cropinghigh/zynq_a9_mb/software/FPGA_VIVADO/Platform/Platform.runs/design_1_axi_vdma_0_0_synth_1/.vivado.begin.rst

<?xml version="1.0"?>
<ProcessHandle Version="1" Minor="0">
    <Process Command="vivado" Owner="indir" Host="indir-homePc" Pid="3502113" HostCore="4" HostMemory="26538112">
    </Process>
</ProcessHandle>
