cropinghigh/zynq_a9_mb/software/FPGA_VIVADO/Platform/Platform.runs/impl_1/.init_design.begin.rst

<?xml version="1.0"?>
<ProcessHandle Version="1" Minor="0">
    <Process Command=".planAhead." Owner="indir" Host="" Pid="3506964">
    </Process>
</ProcessHandle>
