cropinghigh/zynq_a9_mb/hardware/zynq_test_components_1.2.ods

Reference | Qty | Value | Footprint | Antminer S9 board reference | Red means that additional components of that value needed
BT1 | 1 | 3V | Connector_PinHeader_2.54mm:PinHeader_1x02_P2.54mm_Vertical |  | Yellow means value isn’t present on Antimer S9 board, or is far from required count
C1, C2, C3, C4, C5, C6, C7, C8, C9, C10, C16, C17, C51, C52, C53, C54, C59, C60, C61, C64, C65, C66, C67, C68, C69, C70, C71, C72, C73, C75, C76, C79, C80, C81, C82, C88, C94, C96, C105, C112, C114, C144, C146, C148, C149, C157, C171, C179, C182, C183, C188, C190, C191, C198, C200, C201, C210, C211, C214, C216 | 60 | 10u | Capacitor_SMD:C_0603_1608Metric
C11, C12, C13, C14, C15 | 5 | 3.3n | Capacitor_SMD:C_0402_1005Metric_Pad0.74x0.62mm_HandSolder | C207, C208, C215, C216, C224
C18, C19, C20, C21, C23, C28, C29, C30, C31, C32, C33, C34, C35, C36, C37, C38, C39, C40, C41, C42, C43, C44, C45, C46, C47, C48, C49, C50, C55, C56, C57, C58, C62, C63, C87, C89, C90, C92, C93, C95, C97, C98, C99, C100, C101, C103, C104, C106, C107, C108, C109, C110, C111, C115, C116, C117, C118, C119, C120, C121, C122, C123, C124, C125, C126, C127, C128, C129, C130, C131, C132, C133, C134, C135, C136, C137, C138, C139, C141, C143, C145, C147, C150, C151, C152, C153, C154, C156, C158, C159, C160, C163, C164, C165, C166, C167, C168, C169, C170, C172, C173, C174, C175, C176, C177, C178, C180, C181, C184, C185, C187, C189, C192, C193, C194, C195, C196, C197, C202, C203, C204, C205, C206, C207, C208, C209, C212, C213, C215, C217 | 130 | 0.47u | Capacitor_SMD:C_0603_1608Metric
C22, C24, C25, C26, C27 | 5 | 22u | Capacitor_SMD:C_0805_2012Metric_Pad1.18x1.45mm_HandSolder | C203, C206, C212, C214, C219
C74, C77, C78, C83, C84, C85, C86, C91, C102, C113, C140, C142, C155, C199 | 14 | 100u | Capacitor_SMD:C_1206_3216Metric_Pad1.33x1.80mm_HandSolder | C10,C14,C23,C24,C34,C43,C56,C57,C58,C71,C79,C88,C92,C104,C124
C161, C162 | 2 | 12p | Capacitor_SMD:C_0402_1005Metric_Pad0.74x0.62mm_HandSolder | C171, C172
C186 | 1 | 1n | Capacitor_SMD:C_1206_3216Metric_Pad1.33x1.80mm_HandSolder | C167
D1 | 1 | ZMM7V5 | Diode_SMD:D_MiniMELF_Handsoldering
D2, D17, D21 | 3 | 1N5822 | Diode_SMD:D_SMA
D3 | 1 | GREEN PWR_OK | LED_SMD:LED_0603_1608Metric_Pad1.05x0.95mm_HandSolder
D4 | 1 | GREEN 5V | LED_SMD:LED_0603_1608Metric_Pad1.05x0.95mm_HandSolder
D5 | 1 | GREEN 2V5 | LED_SMD:LED_0603_1608Metric_Pad1.05x0.95mm_HandSolder
D6 | 1 | GREEN 3V3 | LED_SMD:LED_0603_1608Metric_Pad1.05x0.95mm_HandSolder
D7 | 1 | YELLOW INIT_B | LED_SMD:LED_0603_1608Metric_Pad1.05x0.95mm_HandSolder
D8 | 1 | GREEN DONE | LED_SMD:LED_0603_1608Metric_Pad1.05x0.95mm_HandSolder
D9 | 1 | GREEN IO1 | LED_SMD:LED_0603_1608Metric_Pad1.05x0.95mm_HandSolder
D10 | 1 | RED IO2 | LED_SMD:LED_0603_1608Metric_Pad1.05x0.95mm_HandSolder
D11 | 1 | BLUE IO3 | LED_SMD:LED_0603_1608Metric_Pad1.05x0.95mm_HandSolder
D12 | 1 | YELLOW IO4 | LED_SMD:LED_0603_1608Metric_Pad1.05x0.95mm_HandSolder
D13, D14, D15, D22 | 4 | CDDFN10-0524P | Package_DFN_QFN:Diodes_UDFN-10_1.0x2.5mm_P0.5mm
D16 | 1 | BLUE ETH_LED1 | LED_SMD:LED_0603_1608Metric_Pad1.05x0.95mm_HandSolder
D18 | 1 | YELLOW MIO0 | LED_SMD:LED_0603_1608Metric_Pad1.05x0.95mm_HandSolder
D19 | 1 | GREEN MIO7 | LED_SMD:LED_0603_1608Metric_Pad1.05x0.95mm_HandSolder
D20 | 1 | RED MIO8 | LED_SMD:LED_0603_1608Metric_Pad1.05x0.95mm_HandSolder
D23 | 1 | RED USB OVERLOAD | LED_SMD:LED_0603_1608Metric_Pad1.05x0.95mm_HandSolder
F1 | 1 | PWRIN_CONN | Fuse:Fuse_1206_3216Metric
F2 | 1 | PWR_USB | Fuse:Fuse_1206_3216Metric
FB1, FB2, FB3, FB4, FB5, FB6, FB10, FB11, FB12, FB13, FB14, FB18 | 12 | 100R | Inductor_SMD:L_1206_3216Metric_Pad1.42x1.75mm_HandSolder
FB7, FB8, FB9, FB15, FB16, FB17 | 6 | 100R/3A | Inductor_SMD:L_0805_2012Metric_Pad1.15x1.40mm_HandSolder | FB1, FB2, FB3, FB4, FB5, FB6
J1 | 1 | PWRIN | Connector_BarrelJack:BarrelJack_Horizontal
J2 | 1 | JTAG_SMALL | Connector_PinHeader_2.00mm:PinHeader_2x07_P2.00mm_Vertical
J3 | 1 | PL_IO_A | Connector_PinHeader_2.00mm:PinHeader_2x14_P2.00mm_Vertical
J4 | 1 | PL_IO_B | Connector_PinHeader_2.00mm:PinHeader_2x14_P2.00mm_Vertical
J5 | 1 | PL_IO_C | Connector_PinHeader_2.00mm:PinHeader_2x14_P2.00mm_Vertical
J6 | 1 | PL_IO_D | Connector_PinHeader_2.00mm:PinHeader_2x14_P2.00mm_Vertical
J7 | 1 | RJ45 | Connector_RJ:RJ45_Amphenol_RJHSE538X | J13
J8 | 1 | DISPLAY | Connector_PinHeader_2.00mm:PinHeader_2x11_P2.00mm_Vertical
J9 | 1 | ADC | Connector_PinHeader_2.54mm:PinHeader_1x02_P2.54mm_Vertical
J10 | 1 | UART | Connector_PinHeader_2.54mm:PinHeader_1x03_P2.54mm_Vertical
J11 | 1 | I2C | Connector_PinHeader_2.54mm:PinHeader_1x03_P2.54mm_Vertical
J12, J13 | 2 | MicroSD | footprints:microSD_ali
J14 | 1 | USB_C | Connector_USB:USB_C_Receptacle_HCTL_HC-TYPE-C-16P-01A
L1, L2, L3, L4 | 4 | 1u | Inductor_SMD:L_APV_ANR3010 | L2, L3, L4, L5
L5 | 1 | 2.2u | Inductor_SMD:L_APV_ANR8040 | L1
R1, R33, R34, R37, R38, R39, R41, R42, R43, R44, R50, R93, R103, R105, R138, R143, R146, R150, R90, R147 | 20 | 4.7k | Resistor_SMD:R_0402_1005Metric_Pad0.72x0.64mm_HandSolder | R5,R6,R7,R8,R10,R11,R15,R22,R25,R36,R58,R83,R92,R107,R110,R111,R112,R113,R114,R115,R116,R117,R118,R119,R120,R121,R122,R123,R124,R125,R126,R127,R128,R129,R130,R131,R132,R133,R134,R135,R136,R139,R140,R143,R144,R147,R148,R169,R174,R176,R177,R183,R184,R185,R186
R2 | 1 | 17.4k | Resistor_SMD:R_0402_1005Metric_Pad0.72x0.64mm_HandSolder | R171
R3, R5, R7, R79, R80, R81, R82, R83, R84, R85, R86, R87, R88, R94 | 14 | 20k | Resistor_SMD:R_0402_1005Metric_Pad0.72x0.64mm_HandSolder | R1, R2, R3, R4, R28, R29, R30, R157, R165, R173, R175
R4 | 1 | 24.9k | Resistor_SMD:R_0402_1005Metric_Pad0.72x0.64mm_HandSolder | R161
R6, R46 | 2 | 42.2k | Resistor_SMD:R_0402_1005Metric_Pad0.72x0.64mm_HandSolder | R152
R8, R29 | 2 | 61.9k | Resistor_SMD:R_0402_1005Metric_Pad0.72x0.64mm_HandSolder | R159
R9, R11 | 2 | 19.6k | Resistor_SMD:R_0402_1005Metric_Pad0.72x0.64mm_HandSolder | R156, R166
R10, R17, R19, R21, R23, R25 | 6 | 4.99k | Resistor_SMD:R_0402_1005Metric_Pad0.72x0.64mm_HandSolder | R150, R154, R155, R163, R164,R172
R12, R13, R14, R15, R51, R52, R113, R124, R125, R126, R151, R155, R158, R161 | 14 | 0 | Resistor_SMD:R_0402_1005Metric_Pad0.72x0.64mm_HandSolder | R9, R12, R13, R14, R16, R23, R85, R86, R101, R103, R105, R106
R16, R18, R20, R30, R35, R40, R100, R101, R102, R140, R141, R142, R144, R145, R156, R157, R159, R160, R92 | 19 | 1k | Resistor_SMD:R_0402_1005Metric_Pad0.72x0.64mm_HandSolder | R19,R20,R32,R33,R37,R38,R39,R50,R52,R53,R54,R88,R89,R90,R91,R108,R151,R160,R170,R187,R188,R189,R190
R22 | 1 | 1.58k | Resistor_SMD:R_0402_1005Metric_Pad0.72x0.64mm_HandSolder | R162
R24, R77, R78, R104, R106, R127, R128, R129, R130, R131, R132, R133, R134, R135, R136, R149 | 16 | 240 | Resistor_SMD:R_0402_1005Metric_Pad0.72x0.64mm_HandSolder | R55, R56, R153
R26, R27, R47 | 3 | 140k | Resistor_SMD:R_0402_1005Metric_Pad0.72x0.64mm_HandSolder
R28, R107 | 2 | 15k | Resistor_SMD:R_0402_1005Metric_Pad0.72x0.64mm_HandSolder
R31, R32, R137, R154 | 4 | 8k | Resistor_SMD:R_0402_1005Metric_Pad0.72x0.64mm_HandSolder
R36, R152, R153 | 3 | 200k | Resistor_SMD:R_0402_1005Metric_Pad0.72x0.64mm_HandSolder | R21, R87
R45, R53, R54, R55, R56, R57, R59, R60, R61, R62, R63, R64, R65, R66, R67, R68, R69, R70, R71, R72, R73, R74, R75, R76, R89, R95, R96, R97, R98, R112, R114, R115, R116, R117, R118, R119, R120, R121, R122, R123, R139 | 41 | 40 | Resistor_SMD:R_0402_1005Metric_Pad0.72x0.64mm_HandSolder | R59, R60,R61, R62, R63, R64, R65, R66, R67, R68, R69, R70, R71, R72, R73, R74, R75, R76, R77, R78, R79, R80, R81, R82
R48, R49, R58, R108, R109, R110, R111 | 7 | 80 | Resistor_SMD:R_0402_1005Metric_Pad0.72x0.64mm_HandSolder | R40, R41, R42, R95, R96, R97, R98
R91, R148, R162, R163 | 4 | 820 | Resistor_SMD:R_0402_1005Metric_Pad0.72x0.64mm_HandSolder
R99 | 1 | 1.24k | Resistor_SMD:R_0402_1005Metric_Pad0.72x0.64mm_HandSolder | R109
SW1 | 1 | POR | Button_Switch_THT:SW_SPST_Omron_B3F-315x_Angled | S1
SW2 | 1 | BOOT_MODE_1 | Button_Switch_SMD:SW_SPDT_PCM12
SW3 | 1 | BOOT_MODE_2 | Button_Switch_SMD:SW_SPDT_PCM12
SW4 | 1 | SD_SEL | Button_Switch_SMD:SW_SPDT_PCM12
TR1 | 1 | G2405CG | Transformer_SMD:Transformer_Ethernet_Bourns_PT61020EL | T1
U1, U2, U3, U4, U5 | 5 | TLV62130RGTR | footprints:QFN50P300X300X100-17N | U9, U10, U11, U12, U13
U6 | 1 | TPS51200DRC | Package_SON:VSON-10-1EP_3x3mm_P0.5mm_EP1.65x2.4mm | U14
U7, U16, U17 | 3 | LSF0102DCTR | footprints:SOP65P400X130-8N | U2, U7
U8, U9 | 2 | nt5cc128m16ip-di | footprints:BGA96C80P6X16_800X1400X120 | U3, U4
U10 | 1 | XC7Z010-1CLG400C | footprints:CLG400_XIL-L | U1
U11 | 1 | SDIN7DP2-8G | footprints:MICRON_EMMC_153-12
U12 | 1 | MX25L1606E | Package_SO:SOIC-8_5.3x5.3mm_P1.27mm
U13 | 1 | B50612 | Package_DFN_QFN:Infineon_MLPQ-48-1EP_7x7mm_P0.5mm_EP5.15x5.15mm | U8
U14 | 1 | USB3315 | Package_DFN_QFN:QFN-24-1EP_4x4mm_P0.5mm_EP2.5x2.5mm
U15 | 1 | TXS02612RTW | Package_DFN_QFN:WQFN-24-1EP_4x4mm_P0.5mm_EP2.45x2.45mm_ThermalVias | U6
U18 | 1 | DS1307Z+ | Package_SO:SOIC-8_3.9x4.9mm_P1.27mm
U19 | 1 | LM3525-H | Package_SO:SOIC-8_3.9x4.9mm_P1.27mm
Y1 | 1 | 33.333M | Oscillator:Oscillator_SMD_EuroQuartz_XO32-4Pin_3.2x2.5mm | Y1
Y2 | 1 | 25M | Oscillator:Oscillator_SMD_EuroQuartz_XO32-4Pin_3.2x2.5mm | Y4
Y3 | 1 | 32.768k | Crystal:Crystal_C38-LF_D3.0mm_L8.0mm_Vertical
Y4 | 1 | 24M | Oscillator:Oscillator_SMD_EuroQuartz_XO53-4Pin_5.0x3.2mm
