cropinghigh/zynq_a9_mb/hardware/LSF0102DCTR.step

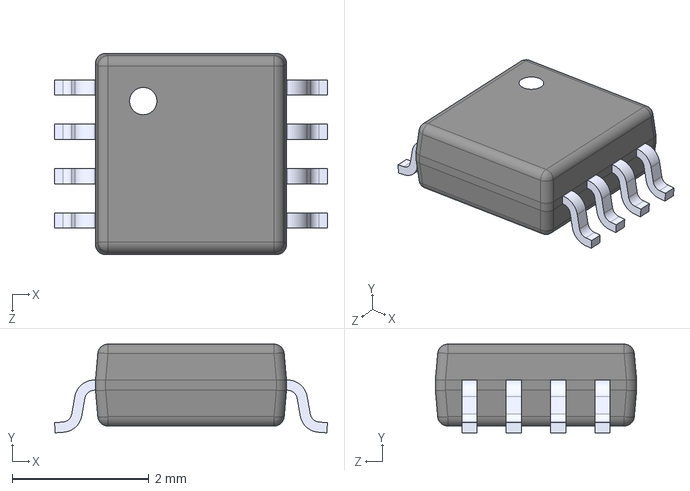
[picture p34: CAD file, 2025-09-22]
hardware/LSF0102DCTR.step
4.00 x 1.30 x 2.95 mm
