cropinghigh/zynq_a9_mb/hardware/MT41J128M16JT-125_KTR.step

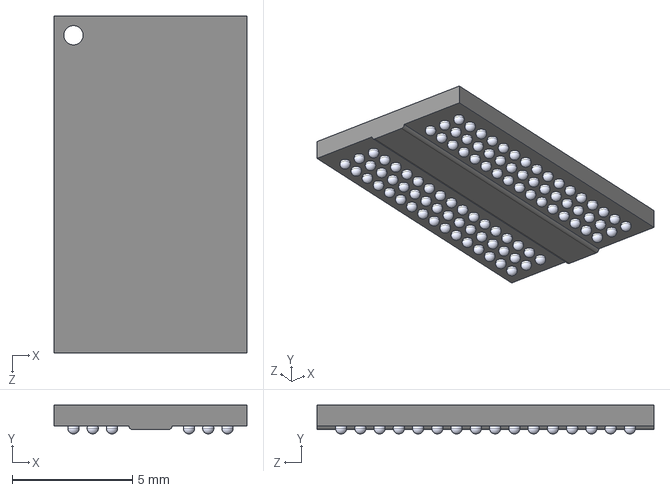
[picture p35: CAD file, 2025-09-22]
hardware/MT41J128M16JT-125_KTR.step
8.00 x 1.20 x 14.0 mm
