cropinghigh/zynq_a9_mb/hardware/EMMC04G-S100-B08U.step

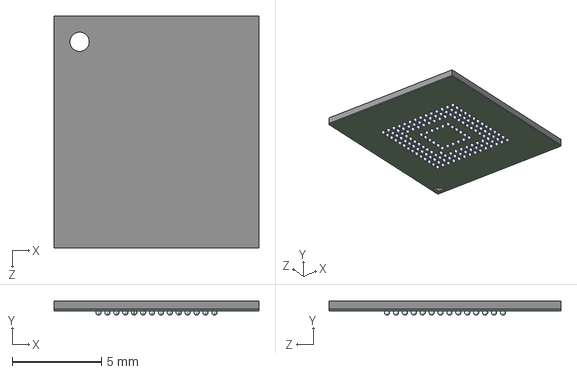
[picture p36: CAD file, 2025-09-22]
hardware/EMMC04G-S100-B08U.step
11.5 x 0.8 x 13.0 mm
