cropinghigh/zynq_a9_mb/hardware/TLV62130RGTR.step

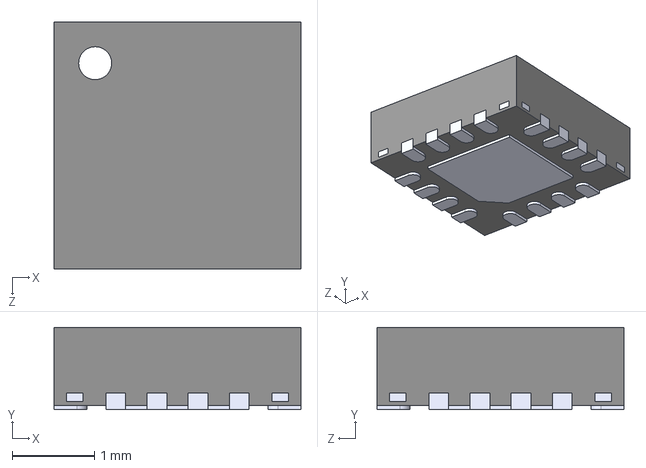
[picture p37: CAD file, 2025-09-22]
hardware/TLV62130RGTR.step
3.00 x 1.00 x 3.00 mm
