cropinghigh/zynq_a9_mb/hardware/schematic.pdf

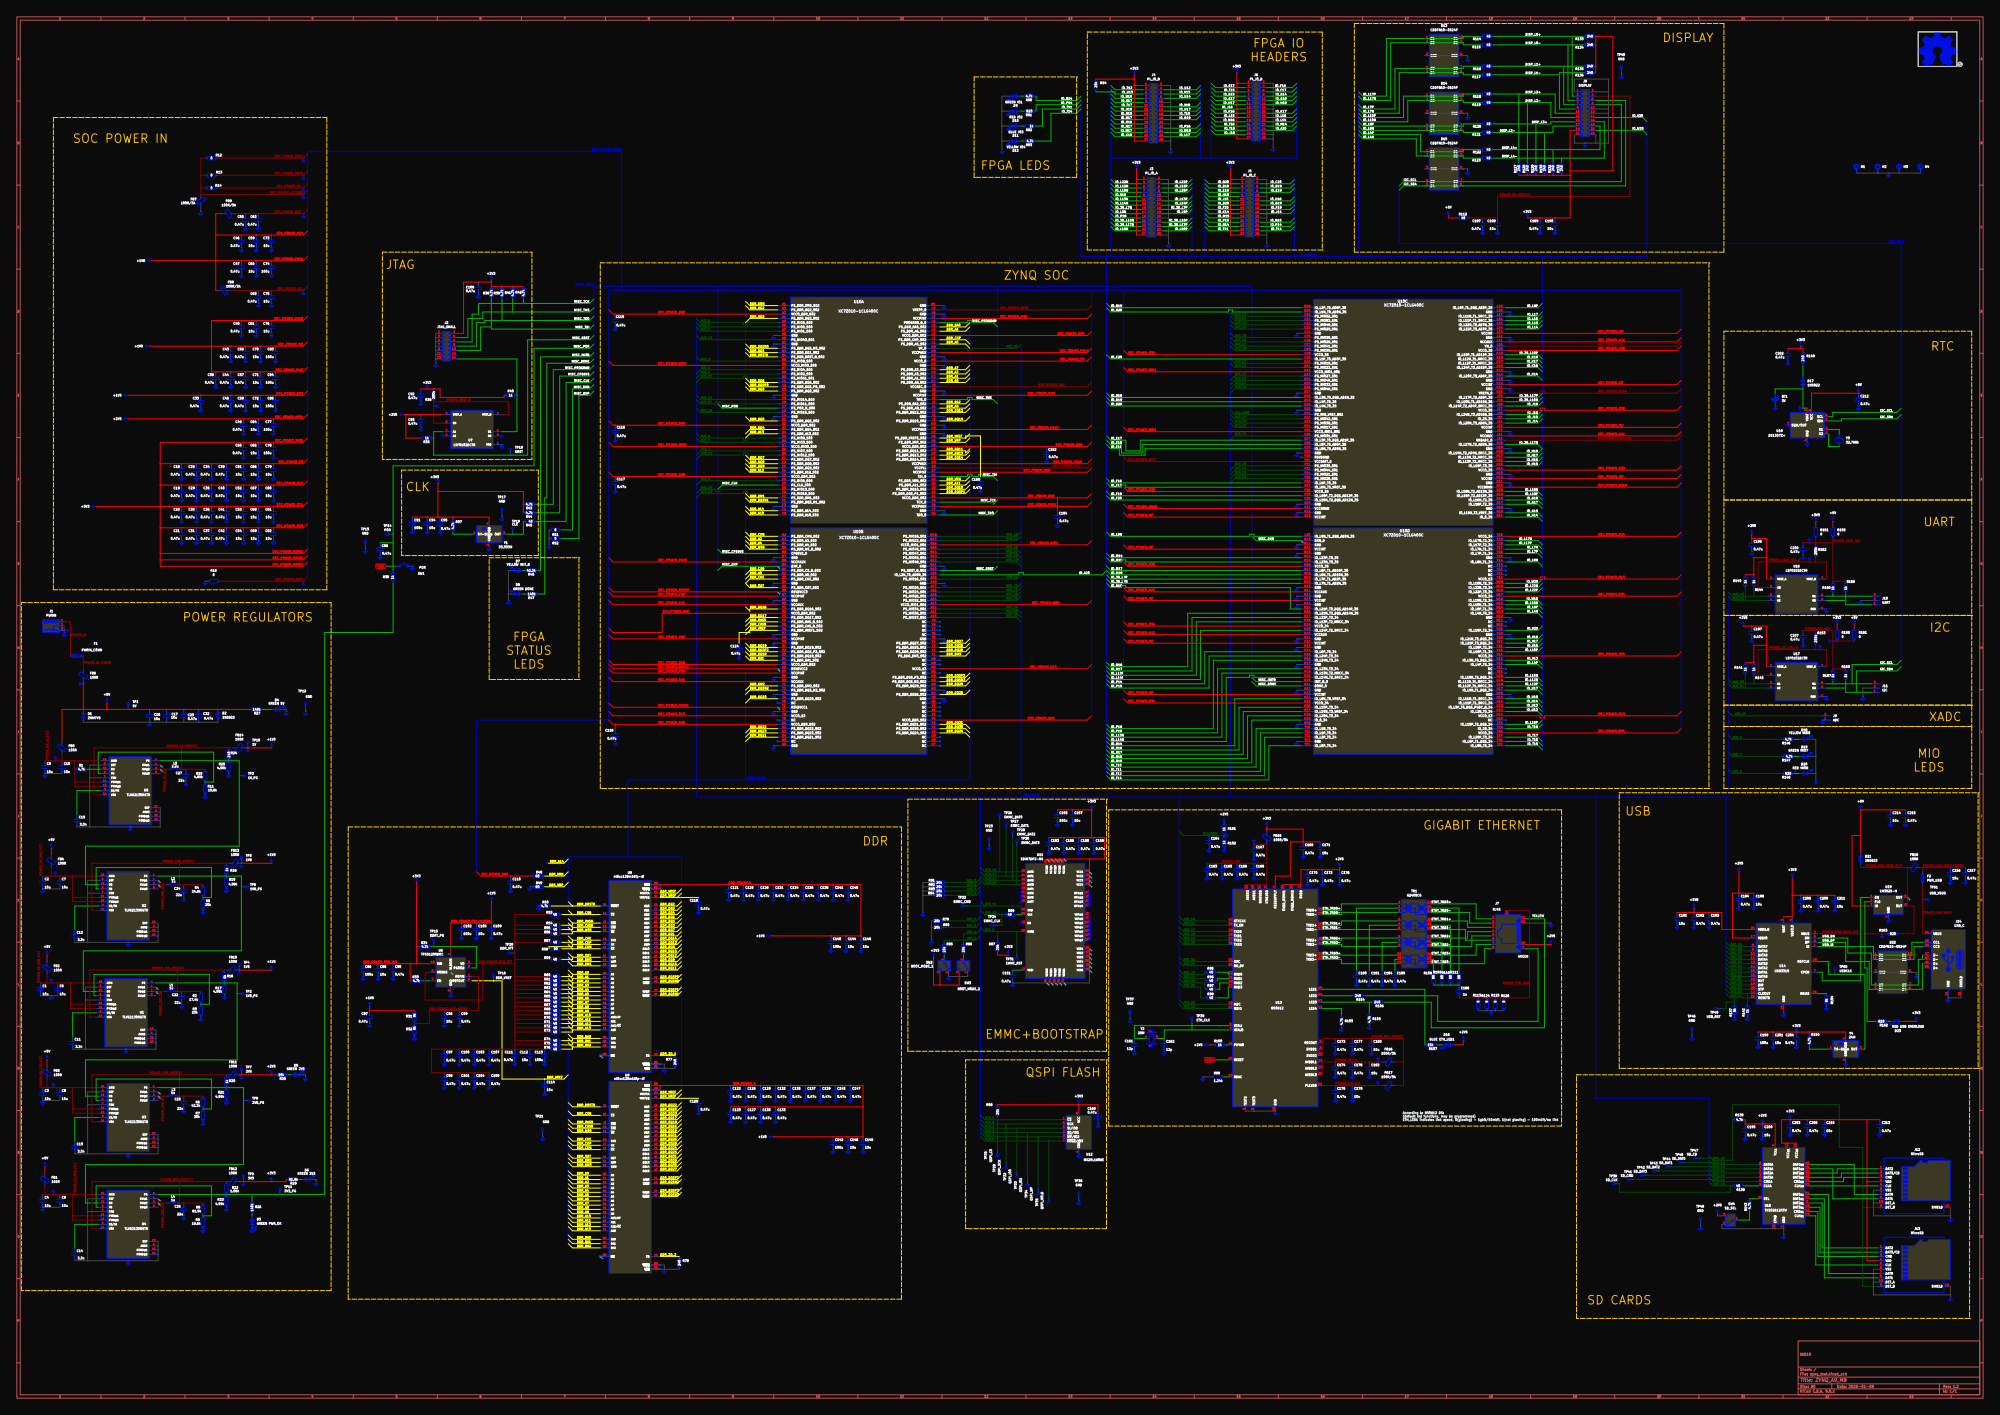
[picture p38: page 1]
