cropinghigh/zynq_a9_mb/software/FPGA_VIVADO/Platform/Platform.runs/design_1_processing_system7_0_0_synth_1/.Xil/design_1_processing_system7_0_0_propImpl.xdc

set_property SRC_FILE_INFO {cfile:/home/indir/KiCad/zynq_a9_mb/software/FPGA_VIVADO/Platform/Platform.gen/sources_1/bd/design_1/ip/design_1_processing_system7_0_0/design_1_processing_system7_0_0.xdc rfile:../../../Platform.gen/sources_1/bd/design_1/ip/design_1_processing_system7_0_0/design_1_processing_system7_0_0.xdc id:1 order:EARLY scoped_inst:inst} [current_design]
current_instance inst
set_property src_info {type:SCOPED_XDC file:1 line:20 export:INPUT save:INPUT read:READ} [current_design]
set_output_delay -clock [get_clocks PJTAG_TCK] -clock_fall -min -6.000 [get_ports PJTAG_TDO]
set_property src_info {type:SCOPED_XDC file:1 line:21 export:INPUT save:INPUT read:READ} [current_design]
set_output_delay -clock [get_clocks PJTAG_TCK] -clock_fall -max 15.000 [get_ports PJTAG_TDO]
set_property src_info {type:SCOPED_XDC file:1 line:22 export:INPUT save:INPUT read:READ} [current_design]
set_output_delay -clock [get_clocks PJTAG_TCK] -clock_fall -min 6.000 [get_ports PJTAG_TDO]
set_property src_info {type:SCOPED_XDC file:1 line:23 export:INPUT save:INPUT read:READ} [current_design]
set_output_delay -clock [get_clocks PJTAG_TCK] -clock_fall -max 15.000 [get_ports PJTAG_TDO]
set_property src_info {type:SCOPED_XDC file:1 line:28 export:INPUT save:INPUT read:READ} [current_design]
set_input_jitter clk_fpga_0 30
set_property src_info {type:SCOPED_XDC file:1 line:31 export:INPUT save:INPUT read:READ} [current_design]
set_input_jitter clk_fpga_1 0.6
set_property src_info {type:SCOPED_XDC file:1 line:34 export:INPUT save:INPUT read:READ} [current_design]
set_input_jitter clk_fpga_2 0.3
set_property src_info {type:SCOPED_XDC file:1 line:37 export:INPUT save:INPUT read:READ} [current_design]
set_input_jitter clk_fpga_3 0.19497
set_property src_info {type:SCOPED_XDC file:1 line:47 export:INPUT save:INPUT read:READ} [current_design]
set_property PACKAGE_PIN "C11" [get_ports "MIO[53]"]
set_property src_info {type:SCOPED_XDC file:1 line:54 export:INPUT save:INPUT read:READ} [current_design]
set_property PACKAGE_PIN "C10" [get_ports "MIO[52]"]
set_property src_info {type:SCOPED_XDC file:1 line:61 export:INPUT save:INPUT read:READ} [current_design]
set_property PACKAGE_PIN "B9" [get_ports "MIO[51]"]
set_property src_info {type:SCOPED_XDC file:1 line:68 export:INPUT save:INPUT read:READ} [current_design]
set_property PACKAGE_PIN "B13" [get_ports "MIO[50]"]
set_property src_info {type:SCOPED_XDC file:1 line:75 export:INPUT save:INPUT read:READ} [current_design]
set_property PACKAGE_PIN "C12" [get_ports "MIO[49]"]
set_property src_info {type:SCOPED_XDC file:1 line:82 export:INPUT save:INPUT read:READ} [current_design]
set_property PACKAGE_PIN "B12" [get_ports "MIO[48]"]
set_property src_info {type:SCOPED_XDC file:1 line:89 export:INPUT save:INPUT read:READ} [current_design]
set_property PACKAGE_PIN "B14" [get_ports "MIO[47]"]
set_property src_info {type:SCOPED_XDC file:1 line:95 export:INPUT save:INPUT read:READ} [current_design]
set_property PACKAGE_PIN "D16" [get_ports "MIO[46]"]
set_property src_info {type:SCOPED_XDC file:1 line:102 export:INPUT save:INPUT read:READ} [current_design]
set_property PACKAGE_PIN "B15" [get_ports "MIO[45]"]
set_property src_info {type:SCOPED_XDC file:1 line:109 export:INPUT save:INPUT read:READ} [current_design]
set_property PACKAGE_PIN "F13" [get_ports "MIO[44]"]
set_property src_info {type:SCOPED_XDC file:1 line:116 export:INPUT save:INPUT read:READ} [current_design]
set_property PACKAGE_PIN "A9" [get_ports "MIO[43]"]
set_property src_info {type:SCOPED_XDC file:1 line:123 export:INPUT save:INPUT read:READ} [current_design]
set_property PACKAGE_PIN "E12" [get_ports "MIO[42]"]
set_property src_info {type:SCOPED_XDC file:1 line:130 export:INPUT save:INPUT read:READ} [current_design]
set_property PACKAGE_PIN "C17" [get_ports "MIO[41]"]
set_property src_info {type:SCOPED_XDC file:1 line:137 export:INPUT save:INPUT read:READ} [current_design]
set_property PACKAGE_PIN "D14" [get_ports "MIO[40]"]
set_property src_info {type:SCOPED_XDC file:1 line:144 export:INPUT save:INPUT read:READ} [current_design]
set_property PACKAGE_PIN "C18" [get_ports "MIO[39]"]
set_property src_info {type:SCOPED_XDC file:1 line:151 export:INPUT save:INPUT read:READ} [current_design]
set_property PACKAGE_PIN "E13" [get_ports "MIO[38]"]
set_property src_info {type:SCOPED_XDC file:1 line:158 export:INPUT save:INPUT read:READ} [current_design]
set_property PACKAGE_PIN "A10" [get_ports "MIO[37]"]
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
set_property src_info {type:SCOPED_XDC file:1 line:347 export:INPUT save:INPUT read:READ} [current_design]
set_property PACKAGE_PIN "E9" [get_ports "MIO[10]"]
set_property src_info {type:SCOPED_XDC file:1 line:354 export:INPUT save:INPUT read:READ} [current_design]
set_property PACKAGE_PIN "B5" [get_ports "MIO[9]"]
set_property src_info {type:SCOPED_XDC file:1 line:361 export:INPUT save:INPUT read:READ} [current_design]
set_property PACKAGE_PIN "D5" [get_ports "MIO[8]"]
set_property src_info {type:SCOPED_XDC file:1 line:367 export:INPUT save:INPUT read:READ} [current_design]
set_property PACKAGE_PIN "D8" [get_ports "MIO[7]"]
set_property src_info {type:SCOPED_XDC file:1 line:373 export:INPUT save:INPUT read:READ} [current_design]
set_property PACKAGE_PIN "A5" [get_ports "MIO[6]"]
set_property src_info {type:SCOPED_XDC file:1 line:379 export:INPUT save:INPUT read:READ} [current_design]
set_property PACKAGE_PIN "A6" [get_ports "MIO[5]"]
set_property src_info {type:SCOPED_XDC file:1 line:385 export:INPUT save:INPUT read:READ} [current_design]
set_property PACKAGE_PIN "B7" [get_ports "MIO[4]"]
set_property src_info {type:SCOPED_XDC file:1 line:391 export:INPUT save:INPUT read:READ} [current_design]
set_property PACKAGE_PIN "D6" [get_ports "MIO[3]"]
set_property src_info {type:SCOPED_XDC file:1 line:397 export:INPUT save:INPUT read:READ} [current_design]
set_property PACKAGE_PIN "B8" [get_ports "MIO[2]"]
set_property src_info {type:SCOPED_XDC file:1 line:403 export:INPUT save:INPUT read:READ} [current_design]
set_property PACKAGE_PIN "A7" [get_ports "MIO[1]"]
set_property src_info {type:SCOPED_XDC file:1 line:410 export:INPUT save:INPUT read:READ} [current_design]
set_property PACKAGE_PIN "E6" [get_ports "MIO[0]"]
set_property src_info {type:SCOPED_XDC file:1 line:415 export:INPUT save:INPUT read:READ} [current_design]
set_property PACKAGE_PIN "H5" [get_ports "DDR_VRP"]
set_property src_info {type:SCOPED_XDC file:1 line:419 export:INPUT save:INPUT read:READ} [current_design]
set_property PACKAGE_PIN "G5" [get_ports "DDR_VRN"]
set_property src_info {type:SCOPED_XDC file:1 line:423 export:INPUT save:INPUT read:READ} [current_design]
set_property PACKAGE_PIN "M5" [get_ports "DDR_WEB"]
set_property src_info {type:SCOPED_XDC file:1 line:427 export:INPUT save:INPUT read:READ} [current_design]
set_property PACKAGE_PIN "P4" [get_ports "DDR_RAS_n"]
set_property src_info {type:SCOPED_XDC file:1 line:431 export:INPUT save:INPUT read:READ} [current_design]
set_property PACKAGE_PIN "N5" [get_ports "DDR_ODT"]
set_property src_info {type:SCOPED_XDC file:1 line:435 export:INPUT save:INPUT read:READ} [current_design]
set_property PACKAGE_PIN "B4" [get_ports "DDR_DRSTB"]
set_property src_info {type:SCOPED_XDC file:1 line:439 export:INPUT save:INPUT read:READ} [current_design]
set_property PACKAGE_PIN "W5" [get_ports "DDR_DQS[3]"]
set_property src_info {type:SCOPED_XDC file:1 line:443 export:INPUT save:INPUT read:READ} [current_design]
set_property PACKAGE_PIN "R2" [get_ports "DDR_DQS[2]"]
set_property src_info {type:SCOPED_XDC file:1 line:447 export:INPUT save:INPUT read:READ} [current_design]
set_property PACKAGE_PIN "G2" [get_ports "DDR_DQS[1]"]
set_property src_info {type:SCOPED_XDC file:1 line:451 export:INPUT save:INPUT read:READ} [current_design]
set_property PACKAGE_PIN "C2" [get_ports "DDR_DQS[0]"]
set_property src_info {type:SCOPED_XDC file:1 line:455 export:INPUT save:INPUT read:READ} [current_design]
set_property PACKAGE_PIN "W4" [get_ports "DDR_DQS_n[3]"]
set_property src_info {type:SCOPED_XDC file:1 line:459 export:INPUT save:INPUT read:READ} [current_design]
set_property PACKAGE_PIN "T2" [get_ports "DDR_DQS_n[2]"]
set_property src_info {type:SCOPED_XDC file:1 line:463 export:INPUT save:INPUT read:READ} [current_design]
set_property PACKAGE_PIN "F2" [get_ports "DDR_DQS_n[1]"]
set_property src_info {type:SCOPED_XDC file:1 line:467 export:INPUT save:INPUT read:READ} [current_design]
set_property PACKAGE_PIN "B2" [get_ports "DDR_DQS_n[0]"]
set_property src_info {type:SCOPED_XDC file:1 line:471 export:INPUT save:INPUT read:READ} [current_design]
set_property PACKAGE_PIN "E3" [get_ports "DDR_DQ[9]"]
set_property src_info {type:SCOPED_XDC file:1 line:475 export:INPUT save:INPUT read:READ} [current_design]
set_property PACKAGE_PIN "E2" [get_ports "DDR_DQ[8]"]
set_property src_info {type:SCOPED_XDC file:1 line:479 export:INPUT save:INPUT read:READ} [current_design]
set_property PACKAGE_PIN "E1" [get_ports "DDR_DQ[7]"]
set_property src_info {type:SCOPED_XDC file:1 line:483 export:INPUT save:INPUT read:READ} [current_design]
set_property PACKAGE_PIN "C1" [get_ports "DDR_DQ[6]"]
set_property src_info {type:SCOPED_XDC file:1 line:487 export:INPUT save:INPUT read:READ} [current_design]
set_property PACKAGE_PIN "D1" [get_ports "DDR_DQ[5]"]
set_property src_info {type:SCOPED_XDC file:1 line:491 export:INPUT save:INPUT read:READ} [current_design]
set_property PACKAGE_PIN "D3" [get_ports "DDR_DQ[4]"]
set_property src_info {type:SCOPED_XDC file:1 line:495 export:INPUT save:INPUT read:READ} [current_design]
set_property PACKAGE_PIN "A4" [get_ports "DDR_DQ[3]"]
set_property src_info {type:SCOPED_XDC file:1 line:499 export:INPUT save:INPUT read:READ} [current_design]
set_property PACKAGE_PIN "V3" [get_ports "DDR_DQ[31]"]
set_property src_info {type:SCOPED_XDC file:1 line:503 export:INPUT save:INPUT read:READ} [current_design]
set_property PACKAGE_PIN "V2" [get_ports "DDR_DQ[30]"]
set_property src_info {type:SCOPED_XDC file:1 line:507 export:INPUT save:INPUT read:READ} [current_design]
set_property PACKAGE_PIN "A2" [get_ports "DDR_DQ[2]"]
set_property src_info {type:SCOPED_XDC file:1 line:511 export:INPUT save:INPUT read:READ} [current_design]
set_property PACKAGE_PIN "W3" [get_ports "DDR_DQ[29]"]
set_property src_info {type:SCOPED_XDC file:1 line:515 export:INPUT save:INPUT read:READ} [current_design]
set_property PACKAGE_PIN "Y2" [get_ports "DDR_DQ[28]"]
set_property src_info {type:SCOPED_XDC file:1 line:519 export:INPUT save:INPUT read:READ} [current_design]
set_property PACKAGE_PIN "Y4" [get_ports "DDR_DQ[27]"]
set_property src_info {type:SCOPED_XDC file:1 line:523 export:INPUT save:INPUT read:READ} [current_design]
set_property PACKAGE_PIN "W1" [get_ports "DDR_DQ[26]"]
set_property src_info {type:SCOPED_XDC file:1 line:527 export:INPUT save:INPUT read:READ} [current_design]
set_property PACKAGE_PIN "Y3" [get_ports "DDR_DQ[25]"]
set_property src_info {type:SCOPED_XDC file:1 line:531 export:INPUT save:INPUT read:READ} [current_design]
set_property PACKAGE_PIN "V1" [get_ports "DDR_DQ[24]"]
set_property src_info {type:SCOPED_XDC file:1 line:535 export:INPUT save:INPUT read:READ} [current_design]
set_property PACKAGE_PIN "U3" [get_ports "DDR_DQ[23]"]
set_property src_info {type:SCOPED_XDC file:1 line:539 export:INPUT save:INPUT read:READ} [current_design]
set_property PACKAGE_PIN "U2" [get_ports "DDR_DQ[22]"]
set_property src_info {type:SCOPED_XDC file:1 line:543 export:INPUT save:INPUT read:READ} [current_design]
set_property PACKAGE_PIN "U4" [get_ports "DDR_DQ[21]"]
set_property src_info {type:SCOPED_XDC file:1 line:547 export:INPUT save:INPUT read:READ} [current_design]
set_property PACKAGE_PIN "T4" [get_ports "DDR_DQ[20]"]
set_property src_info {type:SCOPED_XDC file:1 line:551 export:INPUT save:INPUT read:READ} [current_design]
set_property PACKAGE_PIN "B3" [get_ports "DDR_DQ[1]"]
set_property src_info {type:SCOPED_XDC file:1 line:555 export:INPUT save:INPUT read:READ} [current_design]
set_property PACKAGE_PIN "R1" [get_ports "DDR_DQ[19]"]
set_property src_info {type:SCOPED_XDC file:1 line:559 export:INPUT save:INPUT read:READ} [current_design]
set_property PACKAGE_PIN "R3" [get_ports "DDR_DQ[18]"]
set_property src_info {type:SCOPED_XDC file:1 line:563 export:INPUT save:INPUT read:READ} [current_design]
set_property PACKAGE_PIN "P3" [get_ports "DDR_DQ[17]"]
set_property src_info {type:SCOPED_XDC file:1 line:567 export:INPUT save:INPUT read:READ} [current_design]
set_property PACKAGE_PIN "P1" [get_ports "DDR_DQ[16]"]
set_property src_info {type:SCOPED_XDC file:1 line:571 export:INPUT save:INPUT read:READ} [current_design]
set_property PACKAGE_PIN "J1" [get_ports "DDR_DQ[15]"]
set_property src_info {type:SCOPED_XDC file:1 line:575 export:INPUT save:INPUT read:READ} [current_design]
set_property PACKAGE_PIN "H1" [get_ports "DDR_DQ[14]"]
set_property src_info {type:SCOPED_XDC file:1 line:579 export:INPUT save:INPUT read:READ} [current_design]
set_property PACKAGE_PIN "H2" [get_ports "DDR_DQ[13]"]
set_property src_info {type:SCOPED_XDC file:1 line:583 export:INPUT save:INPUT read:READ} [current_design]
set_property PACKAGE_PIN "J3" [get_ports "DDR_DQ[12]"]
set_property src_info {type:SCOPED_XDC file:1 line:587 export:INPUT save:INPUT read:READ} [current_design]
set_property PACKAGE_PIN "H3" [get_ports "DDR_DQ[11]"]
set_property src_info {type:SCOPED_XDC file:1 line:591 export:INPUT save:INPUT read:READ} [current_design]
set_property PACKAGE_PIN "G3" [get_ports "DDR_DQ[10]"]
set_property src_info {type:SCOPED_XDC file:1 line:595 export:INPUT save:INPUT read:READ} [current_design]
set_property PACKAGE_PIN "C3" [get_ports "DDR_DQ[0]"]
set_property src_info {type:SCOPED_XDC file:1 line:599 export:INPUT save:INPUT read:READ} [current_design]
set_property PACKAGE_PIN "Y1" [get_ports "DDR_DM[3]"]
set_property src_info {type:SCOPED_XDC file:1 line:603 export:INPUT save:INPUT read:READ} [current_design]
set_property PACKAGE_PIN "T1" [get_ports "DDR_DM[2]"]
set_property src_info {type:SCOPED_XDC file:1 line:607 export:INPUT save:INPUT read:READ} [current_design]
set_property PACKAGE_PIN "F1" [get_ports "DDR_DM[1]"]
set_property src_info {type:SCOPED_XDC file:1 line:611 export:INPUT save:INPUT read:READ} [current_design]
set_property PACKAGE_PIN "A1" [get_ports "DDR_DM[0]"]
set_property src_info {type:SCOPED_XDC file:1 line:615 export:INPUT save:INPUT read:READ} [current_design]
set_property PACKAGE_PIN "N1" [get_ports "DDR_CS_n"]
set_property src_info {type:SCOPED_XDC file:1 line:619 export:INPUT save:INPUT read:READ} [current_design]
set_property PACKAGE_PIN "N3" [get_ports "DDR_CKE"]
set_property src_info {type:SCOPED_XDC file:1 line:623 export:INPUT save:INPUT read:READ} [current_design]
set_property PACKAGE_PIN "L2" [get_ports "DDR_Clk"]
set_property src_info {type:SCOPED_XDC file:1 line:627 export:INPUT save:INPUT read:READ} [current_design]
set_property PACKAGE_PIN "M2" [get_ports "DDR_Clk_n"]
set_property src_info {type:SCOPED_XDC file:1 line:631 export:INPUT save:INPUT read:READ} [current_design]
set_property PACKAGE_PIN "P5" [get_ports "DDR_CAS_n"]
set_property src_info {type:SCOPED_XDC file:1 line:635 export:INPUT save:INPUT read:READ} [current_design]
set_property PACKAGE_PIN "J5" [get_ports "DDR_BankAddr[2]"]
set_property src_info {type:SCOPED_XDC file:1 line:639 export:INPUT save:INPUT read:READ} [current_design]
set_property PACKAGE_PIN "R4" [get_ports "DDR_BankAddr[1]"]
set_property src_info {type:SCOPED_XDC file:1 line:643 export:INPUT save:INPUT read:READ} [current_design]
set_property PACKAGE_PIN "L5" [get_ports "DDR_BankAddr[0]"]
set_property src_info {type:SCOPED_XDC file:1 line:647 export:INPUT save:INPUT read:READ} [current_design]
set_property PACKAGE_PIN "J4" [get_ports "DDR_Addr[9]"]
set_property src_info {type:SCOPED_XDC file:1 line:651 export:INPUT save:INPUT read:READ} [current_design]
set_property PACKAGE_PIN "K1" [get_ports "DDR_Addr[8]"]
set_property src_info {type:SCOPED_XDC file:1 line:655 export:INPUT save:INPUT read:READ} [current_design]
set_property PACKAGE_PIN "K4" [get_ports "DDR_Addr[7]"]
set_property src_info {type:SCOPED_XDC file:1 line:659 export:INPUT save:INPUT read:READ} [current_design]
set_property PACKAGE_PIN "L4" [get_ports "DDR_Addr[6]"]
set_property src_info {type:SCOPED_XDC file:1 line:663 export:INPUT save:INPUT read:READ} [current_design]
set_property PACKAGE_PIN "L1" [get_ports "DDR_Addr[5]"]
set_property src_info {type:SCOPED_XDC file:1 line:667 export:INPUT save:INPUT read:READ} [current_design]
set_property PACKAGE_PIN "M4" [get_ports "DDR_Addr[4]"]
set_property src_info {type:SCOPED_XDC file:1 line:671 export:INPUT save:INPUT read:READ} [current_design]
set_property PACKAGE_PIN "K3" [get_ports "DDR_Addr[3]"]
set_property src_info {type:SCOPED_XDC file:1 line:675 export:INPUT save:INPUT read:READ} [current_design]
set_property PACKAGE_PIN "M3" [get_ports "DDR_Addr[2]"]
set_property src_info {type:SCOPED_XDC file:1 line:679 export:INPUT save:INPUT read:READ} [current_design]
set_property PACKAGE_PIN "K2" [get_ports "DDR_Addr[1]"]
set_property src_info {type:SCOPED_XDC file:1 line:683 export:INPUT save:INPUT read:READ} [current_design]
set_property PACKAGE_PIN "F4" [get_ports "DDR_Addr[14]"]
set_property src_info {type:SCOPED_XDC file:1 line:687 export:INPUT save:INPUT read:READ} [current_design]
set_property PACKAGE_PIN "D4" [get_ports "DDR_Addr[13]"]
set_property src_info {type:SCOPED_XDC file:1 line:691 export:INPUT save:INPUT read:READ} [current_design]
set_property PACKAGE_PIN "E4" [get_ports "DDR_Addr[12]"]
set_property src_info {type:SCOPED_XDC file:1 line:695 export:INPUT save:INPUT read:READ} [current_design]
set_property PACKAGE_PIN "G4" [get_ports "DDR_Addr[11]"]
set_property src_info {type:SCOPED_XDC file:1 line:699 export:INPUT save:INPUT read:READ} [current_design]
set_property PACKAGE_PIN "F5" [get_ports "DDR_Addr[10]"]
set_property src_info {type:SCOPED_XDC file:1 line:703 export:INPUT save:INPUT read:READ} [current_design]
set_property PACKAGE_PIN "N2" [get_ports "DDR_Addr[0]"]
set_property src_info {type:SCOPED_XDC file:1 line:707 export:INPUT save:INPUT read:READ} [current_design]
set_property PACKAGE_PIN "C7" [get_ports "PS_PORB"]
set_property src_info {type:SCOPED_XDC file:1 line:710 export:INPUT save:INPUT read:READ} [current_design]
set_property PACKAGE_PIN "B10" [get_ports "PS_SRSTB"]
set_property src_info {type:SCOPED_XDC file:1 line:713 export:INPUT save:INPUT read:READ} [current_design]
set_property PACKAGE_PIN "E7" [get_ports "PS_CLK"]
