cropinghigh/zynq_a9_mb/software/FPGA_VIVADO/Platform/Platform.runs/synth_1/.Xil/design_1_wrapper_propImpl.xdc

set_property SRC_FILE_INFO {cfile:/home/indir/KiCad/zynq_a9_mb/software/FPGA_VIVADO/Platform/Platform.srcs/constrs_1/new/constrs.xdc rfile:../../../Platform.srcs/constrs_1/new/constrs.xdc id:1} [current_design]
set_property src_info {type:XDC file:1 line:3 export:INPUT save:INPUT read:READ} [current_design]
set_property PACKAGE_PIN U15 [get_ports clkin]
set_property src_info {type:XDC file:1 line:5 export:INPUT save:INPUT read:READ} [current_design]
set_property PACKAGE_PIN V18 [get_ports {ckout[0]}]
set_property src_info {type:XDC file:1 line:7 export:INPUT save:INPUT read:READ} [current_design]
set_property CLOCK_DEDICATED_ROUTE FALSE [get_nets clkin_IBUF]
set_property src_info {type:XDC file:1 line:9 export:INPUT save:INPUT read:READ} [current_design]
set_property PACKAGE_PIN Y18 [get_ports {TMDS_data_p[2]}]
set_property src_info {type:XDC file:1 line:11 export:INPUT save:INPUT read:READ} [current_design]
set_property PACKAGE_PIN Y16 [get_ports {TMDS_data_p[1]}]
set_property src_info {type:XDC file:1 line:12 export:INPUT save:INPUT read:READ} [current_design]
set_property PACKAGE_PIN V15 [get_ports {TMDS_data_p[0]}]
set_property src_info {type:XDC file:1 line:13 export:INPUT save:INPUT read:READ} [current_design]
set_property PACKAGE_PIN W14 [get_ports TMDS_clk_p]
set_property src_info {type:XDC file:1 line:16 export:INPUT save:INPUT read:READ} [current_design]
set_property PACKAGE_PIN T11 [get_ports {LED_D11[0]}]
set_property src_info {type:XDC file:1 line:18 export:INPUT save:INPUT read:READ} [current_design]
set_property PACKAGE_PIN R14 [get_ports {LED_D9[0]}]
set_property src_info {type:XDC file:1 line:20 export:INPUT save:INPUT read:READ} [current_design]
set_property PACKAGE_PIN P14 [get_ports {LED_D10[0]}]
set_property src_info {type:XDC file:1 line:22 export:INPUT save:INPUT read:READ} [current_design]
set_property PACKAGE_PIN T14 [get_ports {LED_D12[0]}]
