cropinghigh/zynq_a9_mb/software/FPGA_VIVADO/Platform/Platform.runs/design_1_v_axi4s_vid_out_0_0_synth_1/.Xil/design_1_v_axi4s_vid_out_0_0_propImpl.xdc

set_property SRC_FILE_INFO {cfile:/drive/data/WinCommon/Common/Programs/Vivado/Vivado/2021.1/data/ip/xpm/xpm_cdc/tcl/xpm_cdc_gray.tcl rfile:../../../../../../../../../../drive/data/WinCommon/Common/Programs/Vivado/Vivado/2021.1/data/ip/xpm/xpm_cdc/tcl/xpm_cdc_gray.tcl id:1 order:LATE scoped_inst:inst/COUPLER_INST/generate_async_fifo.FIFO_INST/XPM_FIFO_ASYNC_INST/gnuram_async_fifo.xpm_fifo_base_inst/gen_cdc_pntr.rd_pntr_cdc_inst unmanaged:yes} [current_design]
set_property SRC_FILE_INFO {cfile:/drive/data/WinCommon/Common/Programs/Vivado/Vivado/2021.1/data/ip/xpm/xpm_cdc/tcl/xpm_cdc_gray.tcl rfile:../../../../../../../../../../drive/data/WinCommon/Common/Programs/Vivado/Vivado/2021.1/data/ip/xpm/xpm_cdc/tcl/xpm_cdc_gray.tcl id:2 order:LATE scoped_inst:inst/COUPLER_INST/generate_async_fifo.FIFO_INST/XPM_FIFO_ASYNC_INST/gnuram_async_fifo.xpm_fifo_base_inst/gen_cdc_pntr.wr_pntr_cdc_inst unmanaged:yes} [current_design]
set_property SRC_FILE_INFO {cfile:/drive/data/WinCommon/Common/Programs/Vivado/Vivado/2021.1/data/ip/xpm/xpm_cdc/tcl/xpm_cdc_gray.tcl rfile:../../../../../../../../../../drive/data/WinCommon/Common/Programs/Vivado/Vivado/2021.1/data/ip/xpm/xpm_cdc/tcl/xpm_cdc_gray.tcl id:3 order:LATE scoped_inst:inst/COUPLER_INST/generate_async_fifo.FIFO_INST/XPM_FIFO_ASYNC_INST/gnuram_async_fifo.xpm_fifo_base_inst/gen_cdc_pntr.wr_pntr_cdc_dc_inst unmanaged:yes} [current_design]
set_property SRC_FILE_INFO {cfile:/drive/data/WinCommon/Common/Programs/Vivado/Vivado/2021.1/data/ip/xpm/xpm_cdc/tcl/xpm_cdc_gray.tcl rfile:../../../../../../../../../../drive/data/WinCommon/Common/Programs/Vivado/Vivado/2021.1/data/ip/xpm/xpm_cdc/tcl/xpm_cdc_gray.tcl id:4 order:LATE scoped_inst:inst/COUPLER_INST/generate_async_fifo.FIFO_INST/XPM_FIFO_ASYNC_INST/gnuram_async_fifo.xpm_fifo_base_inst/gen_cdc_pntr.rd_pntr_cdc_dc_inst unmanaged:yes} [current_design]
current_instance inst/COUPLER_INST/generate_async_fifo.FIFO_INST/XPM_FIFO_ASYNC_INST/gnuram_async_fifo.xpm_fifo_base_inst/gen_cdc_pntr.rd_pntr_cdc_inst
set_property src_info {type:SCOPED_XDC file:1 line:23 export:INPUT save:NONE read:READ} [current_design]
create_waiver -internal -scoped -type CDC -id {CDC-6} -user "xpm_cdc" -tags "1009444" -desc "The CDC-6 warning is waived as it is safe in the context of XPM_CDC_GRAY." -from [get_pins -quiet {src_gray_ff_reg*/C}] -to [get_pins -quiet {dest_graysync_ff_reg*/D}]
current_instance
current_instance inst/COUPLER_INST/generate_async_fifo.FIFO_INST/XPM_FIFO_ASYNC_INST/gnuram_async_fifo.xpm_fifo_base_inst/gen_cdc_pntr.wr_pntr_cdc_inst
set_property src_info {type:SCOPED_XDC file:2 line:23 export:INPUT save:NONE read:READ} [current_design]
create_waiver -internal -scoped -type CDC -id {CDC-6} -user "xpm_cdc" -tags "1009444" -desc "The CDC-6 warning is waived as it is safe in the context of XPM_CDC_GRAY." -from [get_pins -quiet {src_gray_ff_reg*/C}] -to [get_pins -quiet {dest_graysync_ff_reg*/D}]
current_instance
current_instance inst/COUPLER_INST/generate_async_fifo.FIFO_INST/XPM_FIFO_ASYNC_INST/gnuram_async_fifo.xpm_fifo_base_inst/gen_cdc_pntr.wr_pntr_cdc_dc_inst
set_property src_info {type:SCOPED_XDC file:3 line:23 export:INPUT save:NONE read:READ} [current_design]
create_waiver -internal -scoped -type CDC -id {CDC-6} -user "xpm_cdc" -tags "1009444" -desc "The CDC-6 warning is waived as it is safe in the context of XPM_CDC_GRAY." -from [get_pins -quiet {src_gray_ff_reg*/C}] -to [get_pins -quiet {dest_graysync_ff_reg*/D}]
current_instance
current_instance inst/COUPLER_INST/generate_async_fifo.FIFO_INST/XPM_FIFO_ASYNC_INST/gnuram_async_fifo.xpm_fifo_base_inst/gen_cdc_pntr.rd_pntr_cdc_dc_inst
set_property src_info {type:SCOPED_XDC file:4 line:23 export:INPUT save:NONE read:READ} [current_design]
create_waiver -internal -scoped -type CDC -id {CDC-6} -user "xpm_cdc" -tags "1009444" -desc "The CDC-6 warning is waived as it is safe in the context of XPM_CDC_GRAY." -from [get_pins -quiet {src_gray_ff_reg*/C}] -to [get_pins -quiet {dest_graysync_ff_reg*/D}]
