cropinghigh/zynq_a9_mb/software/FPGA_VIVADO/Platform/Platform.cache/ip/2021.1/0c5aad50aefdcf00/design_1_smartconnect_1_0_stub.vhdl

-- Copyright 1986-2021 Xilinx, Inc. All Rights Reserved.
-- --------------------------------------------------------------------------------
-- Tool Version: Vivado v.2021.1 (lin64) Build 3247384 Thu Jun 10 19:36:07 MDT 2021
-- Date        : Mon Dec 29 19:17:53 2025
-- Host        : indir-homePc running 64-bit Manjaro Linux
-- Command     : write_vhdl -force -mode synth_stub -rename_top decalper_eb_ot_sdeen_pot_pi_dehcac_xnilix -prefix
--               decalper_eb_ot_sdeen_pot_pi_dehcac_xnilix_ design_1_smartconnect_1_0_stub.vhdl
-- Design      : design_1_smartconnect_1_0
-- Purpose     : Stub declaration of top-level module interface
-- Device      : xc7z010clg400-3
-- --------------------------------------------------------------------------------
library IEEE;
use IEEE.STD_LOGIC_1164.ALL;

entity decalper_eb_ot_sdeen_pot_pi_dehcac_xnilix is
  Port ( 
    aclk : in STD_LOGIC;
    aresetn : in STD_LOGIC;
    S00_AXI_awid : in STD_LOGIC_VECTOR ( 11 downto 0 );
    S00_AXI_awaddr : in STD_LOGIC_VECTOR ( 31 downto 0 );
    S00_AXI_awlen : in STD_LOGIC_VECTOR ( 3 downto 0 );
    S00_AXI_awsize : in STD_LOGIC_VECTOR ( 2 downto 0 );
    S00_AXI_awburst : in STD_LOGIC_VECTOR ( 1 downto 0 );
    S00_AXI_awlock : in STD_LOGIC_VECTOR ( 1 downto 0 );
    S00_AXI_awcache : in STD_LOGIC_VECTOR ( 3 downto 0 );
    S00_AXI_awprot : in STD_LOGIC_VECTOR ( 2 downto 0 );
    S00_AXI_awqos : in STD_LOGIC_VECTOR ( 3 downto 0 );
    S00_AXI_awvalid : in STD_LOGIC;
    S00_AXI_awready : out STD_LOGIC;
    S00_AXI_wid : in STD_LOGIC_VECTOR ( 11 downto 0 );
    S00_AXI_wdata : in STD_LOGIC_VECTOR ( 31 downto 0 );
    S00_AXI_wstrb : in STD_LOGIC_VECTOR ( 3 downto 0 );
    S00_AXI_wlast : in STD_LOGIC;
    S00_AXI_wvalid : in STD_LOGIC;
    S00_AXI_wready : out STD_LOGIC;
    S00_AXI_bid : out STD_LOGIC_VECTOR ( 11 downto 0 );
    S00_AXI_bresp : out STD_LOGIC_VECTOR ( 1 downto 0 );
    S00_AXI_bvalid : out STD_LOGIC;
    S00_AXI_bready : in STD_LOGIC;
    S00_AXI_arid : in STD_LOGIC_VECTOR ( 11 downto 0 );
    S00_AXI_araddr : in STD_LOGIC_VECTOR ( 31 downto 0 );
    S00_AXI_arlen : in STD_LOGIC_VECTOR ( 3 downto 0 );
    S00_AXI_arsize : in STD_LOGIC_VECTOR ( 2 downto 0 );
    S00_AXI_arburst : in STD_LOGIC_VECTOR ( 1 downto 0 );
    S00_AXI_arlock : in STD_LOGIC_VECTOR ( 1 downto 0 );
    S00_AXI_arcache : in STD_LOGIC_VECTOR ( 3 downto 0 );
    S00_AXI_arprot : in STD_LOGIC_VECTOR ( 2 downto 0 );
    S00_AXI_arqos : in STD_LOGIC_VECTOR ( 3 downto 0 );
    S00_AXI_arvalid : in STD_LOGIC;
    S00_AXI_arready : out STD_LOGIC;
    S00_AXI_rid : out STD_LOGIC_VECTOR ( 11 downto 0 );
    S00_AXI_rdata : out STD_LOGIC_VECTOR ( 31 downto 0 );
    S00_AXI_rresp : out STD_LOGIC_VECTOR ( 1 downto 0 );
    S00_AXI_rlast : out STD_LOGIC;
    S00_AXI_rvalid : out STD_LOGIC;
    S00_AXI_rready : in STD_LOGIC;
    M00_AXI_awaddr : out STD_LOGIC_VECTOR ( 8 downto 0 );
    M00_AXI_awprot : out STD_LOGIC_VECTOR ( 2 downto 0 );
    M00_AXI_awvalid : out STD_LOGIC;
    M00_AXI_awready : in STD_LOGIC;
    M00_AXI_wdata : out STD_LOGIC_VECTOR ( 31 downto 0 );
    M00_AXI_wstrb : out STD_LOGIC_VECTOR ( 3 downto 0 );
    M00_AXI_wvalid : out STD_LOGIC;
    M00_AXI_wready : in STD_LOGIC;
    M00_AXI_bresp : in STD_LOGIC_VECTOR ( 1 downto 0 );
    M00_AXI_bvalid : in STD_LOGIC;
    M00_AXI_bready : out STD_LOGIC;
    M00_AXI_araddr : out STD_LOGIC_VECTOR ( 8 downto 0 );
    M00_AXI_arprot : out STD_LOGIC_VECTOR ( 2 downto 0 );
    M00_AXI_arvalid : out STD_LOGIC;
    M00_AXI_arready : in STD_LOGIC;
    M00_AXI_rdata : in STD_LOGIC_VECTOR ( 31 downto 0 );
    M00_AXI_rresp : in STD_LOGIC_VECTOR ( 1 downto 0 );
    M00_AXI_rvalid : in STD_LOGIC;
    M00_AXI_rready : out STD_LOGIC;
    M01_AXI_awaddr : out STD_LOGIC_VECTOR ( 5 downto 0 );
    M01_AXI_awprot : out STD_LOGIC_VECTOR ( 2 downto 0 );
    M01_AXI_awvalid : out STD_LOGIC;
    M01_AXI_awready : in STD_LOGIC;
    M01_AXI_wdata : out STD_LOGIC_VECTOR ( 31 downto 0 );
    M01_AXI_wstrb : out STD_LOGIC_VECTOR ( 3 downto 0 );
    M01_AXI_wvalid : out STD_LOGIC;
    M01_AXI_wready : in STD_LOGIC;
    M01_AXI_bresp : in STD_LOGIC_VECTOR ( 1 downto 0 );
    M01_AXI_bvalid : in STD_LOGIC;
    M01_AXI_bready : out STD_LOGIC;
    M01_AXI_araddr : out STD_LOGIC_VECTOR ( 5 downto 0 );
    M01_AXI_arprot : out STD_LOGIC_VECTOR ( 2 downto 0 );
    M01_AXI_arvalid : out STD_LOGIC;
    M01_AXI_arready : in STD_LOGIC;
    M01_AXI_rdata : in STD_LOGIC_VECTOR ( 31 downto 0 );
    M01_AXI_rresp : in STD_LOGIC_VECTOR ( 1 downto 0 );
    M01_AXI_rvalid : in STD_LOGIC;
    M01_AXI_rready : out STD_LOGIC;
    M02_AXI_awaddr : out STD_LOGIC_VECTOR ( 8 downto 0 );
    M02_AXI_awprot : out STD_LOGIC_VECTOR ( 2 downto 0 );
    M02_AXI_awvalid : out STD_LOGIC;
    M02_AXI_awready : in STD_LOGIC;
    M02_AXI_wdata : out STD_LOGIC_VECTOR ( 31 downto 0 );
    M02_AXI_wstrb : out STD_LOGIC_VECTOR ( 3 downto 0 );
    M02_AXI_wvalid : out STD_LOGIC;
    M02_AXI_wready : in STD_LOGIC;
    M02_AXI_bresp : in STD_LOGIC_VECTOR ( 1 downto 0 );
    M02_AXI_bvalid : in STD_LOGIC;
    M02_AXI_bready : out STD_LOGIC;
    M02_AXI_araddr : out STD_LOGIC_VECTOR ( 8 downto 0 );
    M02_AXI_arprot : out STD_LOGIC_VECTOR ( 2 downto 0 );
    M02_AXI_arvalid : out STD_LOGIC;
    M02_AXI_arready : in STD_LOGIC;
    M02_AXI_rdata : in STD_LOGIC_VECTOR ( 31 downto 0 );
    M02_AXI_rresp : in STD_LOGIC_VECTOR ( 1 downto 0 );
    M02_AXI_rvalid : in STD_LOGIC;
    M02_AXI_rready : out STD_LOGIC;
    M03_AXI_awaddr : out STD_LOGIC_VECTOR ( 7 downto 0 );
    M03_AXI_awprot : out STD_LOGIC_VECTOR ( 2 downto 0 );
    M03_AXI_awvalid : out STD_LOGIC;
    M03_AXI_awready : in STD_LOGIC;
    M03_AXI_wdata : out STD_LOGIC_VECTOR ( 31 downto 0 );
    M03_AXI_wstrb : out STD_LOGIC_VECTOR ( 3 downto 0 );
    M03_AXI_wvalid : out STD_LOGIC;
    M03_AXI_wready : in STD_LOGIC;
    M03_AXI_bresp : in STD_LOGIC_VECTOR ( 1 downto 0 );
    M03_AXI_bvalid : in STD_LOGIC;
    M03_AXI_bready : out STD_LOGIC;
    M03_AXI_araddr : out STD_LOGIC_VECTOR ( 7 downto 0 );
    M03_AXI_arprot : out STD_LOGIC_VECTOR ( 2 downto 0 );
    M03_AXI_arvalid : out STD_LOGIC;
    M03_AXI_arready : in STD_LOGIC;
    M03_AXI_rdata : in STD_LOGIC_VECTOR ( 31 downto 0 );
    M03_AXI_rresp : in STD_LOGIC_VECTOR ( 1 downto 0 );
    M03_AXI_rvalid : in STD_LOGIC;
    M03_AXI_rready : out STD_LOGIC;
    M04_AXI_awaddr : out STD_LOGIC_VECTOR ( 6 downto 0 );
    M04_AXI_awprot : out STD_LOGIC_VECTOR ( 2 downto 0 );
    M04_AXI_awvalid : out STD_LOGIC;
    M04_AXI_awready : in STD_LOGIC;
    M04_AXI_wdata : out STD_LOGIC_VECTOR ( 31 downto 0 );
    M04_AXI_wstrb : out STD_LOGIC_VECTOR ( 3 downto 0 );
    M04_AXI_wvalid : out STD_LOGIC;
    M04_AXI_wready : in STD_LOGIC;
    M04_AXI_bresp : in STD_LOGIC_VECTOR ( 1 downto 0 );
    M04_AXI_bvalid : in STD_LOGIC;
    M04_AXI_bready : out STD_LOGIC;
    M04_AXI_araddr : out STD_LOGIC_VECTOR ( 6 downto 0 );
    M04_AXI_arprot : out STD_LOGIC_VECTOR ( 2 downto 0 );
    M04_AXI_arvalid : out STD_LOGIC;
    M04_AXI_arready : in STD_LOGIC;
    M04_AXI_rdata : in STD_LOGIC_VECTOR ( 31 downto 0 );
    M04_AXI_rresp : in STD_LOGIC_VECTOR ( 1 downto 0 );
    M04_AXI_rvalid : in STD_LOGIC;
    M04_AXI_rready : out STD_LOGIC;
    M05_AXI_awid : out STD_LOGIC;
    M05_AXI_awaddr : out STD_LOGIC;
    M05_AXI_awlen : out STD_LOGIC;
    M05_AXI_awsize : out STD_LOGIC_VECTOR ( 2 downto 0 );
    M05_AXI_awburst : out STD_LOGIC_VECTOR ( 1 downto 0 );
    M05_AXI_awlock : out STD_LOGIC;
    M05_AXI_awcache : out STD_LOGIC_VECTOR ( 3 downto 0 );
    M05_AXI_awprot : out STD_LOGIC_VECTOR ( 2 downto 0 );
    M05_AXI_awregion : out STD_LOGIC_VECTOR ( 3 downto 0 );
    M05_AXI_awqos : out STD_LOGIC_VECTOR ( 3 downto 0 );
    M05_AXI_awuser : out STD_LOGIC;
    M05_AXI_awvalid : out STD_LOGIC_VECTOR ( 0 to 0 );
    M05_AXI_awready : in STD_LOGIC_VECTOR ( 0 to 0 );
    M05_AXI_wid : out STD_LOGIC;
    M05_AXI_wdata : out STD_LOGIC;
    M05_AXI_wstrb : out STD_LOGIC;
    M05_AXI_wlast : out STD_LOGIC_VECTOR ( 0 to 0 );
    M05_AXI_wuser : out STD_LOGIC;
    M05_AXI_wvalid : out STD_LOGIC_VECTOR ( 0 to 0 );
    M05_AXI_wready : in STD_LOGIC_VECTOR ( 0 to 0 );
    M05_AXI_bid : in STD_LOGIC;
    M05_AXI_bresp : in STD_LOGIC_VECTOR ( 1 downto 0 );
    M05_AXI_buser : in STD_LOGIC;
    M05_AXI_bvalid : in STD_LOGIC_VECTOR ( 0 to 0 );
    M05_AXI_bready : out STD_LOGIC_VECTOR ( 0 to 0 );
    M05_AXI_arid : out STD_LOGIC;
    M05_AXI_araddr : out STD_LOGIC;
    M05_AXI_arlen : out STD_LOGIC;
    M05_AXI_arsize : out STD_LOGIC_VECTOR ( 2 downto 0 );
    M05_AXI_arburst : out STD_LOGIC_VECTOR ( 1 downto 0 );
    M05_AXI_arlock : out STD_LOGIC;
    M05_AXI_arcache : out STD_LOGIC_VECTOR ( 3 downto 0 );
    M05_AXI_arprot : out STD_LOGIC_VECTOR ( 2 downto 0 );
    M05_AXI_arregion : out STD_LOGIC_VECTOR ( 3 downto 0 );
    M05_AXI_arqos : out STD_LOGIC_VECTOR ( 3 downto 0 );
    M05_AXI_aruser : out STD_LOGIC;
    M05_AXI_arvalid : out STD_LOGIC_VECTOR ( 0 to 0 );
    M05_AXI_arready : in STD_LOGIC_VECTOR ( 0 to 0 );
    M05_AXI_rid : in STD_LOGIC;
    M05_AXI_rdata : in STD_LOGIC;
    M05_AXI_rresp : in STD_LOGIC_VECTOR ( 1 downto 0 );
    M05_AXI_rlast : in STD_LOGIC_VECTOR ( 0 to 0 );
    M05_AXI_ruser : in STD_LOGIC;
    M05_AXI_rvalid : in STD_LOGIC_VECTOR ( 0 to 0 );
    M05_AXI_rready : out STD_LOGIC_VECTOR ( 0 to 0 );
    M06_AXI_awid : out STD_LOGIC;
    M06_AXI_awaddr : out STD_LOGIC;
    M06_AXI_awlen : out STD_LOGIC;
    M06_AXI_awsize : out STD_LOGIC_VECTOR ( 2 downto 0 );
    M06_AXI_awburst : out STD_LOGIC_VECTOR ( 1 downto 0 );
    M06_AXI_awlock : out STD_LOGIC;
    M06_AXI_awcache : out STD_LOGIC_VECTOR ( 3 downto 0 );
    M06_AXI_awprot : out STD_LOGIC_VECTOR ( 2 downto 0 );
    M06_AXI_awregion : out STD_LOGIC_VECTOR ( 3 downto 0 );
    M06_AXI_awqos : out STD_LOGIC_VECTOR ( 3 downto 0 );
    M06_AXI_awuser : out STD_LOGIC;
    M06_AXI_awvalid : out STD_LOGIC_VECTOR ( 0 to 0 );
    M06_AXI_awready : in STD_LOGIC_VECTOR ( 0 to 0 );
    M06_AXI_wid : out STD_LOGIC;
    M06_AXI_wdata : out STD_LOGIC;
    M06_AXI_wstrb : out STD_LOGIC;
    M06_AXI_wlast : out STD_LOGIC_VECTOR ( 0 to 0 );
    M06_AXI_wuser : out STD_LOGIC;
    M06_AXI_wvalid : out STD_LOGIC_VECTOR ( 0 to 0 );
    M06_AXI_wready : in STD_LOGIC_VECTOR ( 0 to 0 );
    M06_AXI_bid : in STD_LOGIC;
    M06_AXI_bresp : in STD_LOGIC_VECTOR ( 1 downto 0 );
    M06_AXI_buser : in STD_LOGIC;
    M06_AXI_bvalid : in STD_LOGIC_VECTOR ( 0 to 0 );
    M06_AXI_bready : out STD_LOGIC_VECTOR ( 0 to 0 );
    M06_AXI_arid : out STD_LOGIC;
    M06_AXI_araddr : out STD_LOGIC;
    M06_AXI_arlen : out STD_LOGIC;
    M06_AXI_arsize : out STD_LOGIC_VECTOR ( 2 downto 0 );
    M06_AXI_arburst : out STD_LOGIC_VECTOR ( 1 downto 0 );
    M06_AXI_arlock : out STD_LOGIC;
    M06_AXI_arcache : out STD_LOGIC_VECTOR ( 3 downto 0 );
    M06_AXI_arprot : out STD_LOGIC_VECTOR ( 2 downto 0 );
    M06_AXI_arregion : out STD_LOGIC_VECTOR ( 3 downto 0 );
    M06_AXI_arqos : out STD_LOGIC_VECTOR ( 3 downto 0 );
    M06_AXI_aruser : out STD_LOGIC;
    M06_AXI_arvalid : out STD_LOGIC_VECTOR ( 0 to 0 );
    M06_AXI_arready : in STD_LOGIC_VECTOR ( 0 to 0 );
    M06_AXI_rid : in STD_LOGIC;
    M06_AXI_rdata : in STD_LOGIC;
    M06_AXI_rresp : in STD_LOGIC_VECTOR ( 1 downto 0 );
    M06_AXI_rlast : in STD_LOGIC_VECTOR ( 0 to 0 );
    M06_AXI_ruser : in STD_LOGIC;
    M06_AXI_rvalid : in STD_LOGIC_VECTOR ( 0 to 0 );
    M06_AXI_rready : out STD_LOGIC_VECTOR ( 0 to 0 );
    M07_AXI_awid : out STD_LOGIC;
    M07_AXI_awaddr : out STD_LOGIC;
    M07_AXI_awlen : out STD_LOGIC;
    M07_AXI_awsize : out STD_LOGIC_VECTOR ( 2 downto 0 );
    M07_AXI_awburst : out STD_LOGIC_VECTOR ( 1 downto 0 );
    M07_AXI_awlock : out STD_LOGIC;
    M07_AXI_awcache : out STD_LOGIC_VECTOR ( 3 downto 0 );
    M07_AXI_awprot : out STD_LOGIC_VECTOR ( 2 downto 0 );
    M07_AXI_awregion : out STD_LOGIC_VECTOR ( 3 downto 0 );
    M07_AXI_awqos : out STD_LOGIC_VECTOR ( 3 downto 0 );
    M07_AXI_awuser : out STD_LOGIC;
    M07_AXI_awvalid : out STD_LOGIC_VECTOR ( 0 to 0 );
    M07_AXI_awready : in STD_LOGIC_VECTOR ( 0 to 0 );
    M07_AXI_wid : out STD_LOGIC;
    M07_AXI_wdata : out STD_LOGIC;
    M07_AXI_wstrb : out STD_LOGIC;
    M07_AXI_wlast : out STD_LOGIC_VECTOR ( 0 to 0 );
    M07_AXI_wuser : out STD_LOGIC;
    M07_AXI_wvalid : out STD_LOGIC_VECTOR ( 0 to 0 );
    M07_AXI_wready : in STD_LOGIC_VECTOR ( 0 to 0 );
    M07_AXI_bid : in STD_LOGIC;
    M07_AXI_bresp : in STD_LOGIC_VECTOR ( 1 downto 0 );
    M07_AXI_buser : in STD_LOGIC;
    M07_AXI_bvalid : in STD_LOGIC_VECTOR ( 0 to 0 );
    M07_AXI_bready : out STD_LOGIC_VECTOR ( 0 to 0 );
    M07_AXI_arid : out STD_LOGIC;
    M07_AXI_araddr : out STD_LOGIC;
    M07_AXI_arlen : out STD_LOGIC;
    M07_AXI_arsize : out STD_LOGIC_VECTOR ( 2 downto 0 );
    M07_AXI_arburst : out STD_LOGIC_VECTOR ( 1 downto 0 );
    M07_AXI_arlock : out STD_LOGIC;
    M07_AXI_arcache : out STD_LOGIC_VECTOR ( 3 downto 0 );
    M07_AXI_arprot : out STD_LOGIC_VECTOR ( 2 downto 0 );
    M07_AXI_arregion : out STD_LOGIC_VECTOR ( 3 downto 0 );
    M07_AXI_arqos : out STD_LOGIC_VECTOR ( 3 downto 0 );
    M07_AXI_aruser : out STD_LOGIC;
    M07_AXI_arvalid : out STD_LOGIC_VECTOR ( 0 to 0 );
    M07_AXI_arready : in STD_LOGIC_VECTOR ( 0 to 0 );
    M07_AXI_rid : in STD_LOGIC;
    M07_AXI_rdata : in STD_LOGIC;
    M07_AXI_rresp : in STD_LOGIC_VECTOR ( 1 downto 0 );
    M07_AXI_rlast : in STD_LOGIC_VECTOR ( 0 to 0 );
    M07_AXI_ruser : in STD_LOGIC;
    M07_AXI_rvalid : in STD_LOGIC_VECTOR ( 0 to 0 );
    M07_AXI_rready : out STD_LOGIC_VECTOR ( 0 to 0 );
    M08_AXI_awid : out STD_LOGIC;
    M08_AXI_awaddr : out STD_LOGIC;
    M08_AXI_awlen : out STD_LOGIC;
    M08_AXI_awsize : out STD_LOGIC_VECTOR ( 2 downto 0 );
    M08_AXI_awburst : out STD_LOGIC_VECTOR ( 1 downto 0 );
    M08_AXI_awlock : out STD_LOGIC;
    M08_AXI_awcache : out STD_LOGIC_VECTOR ( 3 downto 0 );
    M08_AXI_awprot : out STD_LOGIC_VECTOR ( 2 downto 0 );
    M08_AXI_awregion : out STD_LOGIC_VECTOR ( 3 downto 0 );
    M08_AXI_awqos : out STD_LOGIC_VECTOR ( 3 downto 0 );
    M08_AXI_awuser : out STD_LOGIC;
    M08_AXI_awvalid : out STD_LOGIC_VECTOR ( 0 to 0 );
    M08_AXI_awready : in STD_LOGIC_VECTOR ( 0 to 0 );
    M08_AXI_wid : out STD_LOGIC;
    M08_AXI_wdata : out STD_LOGIC;
    M08_AXI_wstrb : out STD_LOGIC;
    M08_AXI_wlast : out STD_LOGIC_VECTOR ( 0 to 0 );
    M08_AXI_wuser : out STD_LOGIC;
    M08_AXI_wvalid : out STD_LOGIC_VECTOR ( 0 to 0 );
    M08_AXI_wready : in STD_LOGIC_VECTOR ( 0 to 0 );
    M08_AXI_bid : in STD_LOGIC;
    M08_AXI_bresp : in STD_LOGIC_VECTOR ( 1 downto 0 );
    M08_AXI_buser : in STD_LOGIC;
    M08_AXI_bvalid : in STD_LOGIC_VECTOR ( 0 to 0 );
    M08_AXI_bready : out STD_LOGIC_VECTOR ( 0 to 0 );
    M08_AXI_arid : out STD_LOGIC;
    M08_AXI_araddr : out STD_LOGIC;
    M08_AXI_arlen : out STD_LOGIC;
    M08_AXI_arsize : out STD_LOGIC_VECTOR ( 2 downto 0 );
    M08_AXI_arburst : out STD_LOGIC_VECTOR ( 1 downto 0 );
    M08_AXI_arlock : out STD_LOGIC;
    M08_AXI_arcache : out STD_LOGIC_VECTOR ( 3 downto 0 );
    M08_AXI_arprot : out STD_LOGIC_VECTOR ( 2 downto 0 );
    M08_AXI_arregion : out STD_LOGIC_VECTOR ( 3 downto 0 );
    M08_AXI_arqos : out STD_LOGIC_VECTOR ( 3 downto 0 );
    M08_AXI_aruser : out STD_LOGIC;
    M08_AXI_arvalid : out STD_LOGIC_VECTOR ( 0 to 0 );
    M08_AXI_arready : in STD_LOGIC_VECTOR ( 0 to 0 );
    M08_AXI_rid : in STD_LOGIC;
    M08_AXI_rdata : in STD_LOGIC;
    M08_AXI_rresp : in STD_LOGIC_VECTOR ( 1 downto 0 );
    M08_AXI_rlast : in STD_LOGIC_VECTOR ( 0 to 0 );
    M08_AXI_ruser : in STD_LOGIC;
    M08_AXI_rvalid : in STD_LOGIC_VECTOR ( 0 to 0 );
    M08_AXI_rready : out STD_LOGIC_VECTOR ( 0 to 0 )
  );

end decalper_eb_ot_sdeen_pot_pi_dehcac_xnilix;

architecture stub of decalper_eb_ot_sdeen_pot_pi_dehcac_xnilix is
attribute syn_black_box : boolean;
attribute black_box_pad_pin : string;
attribute syn_black_box of stub : architecture is true;
attribute black_box_pad_pin of stub : architecture is "aclk,aresetn,S00_AXI_awid[11:0],S00_AXI_awaddr[31:0],S00_AXI_awlen[3:0],S00_AXI_awsize[2:0],S00_AXI_awburst[1:0],S00_AXI_awlock[1:0],S00_AXI_awcache[3:0],S00_AXI_awprot[2:0],S00_AXI_awqos[3:0],S00_AXI_awvalid,S00_AXI_awready,S00_AXI_wid[11:0],S00_AXI_wdata[31:0],S00_AXI_wstrb[3:0],S00_AXI_wlast,S00_AXI_wvalid,S00_AXI_wready,S00_AXI_bid[11:0],S00_AXI_bresp[1:0],S00_AXI_bvalid,S00_AXI_bready,S00_AXI_arid[11:0],S00_AXI_araddr[31:0],S00_AXI_arlen[3:0],S00_AXI_arsize[2:0],S00_AXI_arburst[1:0],S00_AXI_arlock[1:0],S00_AXI_arcache[3:0],S00_AXI_arprot[2:0],S00_AXI_arqos[3:0],S00_AXI_arvalid,S00_AXI_arready,S00_AXI_rid[11:0],S00_AXI_rdata[31:0],S00_AXI_rresp[1:0],S00_AXI_rlast,S00_AXI_rvalid,S00_AXI_rready,M00_AXI_awaddr[8:0],M00_AXI_awprot[2:0],M00_AXI_awvalid,M00_AXI_awready,M00_AXI_wdata[31:0],M00_AXI_wstrb[3:0],M00_AXI_wvalid,M00_AXI_wready,M00_AXI_bresp[1:0],M00_AXI_bvalid,M00_AXI_bready,M00_AXI_araddr[8:0],M00_AXI_arprot[2:0],M00_AXI_arvalid,M00_AXI_arready,M00_AXI_rdata[31:0],M00_AXI_rresp[1:0],M00_AXI_rvalid,M00_AXI_rready,M01_AXI_awaddr[5:0],M01_AXI_awprot[2:0],M01_AXI_awvalid,M01_AXI_awready,M01_AXI_wdata[31:0],M01_AXI_wstrb[3:0],M01_AXI_wvalid,M01_AXI_wready,M01_AXI_bresp[1:0],M01_AXI_bvalid,M01_AXI_bready,M01_AXI_araddr[5:0],M01_AXI_arprot[2:0],M01_AXI_arvalid,M01_AXI_arready,M01_AXI_rdata[31:0],M01_AXI_rresp[1:0],M01_AXI_rvalid,M01_AXI_rready,M02_AXI_awaddr[8:0],M02_AXI_awprot[2:0],M02_AXI_awvalid,M02_AXI_awready,M02_AXI_wdata[31:0],M02_AXI_wstrb[3:0],M02_AXI_wvalid,M02_AXI_wready,M02_AXI_bresp[1:0],M02_AXI_bvalid,M02_AXI_bready,M02_AXI_araddr[8:0],M02_AXI_arprot[2:0],M02_AXI_arvalid,M02_AXI_arready,M02_AXI_rdata[31:0],M02_AXI_rresp[1:0],M02_AXI_rvalid,M02_AXI_rready,M03_AXI_awaddr[7:0],M03_AXI_awprot[2:0],M03_AXI_awvalid,M03_AXI_awready,M03_AXI_wdata[31:0],M03_AXI_wstrb[3:0],M03_AXI_wvalid,M03_AXI_wready,M03_AXI_bresp[1:0],M03_AXI_bvalid,M03_AXI_bready,M03_AXI_araddr[7:0],M03_AXI_arprot[2:0],M03_AXI_arvalid,M03_AXI_arready,M03_AXI_rdata[31:0],M03_AXI_rresp[1:0],M03_AXI_rvalid,M03_AXI_rready,M04_AXI_awaddr[6:0],M04_AXI_awprot[2:0],M04_AXI_awvalid,M04_AXI_awready,M04_AXI_wdata[31:0],M04_AXI_wstrb[3:0],M04_AXI_wvalid,M04_AXI_wready,M04_AXI_bresp[1:0],M04_AXI_bvalid,M04_AXI_bready,M04_AXI_araddr[6:0],M04_AXI_arprot[2:0],M04_AXI_arvalid,M04_AXI_arready,M04_AXI_rdata[31:0],M04_AXI_rresp[1:0],M04_AXI_rvalid,M04_AXI_rready,M05_AXI_awid,M05_AXI_awaddr,M05_AXI_awlen,M05_AXI_awsize[2:0],M05_AXI_awburst[1:0],M05_AXI_awlock,M05_AXI_awcache[3:0],M05_AXI_awprot[2:0],M05_AXI_awregion[3:0],M05_AXI_awqos[3:0],M05_AXI_awuser,M05_AXI_awvalid[0:0],M05_AXI_awready[0:0],M05_AXI_wid,M05_AXI_wdata,M05_AXI_wstrb,M05_AXI_wlast[0:0],M05_AXI_wuser,M05_AXI_wvalid[0:0],M05_AXI_wready[0:0],M05_AXI_bid,M05_AXI_bresp[1:0],M05_AXI_buser,M05_AXI_bvalid[0:0],M05_AXI_bready[0:0],M05_AXI_arid,M05_AXI_araddr,M05_AXI_arlen,M05_AXI_arsize[2:0],M05_AXI_arburst[1:0],M05_AXI_arlock,M05_AXI_arcache[3:0],M05_AXI_arprot[2:0],M05_AXI_arregion[3:0],M05_AXI_arqos[3:0],M05_AXI_aruser,M05_AXI_arvalid[0:0],M05_AXI_arready[0:0],M05_AXI_rid,M05_AXI_rdata,M05_AXI_rresp[1:0],M05_AXI_rlast[0:0],M05_AXI_ruser,M05_AXI_rvalid[0:0],M05_AXI_rready[0:0],M06_AXI_awid,M06_AXI_awaddr,M06_AXI_awlen,M06_AXI_awsize[2:0],M06_AXI_awburst[1:0],M06_AXI_awlock,M06_AXI_awcache[3:0],M06_AXI_awprot[2:0],M06_AXI_awregion[3:0],M06_AXI_awqos[3:0],M06_AXI_awuser,M06_AXI_awvalid[0:0],M06_AXI_awready[0:0],M06_AXI_wid,M06_AXI_wdata,M06_AXI_wstrb,M06_AXI_wlast[0:0],M06_AXI_wuser,M06_AXI_wvalid[0:0],M06_AXI_wready[0:0],M06_AXI_bid,M06_AXI_bresp[1:0],M06_AXI_buser,M06_AXI_bvalid[0:0],M06_AXI_bready[0:0],M06_AXI_arid,M06_AXI_araddr,M06_AXI_arlen,M06_AXI_arsize[2:0],M06_AXI_arburst[1:0],M06_AXI_arlock,M06_AXI_arcache[3:0],M06_AXI_arprot[2:0],M06_AXI_arregion[3:0],M06_AXI_arqos[3:0],M06_AXI_aruser,M06_AXI_arvalid[0:0],M06_AXI_arready[0:0],M06_AXI_rid,M06_AXI_rdata,M06_AXI_rresp[1:0],M06_AXI_rlast[0:0],M06_AXI_ruser,M06_AXI_rvalid[0:0],M06_AXI_rready[0:0],M07_AXI_awid,M07_AXI_awaddr,M07_AXI_awlen,M07_AXI_awsize[2:0],M07_AXI_awburst[1:0],M07_AXI_awlock,M07_AXI_awcache[3:0],M07_AXI_awprot[2:0],M07_AXI_awregion[3:0],M07_AXI_awqos[3:0],M07_AXI_awuser,M07_AXI_awvalid[0:0],M07_AXI_awready[0:0],M07_AXI_wid,M07_AXI_wdata,M07_AXI_wstrb,M07_AXI_wlast[0:0],M07_AXI_wuser,M07_AXI_wvalid[0:0],M07_AXI_wready[0:0],M07_AXI_bid,M07_AXI_bresp[1:0],M07_AXI_buser,M07_AXI_bvalid[0:0],M07_AXI_bready[0:0],M07_AXI_arid,M07_AXI_araddr,M07_AXI_arlen,M07_AXI_arsize[2:0],M07_AXI_arburst[1:0],M07_AXI_arlock,M07_AXI_arcache[3:0],M07_AXI_arprot[2:0],M07_AXI_arregion[3:0],M07_AXI_arqos[3:0],M07_AXI_aruser,M07_AXI_arvalid[0:0],M07_AXI_arready[0:0],M07_AXI_rid,M07_AXI_rdata,M07_AXI_rresp[1:0],M07_AXI_rlast[0:0],M07_AXI_ruser,M07_AXI_rvalid[0:0],M07_AXI_rready[0:0],M08_AXI_awid,M08_AXI_awaddr,M08_AXI_awlen,M08_AXI_awsize[2:0],M08_AXI_awburst[1:0],M08_AXI_awlock,M08_AXI_awcache[3:0],M08_AXI_awprot[2:0],M08_AXI_awregion[3:0],M08_AXI_awqos[3:0],M08_AXI_awuser,M08_AXI_awvalid[0:0],M08_AXI_awready[0:0],M08_AXI_wid,M08_AXI_wdata,M08_AXI_wstrb,M08_AXI_wlast[0:0],M08_AXI_wuser,M08_AXI_wvalid[0:0],M08_AXI_wready[0:0],M08_AXI_bid,M08_AXI_bresp[1:0],M08_AXI_buser,M08_AXI_bvalid[0:0],M08_AXI_bready[0:0],M08_AXI_arid,M08_AXI_araddr,M08_AXI_arlen,M08_AXI_arsize[2:0],M08_AXI_arburst[1:0],M08_AXI_arlock,M08_AXI_arcache[3:0],M08_AXI_arprot[2:0],M08_AXI_arregion[3:0],M08_AXI_arqos[3:0],M08_AXI_aruser,M08_AXI_arvalid[0:0],M08_AXI_arready[0:0],M08_AXI_rid,M08_AXI_rdata,M08_AXI_rresp[1:0],M08_AXI_rlast[0:0],M08_AXI_ruser,M08_AXI_rvalid[0:0],M08_AXI_rready[0:0]";
attribute X_CORE_INFO : string;
attribute X_CORE_INFO of stub : architecture is "bd_88fd,Vivado 2021.1";
begin
end;
