cropinghigh/zynq_a9_mb/software/FPGA_VIVADO/Platform/Platform.ip_user_files/mem_init_files/design_1_processing_system7_0_0.h

#ifndef IP_DESIGN_1_PROCESSING_SYSTEM7_0_0_H_
#define IP_DESIGN_1_PROCESSING_SYSTEM7_0_0_H_

// (c) Copyright 1995-2025 Xilinx, Inc. All rights reserved.
// 
// This file contains confidential and proprietary information
// of Xilinx, Inc. and is protected under U.S. and
// international copyright and other intellectual property
// laws.
// 
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
// CRITICAL APPLICATIONS
// Xilinx products are not designed or intended to be fail-
// safe, or for use in any application requiring fail-safe
// performance, such as life-support or safety devices or
// systems, Class III medical devices, nuclear facilities,
// applications related to the deployment of airbags, or any
// other applications that could lead to death, personal
// injury, or severe property or environmental damage
// (individually and collectively, "Critical
// Applications"). Customer assumes the sole risk and
// liability of any use of Xilinx products in Critical
// Applications, subject only to applicable laws and
// regulations governing limitations on product liability.
// 
// THIS COPYRIGHT NOTICE AND DISCLAIMER MUST BE RETAINED AS
// PART OF THIS FILE AT ALL TIMES.
// 
// DO NOT MODIFY THIS FILE.


#ifndef XTLM
#include "xtlm.h"
#endif
#ifndef SYSTEMC_INCLUDED
#include <systemc>
#endif

#if defined(_MSC_VER)
#define DllExport __declspec(dllexport)
#elif defined(__GNUC__)
#define DllExport __attribute__ ((visibility("default")))
#else
#define DllExport
#endif

#include "design_1_processing_system7_0_0_sc.h"




#ifdef XILINX_SIMULATOR
class DllExport design_1_processing_system7_0_0 : public design_1_processing_system7_0_0_sc
{
public:

  design_1_processing_system7_0_0(const sc_core::sc_module_name& nm);
  virtual ~design_1_processing_system7_0_0();

  // module pin-to-pin RTL interface

  sc_core::sc_out< bool > CAN0_PHY_TX;
  sc_core::sc_in< bool > CAN0_PHY_RX;
  sc_core::sc_in< bool > PJTAG_TCK;
  sc_core::sc_in< bool > PJTAG_TMS;
  sc_core::sc_in< bool > PJTAG_TDI;
  sc_core::sc_out< bool > PJTAG_TDO;
  sc_core::sc_in< bool > SPI0_SCLK_I;
  sc_core::sc_out< bool > SPI0_SCLK_O;
  sc_core::sc_out< bool > SPI0_SCLK_T;
  sc_core::sc_in< bool > SPI0_MOSI_I;
  sc_core::sc_out< bool > SPI0_MOSI_O;
  sc_core::sc_out< bool > SPI0_MOSI_T;
  sc_core::sc_in< bool > SPI0_MISO_I;
  sc_core::sc_out< bool > SPI0_MISO_O;
  sc_core::sc_out< bool > SPI0_MISO_T;
  sc_core::sc_in< bool > SPI0_SS_I;
  sc_core::sc_out< bool > SPI0_SS_O;
  sc_core::sc_out< bool > SPI0_SS1_O;
  sc_core::sc_out< bool > SPI0_SS2_O;
  sc_core::sc_out< bool > SPI0_SS_T;
  sc_core::sc_out< bool > TTC0_WAVE0_OUT;
  sc_core::sc_out< bool > TTC0_WAVE1_OUT;
  sc_core::sc_out< bool > TTC0_WAVE2_OUT;
  sc_core::sc_out< sc_dt::sc_bv<2> > USB0_PORT_INDCTL;
  sc_core::sc_out< bool > USB0_VBUS_PWRSELECT;
  sc_core::sc_in< bool > USB0_VBUS_PWRFAULT;
  sc_core::sc_out< bool > M_AXI_GP0_ARVALID;
  sc_core::sc_out< bool > M_AXI_GP0_AWVALID;
  sc_core::sc_out< bool > M_AXI_GP0_BREADY;
  sc_core::sc_out< bool > M_AXI_GP0_RREADY;
  sc_core::sc_out< bool > M_AXI_GP0_WLAST;
  sc_core::sc_out< bool > M_AXI_GP0_WVALID;
  sc_core::sc_out< sc_dt::sc_bv<12> > M_AXI_GP0_ARID;
  sc_core::sc_out< sc_dt::sc_bv<12> > M_AXI_GP0_AWID;
  sc_core::sc_out< sc_dt::sc_bv<12> > M_AXI_GP0_WID;
  sc_core::sc_out< sc_dt::sc_bv<2> > M_AXI_GP0_ARBURST;
  sc_core::sc_out< sc_dt::sc_bv<2> > M_AXI_GP0_ARLOCK;
  sc_core::sc_out< sc_dt::sc_bv<3> > M_AXI_GP0_ARSIZE;
  sc_core::sc_out< sc_dt::sc_bv<2> > M_AXI_GP0_AWBURST;
  sc_core::sc_out< sc_dt::sc_bv<2> > M_AXI_GP0_AWLOCK;
  sc_core::sc_out< sc_dt::sc_bv<3> > M_AXI_GP0_AWSIZE;
  sc_core::sc_out< sc_dt::sc_bv<3> > M_AXI_GP0_ARPROT;
  sc_core::sc_out< sc_dt::sc_bv<3> > M_AXI_GP0_AWPROT;
  sc_core::sc_out< sc_dt::sc_bv<32> > M_AXI_GP0_ARADDR;
  sc_core::sc_out< sc_dt::sc_bv<32> > M_AXI_GP0_AWADDR;
  sc_core::sc_out< sc_dt::sc_bv<32> > M_AXI_GP0_WDATA;
  sc_core::sc_out< sc_dt::sc_bv<4> > M_AXI_GP0_ARCACHE;
  sc_core::sc_out< sc_dt::sc_bv<4> > M_AXI_GP0_ARLEN;
  sc_core::sc_out< sc_dt::sc_bv<4> > M_AXI_GP0_ARQOS;
  sc_core::sc_out< sc_dt::sc_bv<4> > M_AXI_GP0_AWCACHE;
  sc_core::sc_out< sc_dt::sc_bv<4> > M_AXI_GP0_AWLEN;
  sc_core::sc_out< sc_dt::sc_bv<4> > M_AXI_GP0_AWQOS;
  sc_core::sc_out< sc_dt::sc_bv<4> > M_AXI_GP0_WSTRB;
  sc_core::sc_in< bool > M_AXI_GP0_ACLK;
  sc_core::sc_in< bool > M_AXI_GP0_ARREADY;
  sc_core::sc_in< bool > M_AXI_GP0_AWREADY;
  sc_core::sc_in< bool > M_AXI_GP0_BVALID;
  sc_core::sc_in< bool > M_AXI_GP0_RLAST;
  sc_core::sc_in< bool > M_AXI_GP0_RVALID;
  sc_core::sc_in< bool > M_AXI_GP0_WREADY;
  sc_core::sc_in< sc_dt::sc_bv<12> > M_AXI_GP0_BID;
  sc_core::sc_in< sc_dt::sc_bv<12> > M_AXI_GP0_RID;
  sc_core::sc_in< sc_dt::sc_bv<2> > M_AXI_GP0_BRESP;
  sc_core::sc_in< sc_dt::sc_bv<2> > M_AXI_GP0_RRESP;
  sc_core::sc_in< sc_dt::sc_bv<32> > M_AXI_GP0_RDATA;
  sc_core::sc_out< bool > M_AXI_GP1_ARVALID;
  sc_core::sc_out< bool > M_AXI_GP1_AWVALID;
  sc_core::sc_out< bool > M_AXI_GP1_BREADY;
  sc_core::sc_out< bool > M_AXI_GP1_RREADY;
  sc_core::sc_out< bool > M_AXI_GP1_WLAST;
  sc_core::sc_out< bool > M_AXI_GP1_WVALID;
  sc_core::sc_out< sc_dt::sc_bv<12> > M_AXI_GP1_ARID;
  sc_core::sc_out< sc_dt::sc_bv<12> > M_AXI_GP1_AWID;
  sc_core::sc_out< sc_dt::sc_bv<12> > M_AXI_GP1_WID;
  sc_core::sc_out< sc_dt::sc_bv<2> > M_AXI_GP1_ARBURST;
  sc_core::sc_out< sc_dt::sc_bv<2> > M_AXI_GP1_ARLOCK;
  sc_core::sc_out< sc_dt::sc_bv<3> > M_AXI_GP1_ARSIZE;
  sc_core::sc_out< sc_dt::sc_bv<2> > M_AXI_GP1_AWBURST;
  sc_core::sc_out< sc_dt::sc_bv<2> > M_AXI_GP1_AWLOCK;
  sc_core::sc_out< sc_dt::sc_bv<3> > M_AXI_GP1_AWSIZE;
  sc_core::sc_out< sc_dt::sc_bv<3> > M_AXI_GP1_ARPROT;
  sc_core::sc_out< sc_dt::sc_bv<3> > M_AXI_GP1_AWPROT;
  sc_core::sc_out< sc_dt::sc_bv<32> > M_AXI_GP1_ARADDR;
  sc_core::sc_out< sc_dt::sc_bv<32> > M_AXI_GP1_AWADDR;
  sc_core::sc_out< sc_dt::sc_bv<32> > M_AXI_GP1_WDATA;
  sc_core::sc_out< sc_dt::sc_bv<4> > M_AXI_GP1_ARCACHE;
  sc_core::sc_out< sc_dt::sc_bv<4> > M_AXI_GP1_ARLEN;
  sc_core::sc_out< sc_dt::sc_bv<4> > M_AXI_GP1_ARQOS;
  sc_core::sc_out< sc_dt::sc_bv<4> > M_AXI_GP1_AWCACHE;
  sc_core::sc_out< sc_dt::sc_bv<4> > M_AXI_GP1_AWLEN;
  sc_core::sc_out< sc_dt::sc_bv<4> > M_AXI_GP1_AWQOS;
  sc_core::sc_out< sc_dt::sc_bv<4> > M_AXI_GP1_WSTRB;
  sc_core::sc_in< bool > M_AXI_GP1_ACLK;
  sc_core::sc_in< bool > M_AXI_GP1_ARREADY;
  sc_core::sc_in< bool > M_AXI_GP1_AWREADY;
  sc_core::sc_in< bool > M_AXI_GP1_BVALID;
  sc_core::sc_in< bool > M_AXI_GP1_RLAST;
  sc_core::sc_in< bool > M_AXI_GP1_RVALID;
  sc_core::sc_in< bool > M_AXI_GP1_WREADY;
  sc_core::sc_in< sc_dt::sc_bv<12> > M_AXI_GP1_BID;
  sc_core::sc_in< sc_dt::sc_bv<12> > M_AXI_GP1_RID;
  sc_core::sc_in< sc_dt::sc_bv<2> > M_AXI_GP1_BRESP;
  sc_core::sc_in< sc_dt::sc_bv<2> > M_AXI_GP1_RRESP;
  sc_core::sc_in< sc_dt::sc_bv<32> > M_AXI_GP1_RDATA;
  sc_core::sc_out< bool > S_AXI_GP0_ARREADY;
  sc_core::sc_out< bool > S_AXI_GP0_AWREADY;
  sc_core::sc_out< bool > S_AXI_GP0_BVALID;
  sc_core::sc_out< bool > S_AXI_GP0_RLAST;
  sc_core::sc_out< bool > S_AXI_GP0_RVALID;
  sc_core::sc_out< bool > S_AXI_GP0_WREADY;
  sc_core::sc_out< sc_dt::sc_bv<2> > S_AXI_GP0_BRESP;
  sc_core::sc_out< sc_dt::sc_bv<2> > S_AXI_GP0_RRESP;
  sc_core::sc_out< sc_dt::sc_bv<32> > S_AXI_GP0_RDATA;
  sc_core::sc_out< sc_dt::sc_bv<6> > S_AXI_GP0_BID;
  sc_core::sc_out< sc_dt::sc_bv<6> > S_AXI_GP0_RID;
  sc_core::sc_in< bool > S_AXI_GP0_ACLK;
  sc_core::sc_in< bool > S_AXI_GP0_ARVALID;
  sc_core::sc_in< bool > S_AXI_GP0_AWVALID;
  sc_core::sc_in< bool > S_AXI_GP0_BREADY;
  sc_core::sc_in< bool > S_AXI_GP0_RREADY;
  sc_core::sc_in< bool > S_AXI_GP0_WLAST;
  sc_core::sc_in< bool > S_AXI_GP0_WVALID;
  sc_core::sc_in< sc_dt::sc_bv<2> > S_AXI_GP0_ARBURST;
  sc_core::sc_in< sc_dt::sc_bv<2> > S_AXI_GP0_ARLOCK;
  sc_core::sc_in< sc_dt::sc_bv<3> > S_AXI_GP0_ARSIZE;
  sc_core::sc_in< sc_dt::sc_bv<2> > S_AXI_GP0_AWBURST;
  sc_core::sc_in< sc_dt::sc_bv<2> > S_AXI_GP0_AWLOCK;
  sc_core::sc_in< sc_dt::sc_bv<3> > S_AXI_GP0_AWSIZE;
  sc_core::sc_in< sc_dt::sc_bv<3> > S_AXI_GP0_ARPROT;
  sc_core::sc_in< sc_dt::sc_bv<3> > S_AXI_GP0_AWPROT;
  sc_core::sc_in< sc_dt::sc_bv<32> > S_AXI_GP0_ARADDR;
  sc_core::sc_in< sc_dt::sc_bv<32> > S_AXI_GP0_AWADDR;
  sc_core::sc_in< sc_dt::sc_bv<32> > S_AXI_GP0_WDATA;
  sc_core::sc_in< sc_dt::sc_bv<4> > S_AXI_GP0_ARCACHE;
  sc_core::sc_in< sc_dt::sc_bv<4> > S_AXI_GP0_ARLEN;
  sc_core::sc_in< sc_dt::sc_bv<4> > S_AXI_GP0_ARQOS;
  sc_core::sc_in< sc_dt::sc_bv<4> > S_AXI_GP0_AWCACHE;
  sc_core::sc_in< sc_dt::sc_bv<4> > S_AXI_GP0_AWLEN;
  sc_core::sc_in< sc_dt::sc_bv<4> > S_AXI_GP0_AWQOS;
  sc_core::sc_in< sc_dt::sc_bv<4> > S_AXI_GP0_WSTRB;
  sc_core::sc_in< sc_dt::sc_bv<6> > S_AXI_GP0_ARID;
  sc_core::sc_in< sc_dt::sc_bv<6> > S_AXI_GP0_AWID;
  sc_core::sc_in< sc_dt::sc_bv<6> > S_AXI_GP0_WID;
  sc_core::sc_out< bool > S_AXI_GP1_ARREADY;
  sc_core::sc_out< bool > S_AXI_GP1_AWREADY;
  sc_core::sc_out< bool > S_AXI_GP1_BVALID;
  sc_core::sc_out< bool > S_AXI_GP1_RLAST;
  sc_core::sc_out< bool > S_AXI_GP1_RVALID;
  sc_core::sc_out< bool > S_AXI_GP1_WREADY;
  sc_core::sc_out< sc_dt::sc_bv<2> > S_AXI_GP1_BRESP;
  sc_core::sc_out< sc_dt::sc_bv<2> > S_AXI_GP1_RRESP;
  sc_core::sc_out< sc_dt::sc_bv<32> > S_AXI_GP1_RDATA;
  sc_core::sc_out< sc_dt::sc_bv<6> > S_AXI_GP1_BID;
  sc_core::sc_out< sc_dt::sc_bv<6> > S_AXI_GP1_RID;
  sc_core::sc_in< bool > S_AXI_GP1_ACLK;
  sc_core::sc_in< bool > S_AXI_GP1_ARVALID;
  sc_core::sc_in< bool > S_AXI_GP1_AWVALID;
  sc_core::sc_in< bool > S_AXI_GP1_BREADY;
  sc_core::sc_in< bool > S_AXI_GP1_RREADY;
  sc_core::sc_in< bool > S_AXI_GP1_WLAST;
  sc_core::sc_in< bool > S_AXI_GP1_WVALID;
  sc_core::sc_in< sc_dt::sc_bv<2> > S_AXI_GP1_ARBURST;
  sc_core::sc_in< sc_dt::sc_bv<2> > S_AXI_GP1_ARLOCK;
  sc_core::sc_in< sc_dt::sc_bv<3> > S_AXI_GP1_ARSIZE;
  sc_core::sc_in< sc_dt::sc_bv<2> > S_AXI_GP1_AWBURST;
  sc_core::sc_in< sc_dt::sc_bv<2> > S_AXI_GP1_AWLOCK;
  sc_core::sc_in< sc_dt::sc_bv<3> > S_AXI_GP1_AWSIZE;
  sc_core::sc_in< sc_dt::sc_bv<3> > S_AXI_GP1_ARPROT;
  sc_core::sc_in< sc_dt::sc_bv<3> > S_AXI_GP1_AWPROT;
  sc_core::sc_in< sc_dt::sc_bv<32> > S_AXI_GP1_ARADDR;
  sc_core::sc_in< sc_dt::sc_bv<32> > S_AXI_GP1_AWADDR;
  sc_core::sc_in< sc_dt::sc_bv<32> > S_AXI_GP1_WDATA;
  sc_core::sc_in< sc_dt::sc_bv<4> > S_AXI_GP1_ARCACHE;
  sc_core::sc_in< sc_dt::sc_bv<4> > S_AXI_GP1_ARLEN;
  sc_core::sc_in< sc_dt::sc_bv<4> > S_AXI_GP1_ARQOS;
  sc_core::sc_in< sc_dt::sc_bv<4> > S_AXI_GP1_AWCACHE;
  sc_core::sc_in< sc_dt::sc_bv<4> > S_AXI_GP1_AWLEN;
  sc_core::sc_in< sc_dt::sc_bv<4> > S_AXI_GP1_AWQOS;
  sc_core::sc_in< sc_dt::sc_bv<4> > S_AXI_GP1_WSTRB;
  sc_core::sc_in< sc_dt::sc_bv<6> > S_AXI_GP1_ARID;
  sc_core::sc_in< sc_dt::sc_bv<6> > S_AXI_GP1_AWID;
  sc_core::sc_in< sc_dt::sc_bv<6> > S_AXI_GP1_WID;
  sc_core::sc_out< bool > S_AXI_ACP_ARREADY;
  sc_core::sc_out< bool > S_AXI_ACP_AWREADY;
  sc_core::sc_out< bool > S_AXI_ACP_BVALID;
  sc_core::sc_out< bool > S_AXI_ACP_RLAST;
  sc_core::sc_out< bool > S_AXI_ACP_RVALID;
  sc_core::sc_out< bool > S_AXI_ACP_WREADY;
  sc_core::sc_out< sc_dt::sc_bv<2> > S_AXI_ACP_BRESP;
  sc_core::sc_out< sc_dt::sc_bv<2> > S_AXI_ACP_RRESP;
  sc_core::sc_out< sc_dt::sc_bv<3> > S_AXI_ACP_BID;
  sc_core::sc_out< sc_dt::sc_bv<3> > S_AXI_ACP_RID;
  sc_core::sc_out< sc_dt::sc_bv<64> > S_AXI_ACP_RDATA;
  sc_core::sc_in< bool > S_AXI_ACP_ACLK;
  sc_core::sc_in< bool > S_AXI_ACP_ARVALID;
  sc_core::sc_in< bool > S_AXI_ACP_AWVALID;
  sc_core::sc_in< bool > S_AXI_ACP_BREADY;
  sc_core::sc_in< bool > S_AXI_ACP_RREADY;
  sc_core::sc_in< bool > S_AXI_ACP_WLAST;
  sc_core::sc_in< bool > S_AXI_ACP_WVALID;
  sc_core::sc_in< sc_dt::sc_bv<3> > S_AXI_ACP_ARID;
  sc_core::sc_in< sc_dt::sc_bv<3> > S_AXI_ACP_ARPROT;
  sc_core::sc_in< sc_dt::sc_bv<3> > S_AXI_ACP_AWID;
  sc_core::sc_in< sc_dt::sc_bv<3> > S_AXI_ACP_AWPROT;
  sc_core::sc_in< sc_dt::sc_bv<3> > S_AXI_ACP_WID;
  sc_core::sc_in< sc_dt::sc_bv<32> > S_AXI_ACP_ARADDR;
  sc_core::sc_in< sc_dt::sc_bv<32> > S_AXI_ACP_AWADDR;
  sc_core::sc_in< sc_dt::sc_bv<4> > S_AXI_ACP_ARCACHE;
  sc_core::sc_in< sc_dt::sc_bv<4> > S_AXI_ACP_ARLEN;
  sc_core::sc_in< sc_dt::sc_bv<4> > S_AXI_ACP_ARQOS;
  sc_core::sc_in< sc_dt::sc_bv<4> > S_AXI_ACP_AWCACHE;
  sc_core::sc_in< sc_dt::sc_bv<4> > S_AXI_ACP_AWLEN;
  sc_core::sc_in< sc_dt::sc_bv<4> > S_AXI_ACP_AWQOS;
  sc_core::sc_in< sc_dt::sc_bv<2> > S_AXI_ACP_ARBURST;
  sc_core::sc_in< sc_dt::sc_bv<2> > S_AXI_ACP_ARLOCK;
  sc_core::sc_in< sc_dt::sc_bv<3> > S_AXI_ACP_ARSIZE;
  sc_core::sc_in< sc_dt::sc_bv<2> > S_AXI_ACP_AWBURST;
  sc_core::sc_in< sc_dt::sc_bv<2> > S_AXI_ACP_AWLOCK;
  sc_core::sc_in< sc_dt::sc_bv<3> > S_AXI_ACP_AWSIZE;
  sc_core::sc_in< sc_dt::sc_bv<5> > S_AXI_ACP_ARUSER;
  sc_core::sc_in< sc_dt::sc_bv<5> > S_AXI_ACP_AWUSER;
  sc_core::sc_in< sc_dt::sc_bv<64> > S_AXI_ACP_WDATA;
  sc_core::sc_in< sc_dt::sc_bv<8> > S_AXI_ACP_WSTRB;
  sc_core::sc_out< bool > S_AXI_HP0_ARREADY;
  sc_core::sc_out< bool > S_AXI_HP0_AWREADY;
  sc_core::sc_out< bool > S_AXI_HP0_BVALID;
  sc_core::sc_out< bool > S_AXI_HP0_RLAST;
  sc_core::sc_out< bool > S_AXI_HP0_RVALID;
  sc_core::sc_out< bool > S_AXI_HP0_WREADY;
  sc_core::sc_out< sc_dt::sc_bv<2> > S_AXI_HP0_BRESP;
  sc_core::sc_out< sc_dt::sc_bv<2> > S_AXI_HP0_RRESP;
  sc_core::sc_out< sc_dt::sc_bv<6> > S_AXI_HP0_BID;
  sc_core::sc_out< sc_dt::sc_bv<6> > S_AXI_HP0_RID;
  sc_core::sc_out< sc_dt::sc_bv<64> > S_AXI_HP0_RDATA;
  sc_core::sc_out< sc_dt::sc_bv<8> > S_AXI_HP0_RCOUNT;
  sc_core::sc_out< sc_dt::sc_bv<8> > S_AXI_HP0_WCOUNT;
  sc_core::sc_out< sc_dt::sc_bv<3> > S_AXI_HP0_RACOUNT;
  sc_core::sc_out< sc_dt::sc_bv<6> > S_AXI_HP0_WACOUNT;
  sc_core::sc_in< bool > S_AXI_HP0_ACLK;
  sc_core::sc_in< bool > S_AXI_HP0_ARVALID;
  sc_core::sc_in< bool > S_AXI_HP0_AWVALID;
  sc_core::sc_in< bool > S_AXI_HP0_BREADY;
  sc_core::sc_in< bool > S_AXI_HP0_RDISSUECAP1_EN;
  sc_core::sc_in< bool > S_AXI_HP0_RREADY;
  sc_core::sc_in< bool > S_AXI_HP0_WLAST;
  sc_core::sc_in< bool > S_AXI_HP0_WRISSUECAP1_EN;
  sc_core::sc_in< bool > S_AXI_HP0_WVALID;
  sc_core::sc_in< sc_dt::sc_bv<2> > S_AXI_HP0_ARBURST;
  sc_core::sc_in< sc_dt::sc_bv<2> > S_AXI_HP0_ARLOCK;
  sc_core::sc_in< sc_dt::sc_bv<3> > S_AXI_HP0_ARSIZE;
  sc_core::sc_in< sc_dt::sc_bv<2> > S_AXI_HP0_AWBURST;
  sc_core::sc_in< sc_dt::sc_bv<2> > S_AXI_HP0_AWLOCK;
  sc_core::sc_in< sc_dt::sc_bv<3> > S_AXI_HP0_AWSIZE;
  sc_core::sc_in< sc_dt::sc_bv<3> > S_AXI_HP0_ARPROT;
  sc_core::sc_in< sc_dt::sc_bv<3> > S_AXI_HP0_AWPROT;
  sc_core::sc_in< sc_dt::sc_bv<32> > S_AXI_HP0_ARADDR;
  sc_core::sc_in< sc_dt::sc_bv<32> > S_AXI_HP0_AWADDR;
  sc_core::sc_in< sc_dt::sc_bv<4> > S_AXI_HP0_ARCACHE;
  sc_core::sc_in< sc_dt::sc_bv<4> > S_AXI_HP0_ARLEN;
  sc_core::sc_in< sc_dt::sc_bv<4> > S_AXI_HP0_ARQOS;
  sc_core::sc_in< sc_dt::sc_bv<4> > S_AXI_HP0_AWCACHE;
  sc_core::sc_in< sc_dt::sc_bv<4> > S_AXI_HP0_AWLEN;
  sc_core::sc_in< sc_dt::sc_bv<4> > S_AXI_HP0_AWQOS;
  sc_core::sc_in< sc_dt::sc_bv<6> > S_AXI_HP0_ARID;
  sc_core::sc_in< sc_dt::sc_bv<6> > S_AXI_HP0_AWID;
  sc_core::sc_in< sc_dt::sc_bv<6> > S_AXI_HP0_WID;
  sc_core::sc_in< sc_dt::sc_bv<64> > S_AXI_HP0_WDATA;
  sc_core::sc_in< sc_dt::sc_bv<8> > S_AXI_HP0_WSTRB;
  sc_core::sc_out< bool > S_AXI_HP1_ARREADY;
  sc_core::sc_out< bool > S_AXI_HP1_AWREADY;
  sc_core::sc_out< bool > S_AXI_HP1_BVALID;
  sc_core::sc_out< bool > S_AXI_HP1_RLAST;
  sc_core::sc_out< bool > S_AXI_HP1_RVALID;
  sc_core::sc_out< bool > S_AXI_HP1_WREADY;
  sc_core::sc_out< sc_dt::sc_bv<2> > S_AXI_HP1_BRESP;
  sc_core::sc_out< sc_dt::sc_bv<2> > S_AXI_HP1_RRESP;
  sc_core::sc_out< sc_dt::sc_bv<6> > S_AXI_HP1_BID;
  sc_core::sc_out< sc_dt::sc_bv<6> > S_AXI_HP1_RID;
  sc_core::sc_out< sc_dt::sc_bv<64> > S_AXI_HP1_RDATA;
  sc_core::sc_out< sc_dt::sc_bv<8> > S_AXI_HP1_RCOUNT;
  sc_core::sc_out< sc_dt::sc_bv<8> > S_AXI_HP1_WCOUNT;
  sc_core::sc_out< sc_dt::sc_bv<3> > S_AXI_HP1_RACOUNT;
  sc_core::sc_out< sc_dt::sc_bv<6> > S_AXI_HP1_WACOUNT;
  sc_core::sc_in< bool > S_AXI_HP1_ACLK;
  sc_core::sc_in< bool > S_AXI_HP1_ARVALID;
  sc_core::sc_in< bool > S_AXI_HP1_AWVALID;
  sc_core::sc_in< bool > S_AXI_HP1_BREADY;
  sc_core::sc_in< bool > S_AXI_HP1_RDISSUECAP1_EN;
  sc_core::sc_in< bool > S_AXI_HP1_RREADY;
  sc_core::sc_in< bool > S_AXI_HP1_WLAST;
  sc_core::sc_in< bool > S_AXI_HP1_WRISSUECAP1_EN;
  sc_core::sc_in< bool > S_AXI_HP1_WVALID;
  sc_core::sc_in< sc_dt::sc_bv<2> > S_AXI_HP1_ARBURST;
  sc_core::sc_in< sc_dt::sc_bv<2> > S_AXI_HP1_ARLOCK;
  sc_core::sc_in< sc_dt::sc_bv<3> > S_AXI_HP1_ARSIZE;
  sc_core::sc_in< sc_dt::sc_bv<2> > S_AXI_HP1_AWBURST;
  sc_core::sc_in< sc_dt::sc_bv<2> > S_AXI_HP1_AWLOCK;
  sc_core::sc_in< sc_dt::sc_bv<3> > S_AXI_HP1_AWSIZE;
  sc_core::sc_in< sc_dt::sc_bv<3> > S_AXI_HP1_ARPROT;
  sc_core::sc_in< sc_dt::sc_bv<3> > S_AXI_HP1_AWPROT;
  sc_core::sc_in< sc_dt::sc_bv<32> > S_AXI_HP1_ARADDR;
  sc_core::sc_in< sc_dt::sc_bv<32> > S_AXI_HP1_AWADDR;
  sc_core::sc_in< sc_dt::sc_bv<4> > S_AXI_HP1_ARCACHE;
  sc_core::sc_in< sc_dt::sc_bv<4> > S_AXI_HP1_ARLEN;
  sc_core::sc_in< sc_dt::sc_bv<4> > S_AXI_HP1_ARQOS;
  sc_core::sc_in< sc_dt::sc_bv<4> > S_AXI_HP1_AWCACHE;
  sc_core::sc_in< sc_dt::sc_bv<4> > S_AXI_HP1_AWLEN;
  sc_core::sc_in< sc_dt::sc_bv<4> > S_AXI_HP1_AWQOS;
  sc_core::sc_in< sc_dt::sc_bv<6> > S_AXI_HP1_ARID;
  sc_core::sc_in< sc_dt::sc_bv<6> > S_AXI_HP1_AWID;
  sc_core::sc_in< sc_dt::sc_bv<6> > S_AXI_HP1_WID;
  sc_core::sc_in< sc_dt::sc_bv<64> > S_AXI_HP1_WDATA;
  sc_core::sc_in< sc_dt::sc_bv<8> > S_AXI_HP1_WSTRB;
  sc_core::sc_in< sc_dt::sc_bv<2> > IRQ_F2P;
  sc_core::sc_out< sc_dt::sc_bv<2> > DMA0_DATYPE;
  sc_core::sc_out< bool > DMA0_DAVALID;
  sc_core::sc_out< bool > DMA0_DRREADY;
  sc_core::sc_in< bool > DMA0_ACLK;
  sc_core::sc_in< bool > DMA0_DAREADY;
  sc_core::sc_in< bool > DMA0_DRLAST;
  sc_core::sc_in< bool > DMA0_DRVALID;
  sc_core::sc_in< sc_dt::sc_bv<2> > DMA0_DRTYPE;
  sc_core::sc_out< bool > FCLK_CLK0;
  sc_core::sc_out< bool > FCLK_CLK1;
  sc_core::sc_out< bool > FCLK_CLK2;
  sc_core::sc_out< bool > FCLK_CLK3;
  sc_core::sc_out< bool > FCLK_RESET0_N;
  sc_core::sc_out< bool > FCLK_RESET1_N;
  sc_core::sc_out< bool > FCLK_RESET2_N;
  sc_core::sc_out< bool > FCLK_RESET3_N;
  sc_core::sc_in< sc_dt::sc_bv<32> > FTMT_F2P_DEBUG;
  sc_core::sc_out< sc_dt::sc_bv<32> > FTMT_P2F_DEBUG;
  sc_core::sc_out< sc_dt::sc_bv<54> > MIO;
  sc_core::sc_out< bool > DDR_CAS_n;
  sc_core::sc_out< bool > DDR_CKE;
  sc_core::sc_out< bool > DDR_Clk_n;
  sc_core::sc_out< bool > DDR_Clk;
  sc_core::sc_out< bool > DDR_CS_n;
  sc_core::sc_out< bool > DDR_DRSTB;
  sc_core::sc_out< bool > DDR_ODT;
  sc_core::sc_out< bool > DDR_RAS_n;
  sc_core::sc_out< bool > DDR_WEB;
  sc_core::sc_out< sc_dt::sc_bv<3> > DDR_BankAddr;
  sc_core::sc_out< sc_dt::sc_bv<15> > DDR_Addr;
  sc_core::sc_out< bool > DDR_VRN;
  sc_core::sc_out< bool > DDR_VRP;
  sc_core::sc_out< sc_dt::sc_bv<4> > DDR_DM;
  sc_core::sc_out< sc_dt::sc_bv<32> > DDR_DQ;
  sc_core::sc_out< sc_dt::sc_bv<4> > DDR_DQS_n;
  sc_core::sc_out< sc_dt::sc_bv<4> > DDR_DQS;
  sc_core::sc_out< bool > PS_SRSTB;
  sc_core::sc_out< bool > PS_CLK;
  sc_core::sc_out< bool > PS_PORB;

  // Dummy Signals for IP Ports


protected:

  virtual void before_end_of_elaboration();

private:

  xtlm::xaxis_pin2xtlm_t<1,2,1,1,1,1>* mp_DMA0_REQ_transactor;
  sc_signal< bool > m_DMA0_REQ_transactor_rst_signal;
  xtlm::xaxis_xtlm2pin_t<1,2,1,1,1,1>* mp_DMA0_ACK_transactor;
  sc_signal< bool > m_DMA0_ACK_transactor_rst_signal;
  xtlm::xaximm_xtlm2pin_t<32,32,12,1,1,1,1,1>* mp_M_AXI_GP0_transactor;
  xsc::common::scalar2vectorN_converter<2>* mp_M_AXI_GP0_ARLOCK_converter;
  sc_signal< bool > m_M_AXI_GP0_ARLOCK_converter_signal;
  xsc::common::scalar2vectorN_converter<2>* mp_M_AXI_GP0_AWLOCK_converter;
  sc_signal< bool > m_M_AXI_GP0_AWLOCK_converter_signal;
  xsc::common::vector2vector_converter<8,4>* mp_M_AXI_GP0_ARLEN_converter;
  sc_signal< sc_bv<8> > m_M_AXI_GP0_ARLEN_converter_signal;
  xsc::common::vector2vector_converter<8,4>* mp_M_AXI_GP0_AWLEN_converter;
  sc_signal< sc_bv<8> > m_M_AXI_GP0_AWLEN_converter_signal;
  sc_signal< bool > m_M_AXI_GP0_transactor_rst_signal;
  xtlm::xaximm_xtlm2pin_t<32,32,12,1,1,1,1,1>* mp_M_AXI_GP1_transactor;
  xsc::common::scalar2vectorN_converter<2>* mp_M_AXI_GP1_ARLOCK_converter;
  sc_signal< bool > m_M_AXI_GP1_ARLOCK_converter_signal;
  xsc::common::scalar2vectorN_converter<2>* mp_M_AXI_GP1_AWLOCK_converter;
  sc_signal< bool > m_M_AXI_GP1_AWLOCK_converter_signal;
  xsc::common::vector2vector_converter<8,4>* mp_M_AXI_GP1_ARLEN_converter;
  sc_signal< sc_bv<8> > m_M_AXI_GP1_ARLEN_converter_signal;
  xsc::common::vector2vector_converter<8,4>* mp_M_AXI_GP1_AWLEN_converter;
  sc_signal< sc_bv<8> > m_M_AXI_GP1_AWLEN_converter_signal;
  sc_signal< bool > m_M_AXI_GP1_transactor_rst_signal;
  xtlm::xaximm_pin2xtlm_t<64,32,3,5,1,1,5,1>* mp_S_AXI_ACP_transactor;
  xsc::common::vector2vector_converter<4,8>* mp_S_AXI_ACP_ARLEN_converter;
  sc_signal< sc_bv<8> > m_S_AXI_ACP_ARLEN_converter_signal;
  xsc::common::vector2vector_converter<4,8>* mp_S_AXI_ACP_AWLEN_converter;
  sc_signal< sc_bv<8> > m_S_AXI_ACP_AWLEN_converter_signal;
  xsc::common::vectorN2scalar_converter<2>* mp_S_AXI_ACP_ARLOCK_converter;
  sc_signal< bool > m_S_AXI_ACP_ARLOCK_converter_signal;
  xsc::common::vectorN2scalar_converter<2>* mp_S_AXI_ACP_AWLOCK_converter;
  sc_signal< bool > m_S_AXI_ACP_AWLOCK_converter_signal;
  sc_signal< bool > m_S_AXI_ACP_transactor_rst_signal;
  xtlm::xaximm_pin2xtlm_t<32,32,6,1,1,1,1,1>* mp_S_AXI_GP0_transactor;
  xsc::common::vectorN2scalar_converter<2>* mp_S_AXI_GP0_ARLOCK_converter;
  sc_signal< bool > m_S_AXI_GP0_ARLOCK_converter_signal;
  xsc::common::vectorN2scalar_converter<2>* mp_S_AXI_GP0_AWLOCK_converter;
  sc_signal< bool > m_S_AXI_GP0_AWLOCK_converter_signal;
  xsc::common::vector2vector_converter<4,8>* mp_S_AXI_GP0_ARLEN_converter;
  sc_signal< sc_bv<8> > m_S_AXI_GP0_ARLEN_converter_signal;
  xsc::common::vector2vector_converter<4,8>* mp_S_AXI_GP0_AWLEN_converter;
  sc_signal< sc_bv<8> > m_S_AXI_GP0_AWLEN_converter_signal;
  sc_signal< bool > m_S_AXI_GP0_transactor_rst_signal;
  xtlm::xaximm_pin2xtlm_t<32,32,6,1,1,1,1,1>* mp_S_AXI_GP1_transactor;
  xsc::common::vectorN2scalar_converter<2>* mp_S_AXI_GP1_ARLOCK_converter;
  sc_signal< bool > m_S_AXI_GP1_ARLOCK_converter_signal;
  xsc::common::vectorN2scalar_converter<2>* mp_S_AXI_GP1_AWLOCK_converter;
  sc_signal< bool > m_S_AXI_GP1_AWLOCK_converter_signal;
  xsc::common::vector2vector_converter<4,8>* mp_S_AXI_GP1_ARLEN_converter;
  sc_signal< sc_bv<8> > m_S_AXI_GP1_ARLEN_converter_signal;
  xsc::common::vector2vector_converter<4,8>* mp_S_AXI_GP1_AWLEN_converter;
  sc_signal< sc_bv<8> > m_S_AXI_GP1_AWLEN_converter_signal;
  sc_signal< bool > m_S_AXI_GP1_transactor_rst_signal;
  xtlm::xaximm_pin2xtlm_t<64,32,6,1,1,1,1,1>* mp_S_AXI_HP0_transactor;
  xsc::common::vectorN2scalar_converter<2>* mp_S_AXI_HP0_ARLOCK_converter;
  sc_signal< bool > m_S_AXI_HP0_ARLOCK_converter_signal;
  xsc::common::vectorN2scalar_converter<2>* mp_S_AXI_HP0_AWLOCK_converter;
  sc_signal< bool > m_S_AXI_HP0_AWLOCK_converter_signal;
  xsc::common::vector2vector_converter<4,8>* mp_S_AXI_HP0_ARLEN_converter;
  sc_signal< sc_bv<8> > m_S_AXI_HP0_ARLEN_converter_signal;
  xsc::common::vector2vector_converter<4,8>* mp_S_AXI_HP0_AWLEN_converter;
  sc_signal< sc_bv<8> > m_S_AXI_HP0_AWLEN_converter_signal;
  sc_signal< bool > m_S_AXI_HP0_transactor_rst_signal;
  xtlm::xaximm_pin2xtlm_t<64,32,6,1,1,1,1,1>* mp_S_AXI_HP1_transactor;
  xsc::common::vectorN2scalar_converter<2>* mp_S_AXI_HP1_ARLOCK_converter;
  sc_signal< bool > m_S_AXI_HP1_ARLOCK_converter_signal;
  xsc::common::vectorN2scalar_converter<2>* mp_S_AXI_HP1_AWLOCK_converter;
  sc_signal< bool > m_S_AXI_HP1_AWLOCK_converter_signal;
  xsc::common::vector2vector_converter<4,8>* mp_S_AXI_HP1_ARLEN_converter;
  sc_signal< sc_bv<8> > m_S_AXI_HP1_ARLEN_converter_signal;
  xsc::common::vector2vector_converter<4,8>* mp_S_AXI_HP1_AWLEN_converter;
  sc_signal< sc_bv<8> > m_S_AXI_HP1_AWLEN_converter_signal;
  sc_signal< bool > m_S_AXI_HP1_transactor_rst_signal;

};
#endif // XILINX_SIMULATOR




#ifdef XM_SYSTEMC
class DllExport design_1_processing_system7_0_0 : public design_1_processing_system7_0_0_sc
{
public:

  design_1_processing_system7_0_0(const sc_core::sc_module_name& nm);
  virtual ~design_1_processing_system7_0_0();

  // module pin-to-pin RTL interface

  sc_core::sc_out< bool > CAN0_PHY_TX;
  sc_core::sc_in< bool > CAN0_PHY_RX;
  sc_core::sc_in< bool > PJTAG_TCK;
  sc_core::sc_in< bool > PJTAG_TMS;
  sc_core::sc_in< bool > PJTAG_TDI;
  sc_core::sc_out< bool > PJTAG_TDO;
  sc_core::sc_in< bool > SPI0_SCLK_I;
  sc_core::sc_out< bool > SPI0_SCLK_O;
  sc_core::sc_out< bool > SPI0_SCLK_T;
  sc_core::sc_in< bool > SPI0_MOSI_I;
  sc_core::sc_out< bool > SPI0_MOSI_O;
  sc_core::sc_out< bool > SPI0_MOSI_T;
  sc_core::sc_in< bool > SPI0_MISO_I;
  sc_core::sc_out< bool > SPI0_MISO_O;
  sc_core::sc_out< bool > SPI0_MISO_T;
  sc_core::sc_in< bool > SPI0_SS_I;
  sc_core::sc_out< bool > SPI0_SS_O;
  sc_core::sc_out< bool > SPI0_SS1_O;
  sc_core::sc_out< bool > SPI0_SS2_O;
  sc_core::sc_out< bool > SPI0_SS_T;
  sc_core::sc_out< bool > TTC0_WAVE0_OUT;
  sc_core::sc_out< bool > TTC0_WAVE1_OUT;
  sc_core::sc_out< bool > TTC0_WAVE2_OUT;
  sc_core::sc_out< sc_dt::sc_bv<2> > USB0_PORT_INDCTL;
  sc_core::sc_out< bool > USB0_VBUS_PWRSELECT;
  sc_core::sc_in< bool > USB0_VBUS_PWRFAULT;
  sc_core::sc_out< bool > M_AXI_GP0_ARVALID;
  sc_core::sc_out< bool > M_AXI_GP0_AWVALID;
  sc_core::sc_out< bool > M_AXI_GP0_BREADY;
  sc_core::sc_out< bool > M_AXI_GP0_RREADY;
  sc_core::sc_out< bool > M_AXI_GP0_WLAST;
  sc_core::sc_out< bool > M_AXI_GP0_WVALID;
  sc_core::sc_out< sc_dt::sc_bv<12> > M_AXI_GP0_ARID;
  sc_core::sc_out< sc_dt::sc_bv<12> > M_AXI_GP0_AWID;
  sc_core::sc_out< sc_dt::sc_bv<12> > M_AXI_GP0_WID;
  sc_core::sc_out< sc_dt::sc_bv<2> > M_AXI_GP0_ARBURST;
  sc_core::sc_out< sc_dt::sc_bv<2> > M_AXI_GP0_ARLOCK;
  sc_core::sc_out< sc_dt::sc_bv<3> > M_AXI_GP0_ARSIZE;
  sc_core::sc_out< sc_dt::sc_bv<2> > M_AXI_GP0_AWBURST;
  sc_core::sc_out< sc_dt::sc_bv<2> > M_AXI_GP0_AWLOCK;
  sc_core::sc_out< sc_dt::sc_bv<3> > M_AXI_GP0_AWSIZE;
  sc_core::sc_out< sc_dt::sc_bv<3> > M_AXI_GP0_ARPROT;
  sc_core::sc_out< sc_dt::sc_bv<3> > M_AXI_GP0_AWPROT;
  sc_core::sc_out< sc_dt::sc_bv<32> > M_AXI_GP0_ARADDR;
  sc_core::sc_out< sc_dt::sc_bv<32> > M_AXI_GP0_AWADDR;
  sc_core::sc_out< sc_dt::sc_bv<32> > M_AXI_GP0_WDATA;
  sc_core::sc_out< sc_dt::sc_bv<4> > M_AXI_GP0_ARCACHE;
  sc_core::sc_out< sc_dt::sc_bv<4> > M_AXI_GP0_ARLEN;
  sc_core::sc_out< sc_dt::sc_bv<4> > M_AXI_GP0_ARQOS;
  sc_core::sc_out< sc_dt::sc_bv<4> > M_AXI_GP0_AWCACHE;
  sc_core::sc_out< sc_dt::sc_bv<4> > M_AXI_GP0_AWLEN;
  sc_core::sc_out< sc_dt::sc_bv<4> > M_AXI_GP0_AWQOS;
  sc_core::sc_out< sc_dt::sc_bv<4> > M_AXI_GP0_WSTRB;
  sc_core::sc_in< bool > M_AXI_GP0_ACLK;
  sc_core::sc_in< bool > M_AXI_GP0_ARREADY;
  sc_core::sc_in< bool > M_AXI_GP0_AWREADY;
  sc_core::sc_in< bool > M_AXI_GP0_BVALID;
  sc_core::sc_in< bool > M_AXI_GP0_RLAST;
  sc_core::sc_in< bool > M_AXI_GP0_RVALID;
  sc_core::sc_in< bool > M_AXI_GP0_WREADY;
  sc_core::sc_in< sc_dt::sc_bv<12> > M_AXI_GP0_BID;
  sc_core::sc_in< sc_dt::sc_bv<12> > M_AXI_GP0_RID;
  sc_core::sc_in< sc_dt::sc_bv<2> > M_AXI_GP0_BRESP;
  sc_core::sc_in< sc_dt::sc_bv<2> > M_AXI_GP0_RRESP;
  sc_core::sc_in< sc_dt::sc_bv<32> > M_AXI_GP0_RDATA;
  sc_core::sc_out< bool > M_AXI_GP1_ARVALID;
  sc_core::sc_out< bool > M_AXI_GP1_AWVALID;
  sc_core::sc_out< bool > M_AXI_GP1_BREADY;
  sc_core::sc_out< bool > M_AXI_GP1_RREADY;
  sc_core::sc_out< bool > M_AXI_GP1_WLAST;
  sc_core::sc_out< bool > M_AXI_GP1_WVALID;
  sc_core::sc_out< sc_dt::sc_bv<12> > M_AXI_GP1_ARID;
  sc_core::sc_out< sc_dt::sc_bv<12> > M_AXI_GP1_AWID;
  sc_core::sc_out< sc_dt::sc_bv<12> > M_AXI_GP1_WID;
  sc_core::sc_out< sc_dt::sc_bv<2> > M_AXI_GP1_ARBURST;
  sc_core::sc_out< sc_dt::sc_bv<2> > M_AXI_GP1_ARLOCK;
  sc_core::sc_out< sc_dt::sc_bv<3> > M_AXI_GP1_ARSIZE;
  sc_core::sc_out< sc_dt::sc_bv<2> > M_AXI_GP1_AWBURST;
  sc_core::sc_out< sc_dt::sc_bv<2> > M_AXI_GP1_AWLOCK;
  sc_core::sc_out< sc_dt::sc_bv<3> > M_AXI_GP1_AWSIZE;
  sc_core::sc_out< sc_dt::sc_bv<3> > M_AXI_GP1_ARPROT;
  sc_core::sc_out< sc_dt::sc_bv<3> > M_AXI_GP1_AWPROT;
  sc_core::sc_out< sc_dt::sc_bv<32> > M_AXI_GP1_ARADDR;
  sc_core::sc_out< sc_dt::sc_bv<32> > M_AXI_GP1_AWADDR;
  sc_core::sc_out< sc_dt::sc_bv<32> > M_AXI_GP1_WDATA;
  sc_core::sc_out< sc_dt::sc_bv<4> > M_AXI_GP1_ARCACHE;
  sc_core::sc_out< sc_dt::sc_bv<4> > M_AXI_GP1_ARLEN;
  sc_core::sc_out< sc_dt::sc_bv<4> > M_AXI_GP1_ARQOS;
  sc_core::sc_out< sc_dt::sc_bv<4> > M_AXI_GP1_AWCACHE;
  sc_core::sc_out< sc_dt::sc_bv<4> > M_AXI_GP1_AWLEN;
  sc_core::sc_out< sc_dt::sc_bv<4> > M_AXI_GP1_AWQOS;
  sc_core::sc_out< sc_dt::sc_bv<4> > M_AXI_GP1_WSTRB;
  sc_core::sc_in< bool > M_AXI_GP1_ACLK;
  sc_core::sc_in< bool > M_AXI_GP1_ARREADY;
  sc_core::sc_in< bool > M_AXI_GP1_AWREADY;
  sc_core::sc_in< bool > M_AXI_GP1_BVALID;
  sc_core::sc_in< bool > M_AXI_GP1_RLAST;
  sc_core::sc_in< bool > M_AXI_GP1_RVALID;
  sc_core::sc_in< bool > M_AXI_GP1_WREADY;
  sc_core::sc_in< sc_dt::sc_bv<12> > M_AXI_GP1_BID;
  sc_core::sc_in< sc_dt::sc_bv<12> > M_AXI_GP1_RID;
  sc_core::sc_in< sc_dt::sc_bv<2> > M_AXI_GP1_BRESP;
  sc_core::sc_in< sc_dt::sc_bv<2> > M_AXI_GP1_RRESP;
  sc_core::sc_in< sc_dt::sc_bv<32> > M_AXI_GP1_RDATA;
  sc_core::sc_out< bool > S_AXI_GP0_ARREADY;
  sc_core::sc_out< bool > S_AXI_GP0_AWREADY;
  sc_core::sc_out< bool > S_AXI_GP0_BVALID;
  sc_core::sc_out< bool > S_AXI_GP0_RLAST;
  sc_core::sc_out< bool > S_AXI_GP0_RVALID;
  sc_core::sc_out< bool > S_AXI_GP0_WREADY;
  sc_core::sc_out< sc_dt::sc_bv<2> > S_AXI_GP0_BRESP;
  sc_core::sc_out< sc_dt::sc_bv<2> > S_AXI_GP0_RRESP;
  sc_core::sc_out< sc_dt::sc_bv<32> > S_AXI_GP0_RDATA;
  sc_core::sc_out< sc_dt::sc_bv<6> > S_AXI_GP0_BID;
  sc_core::sc_out< sc_dt::sc_bv<6> > S_AXI_GP0_RID;
  sc_core::sc_in< bool > S_AXI_GP0_ACLK;
  sc_core::sc_in< bool > S_AXI_GP0_ARVALID;
  sc_core::sc_in< bool > S_AXI_GP0_AWVALID;
  sc_core::sc_in< bool > S_AXI_GP0_BREADY;
  sc_core::sc_in< bool > S_AXI_GP0_RREADY;
  sc_core::sc_in< bool > S_AXI_GP0_WLAST;
  sc_core::sc_in< bool > S_AXI_GP0_WVALID;
  sc_core::sc_in< sc_dt::sc_bv<2> > S_AXI_GP0_ARBURST;
  sc_core::sc_in< sc_dt::sc_bv<2> > S_AXI_GP0_ARLOCK;
  sc_core::sc_in< sc_dt::sc_bv<3> > S_AXI_GP0_ARSIZE;
  sc_core::sc_in< sc_dt::sc_bv<2> > S_AXI_GP0_AWBURST;
  sc_core::sc_in< sc_dt::sc_bv<2> > S_AXI_GP0_AWLOCK;
  sc_core::sc_in< sc_dt::sc_bv<3> > S_AXI_GP0_AWSIZE;
  sc_core::sc_in< sc_dt::sc_bv<3> > S_AXI_GP0_ARPROT;
  sc_core::sc_in< sc_dt::sc_bv<3> > S_AXI_GP0_AWPROT;
  sc_core::sc_in< sc_dt::sc_bv<32> > S_AXI_GP0_ARADDR;
  sc_core::sc_in< sc_dt::sc_bv<32> > S_AXI_GP0_AWADDR;
  sc_core::sc_in< sc_dt::sc_bv<32> > S_AXI_GP0_WDATA;
  sc_core::sc_in< sc_dt::sc_bv<4> > S_AXI_GP0_ARCACHE;
  sc_core::sc_in< sc_dt::sc_bv<4> > S_AXI_GP0_ARLEN;
  sc_core::sc_in< sc_dt::sc_bv<4> > S_AXI_GP0_ARQOS;
  sc_core::sc_in< sc_dt::sc_bv<4> > S_AXI_GP0_AWCACHE;
  sc_core::sc_in< sc_dt::sc_bv<4> > S_AXI_GP0_AWLEN;
  sc_core::sc_in< sc_dt::sc_bv<4> > S_AXI_GP0_AWQOS;
  sc_core::sc_in< sc_dt::sc_bv<4> > S_AXI_GP0_WSTRB;
  sc_core::sc_in< sc_dt::sc_bv<6> > S_AXI_GP0_ARID;
  sc_core::sc_in< sc_dt::sc_bv<6> > S_AXI_GP0_AWID;
  sc_core::sc_in< sc_dt::sc_bv<6> > S_AXI_GP0_WID;
  sc_core::sc_out< bool > S_AXI_GP1_ARREADY;
  sc_core::sc_out< bool > S_AXI_GP1_AWREADY;
  sc_core::sc_out< bool > S_AXI_GP1_BVALID;
  sc_core::sc_out< bool > S_AXI_GP1_RLAST;
  sc_core::sc_out< bool > S_AXI_GP1_RVALID;
  sc_core::sc_out< bool > S_AXI_GP1_WREADY;
  sc_core::sc_out< sc_dt::sc_bv<2> > S_AXI_GP1_BRESP;
  sc_core::sc_out< sc_dt::sc_bv<2> > S_AXI_GP1_RRESP;
  sc_core::sc_out< sc_dt::sc_bv<32> > S_AXI_GP1_RDATA;
  sc_core::sc_out< sc_dt::sc_bv<6> > S_AXI_GP1_BID;
  sc_core::sc_out< sc_dt::sc_bv<6> > S_AXI_GP1_RID;
  sc_core::sc_in< bool > S_AXI_GP1_ACLK;
  sc_core::sc_in< bool > S_AXI_GP1_ARVALID;
  sc_core::sc_in< bool > S_AXI_GP1_AWVALID;
  sc_core::sc_in< bool > S_AXI_GP1_BREADY;
  sc_core::sc_in< bool > S_AXI_GP1_RREADY;
  sc_core::sc_in< bool > S_AXI_GP1_WLAST;
  sc_core::sc_in< bool > S_AXI_GP1_WVALID;
  sc_core::sc_in< sc_dt::sc_bv<2> > S_AXI_GP1_ARBURST;
  sc_core::sc_in< sc_dt::sc_bv<2> > S_AXI_GP1_ARLOCK;
  sc_core::sc_in< sc_dt::sc_bv<3> > S_AXI_GP1_ARSIZE;
  sc_core::sc_in< sc_dt::sc_bv<2> > S_AXI_GP1_AWBURST;
  sc_core::sc_in< sc_dt::sc_bv<2> > S_AXI_GP1_AWLOCK;
  sc_core::sc_in< sc_dt::sc_bv<3> > S_AXI_GP1_AWSIZE;
  sc_core::sc_in< sc_dt::sc_bv<3> > S_AXI_GP1_ARPROT;
  sc_core::sc_in< sc_dt::sc_bv<3> > S_AXI_GP1_AWPROT;
  sc_core::sc_in< sc_dt::sc_bv<32> > S_AXI_GP1_ARADDR;
  sc_core::sc_in< sc_dt::sc_bv<32> > S_AXI_GP1_AWADDR;
  sc_core::sc_in< sc_dt::sc_bv<32> > S_AXI_GP1_WDATA;
  sc_core::sc_in< sc_dt::sc_bv<4> > S_AXI_GP1_ARCACHE;
  sc_core::sc_in< sc_dt::sc_bv<4> > S_AXI_GP1_ARLEN;
  sc_core::sc_in< sc_dt::sc_bv<4> > S_AXI_GP1_ARQOS;
  sc_core::sc_in< sc_dt::sc_bv<4> > S_AXI_GP1_AWCACHE;
  sc_core::sc_in< sc_dt::sc_bv<4> > S_AXI_GP1_AWLEN;
  sc_core::sc_in< sc_dt::sc_bv<4> > S_AXI_GP1_AWQOS;
  sc_core::sc_in< sc_dt::sc_bv<4> > S_AXI_GP1_WSTRB;
  sc_core::sc_in< sc_dt::sc_bv<6> > S_AXI_GP1_ARID;
  sc_core::sc_in< sc_dt::sc_bv<6> > S_AXI_GP1_AWID;
  sc_core::sc_in< sc_dt::sc_bv<6> > S_AXI_GP1_WID;
  sc_core::sc_out< bool > S_AXI_ACP_ARREADY;
  sc_core::sc_out< bool > S_AXI_ACP_AWREADY;
  sc_core::sc_out< bool > S_AXI_ACP_BVALID;
  sc_core::sc_out< bool > S_AXI_ACP_RLAST;
  sc_core::sc_out< bool > S_AXI_ACP_RVALID;
  sc_core::sc_out< bool > S_AXI_ACP_WREADY;
  sc_core::sc_out< sc_dt::sc_bv<2> > S_AXI_ACP_BRESP;
  sc_core::sc_out< sc_dt::sc_bv<2> > S_AXI_ACP_RRESP;
  sc_core::sc_out< sc_dt::sc_bv<3> > S_AXI_ACP_BID;
  sc_core::sc_out< sc_dt::sc_bv<3> > S_AXI_ACP_RID;
  sc_core::sc_out< sc_dt::sc_bv<64> > S_AXI_ACP_RDATA;
  sc_core::sc_in< bool > S_AXI_ACP_ACLK;
  sc_core::sc_in< bool > S_AXI_ACP_ARVALID;
  sc_core::sc_in< bool > S_AXI_ACP_AWVALID;
  sc_core::sc_in< bool > S_AXI_ACP_BREADY;
  sc_core::sc_in< bool > S_AXI_ACP_RREADY;
  sc_core::sc_in< bool > S_AXI_ACP_WLAST;
  sc_core::sc_in< bool > S_AXI_ACP_WVALID;
  sc_core::sc_in< sc_dt::sc_bv<3> > S_AXI_ACP_ARID;
  sc_core::sc_in< sc_dt::sc_bv<3> > S_AXI_ACP_ARPROT;
  sc_core::sc_in< sc_dt::sc_bv<3> > S_AXI_ACP_AWID;
  sc_core::sc_in< sc_dt::sc_bv<3> > S_AXI_ACP_AWPROT;
  sc_core::sc_in< sc_dt::sc_bv<3> > S_AXI_ACP_WID;
  sc_core::sc_in< sc_dt::sc_bv<32> > S_AXI_ACP_ARADDR;
  sc_core::sc_in< sc_dt::sc_bv<32> > S_AXI_ACP_AWADDR;
  sc_core::sc_in< sc_dt::sc_bv<4> > S_AXI_ACP_ARCACHE;
  sc_core::sc_in< sc_dt::sc_bv<4> > S_AXI_ACP_ARLEN;
  sc_core::sc_in< sc_dt::sc_bv<4> > S_AXI_ACP_ARQOS;
  sc_core::sc_in< sc_dt::sc_bv<4> > S_AXI_ACP_AWCACHE;
  sc_core::sc_in< sc_dt::sc_bv<4> > S_AXI_ACP_AWLEN;
  sc_core::sc_in< sc_dt::sc_bv<4> > S_AXI_ACP_AWQOS;
  sc_core::sc_in< sc_dt::sc_bv<2> > S_AXI_ACP_ARBURST;
  sc_core::sc_in< sc_dt::sc_bv<2> > S_AXI_ACP_ARLOCK;
  sc_core::sc_in< sc_dt::sc_bv<3> > S_AXI_ACP_ARSIZE;
  sc_core::sc_in< sc_dt::sc_bv<2> > S_AXI_ACP_AWBURST;
  sc_core::sc_in< sc_dt::sc_bv<2> > S_AXI_ACP_AWLOCK;
  sc_core::sc_in< sc_dt::sc_bv<3> > S_AXI_ACP_AWSIZE;
  sc_core::sc_in< sc_dt::sc_bv<5> > S_AXI_ACP_ARUSER;
  sc_core::sc_in< sc_dt::sc_bv<5> > S_AXI_ACP_AWUSER;
  sc_core::sc_in< sc_dt::sc_bv<64> > S_AXI_ACP_WDATA;
  sc_core::sc_in< sc_dt::sc_bv<8> > S_AXI_ACP_WSTRB;
  sc_core::sc_out< bool > S_AXI_HP0_ARREADY;
  sc_core::sc_out< bool > S_AXI_HP0_AWREADY;
  sc_core::sc_out< bool > S_AXI_HP0_BVALID;
  sc_core::sc_out< bool > S_AXI_HP0_RLAST;
  sc_core::sc_out< bool > S_AXI_HP0_RVALID;
  sc_core::sc_out< bool > S_AXI_HP0_WREADY;
  sc_core::sc_out< sc_dt::sc_bv<2> > S_AXI_HP0_BRESP;
  sc_core::sc_out< sc_dt::sc_bv<2> > S_AXI_HP0_RRESP;
  sc_core::sc_out< sc_dt::sc_bv<6> > S_AXI_HP0_BID;
  sc_core::sc_out< sc_dt::sc_bv<6> > S_AXI_HP0_RID;
  sc_core::sc_out< sc_dt::sc_bv<64> > S_AXI_HP0_RDATA;
  sc_core::sc_out< sc_dt::sc_bv<8> > S_AXI_HP0_RCOUNT;
  sc_core::sc_out< sc_dt::sc_bv<8> > S_AXI_HP0_WCOUNT;
  sc_core::sc_out< sc_dt::sc_bv<3> > S_AXI_HP0_RACOUNT;
  sc_core::sc_out< sc_dt::sc_bv<6> > S_AXI_HP0_WACOUNT;
  sc_core::sc_in< bool > S_AXI_HP0_ACLK;
  sc_core::sc_in< bool > S_AXI_HP0_ARVALID;
  sc_core::sc_in< bool > S_AXI_HP0_AWVALID;
  sc_core::sc_in< bool > S_AXI_HP0_BREADY;
  sc_core::sc_in< bool > S_AXI_HP0_RDISSUECAP1_EN;
  sc_core::sc_in< bool > S_AXI_HP0_RREADY;
  sc_core::sc_in< bool > S_AXI_HP0_WLAST;
  sc_core::sc_in< bool > S_AXI_HP0_WRISSUECAP1_EN;
  sc_core::sc_in< bool > S_AXI_HP0_WVALID;
  sc_core::sc_in< sc_dt::sc_bv<2> > S_AXI_HP0_ARBURST;
  sc_core::sc_in< sc_dt::sc_bv<2> > S_AXI_HP0_ARLOCK;
  sc_core::sc_in< sc_dt::sc_bv<3> > S_AXI_HP0_ARSIZE;
  sc_core::sc_in< sc_dt::sc_bv<2> > S_AXI_HP0_AWBURST;
  sc_core::sc_in< sc_dt::sc_bv<2> > S_AXI_HP0_AWLOCK;
  sc_core::sc_in< sc_dt::sc_bv<3> > S_AXI_HP0_AWSIZE;
  sc_core::sc_in< sc_dt::sc_bv<3> > S_AXI_HP0_ARPROT;
  sc_core::sc_in< sc_dt::sc_bv<3> > S_AXI_HP0_AWPROT;
  sc_core::sc_in< sc_dt::sc_bv<32> > S_AXI_HP0_ARADDR;
  sc_core::sc_in< sc_dt::sc_bv<32> > S_AXI_HP0_AWADDR;
  sc_core::sc_in< sc_dt::sc_bv<4> > S_AXI_HP0_ARCACHE;
  sc_core::sc_in< sc_dt::sc_bv<4> > S_AXI_HP0_ARLEN;
  sc_core::sc_in< sc_dt::sc_bv<4> > S_AXI_HP0_ARQOS;
  sc_core::sc_in< sc_dt::sc_bv<4> > S_AXI_HP0_AWCACHE;
  sc_core::sc_in< sc_dt::sc_bv<4> > S_AXI_HP0_AWLEN;
  sc_core::sc_in< sc_dt::sc_bv<4> > S_AXI_HP0_AWQOS;
  sc_core::sc_in< sc_dt::sc_bv<6> > S_AXI_HP0_ARID;
  sc_core::sc_in< sc_dt::sc_bv<6> > S_AXI_HP0_AWID;
  sc_core::sc_in< sc_dt::sc_bv<6> > S_AXI_HP0_WID;
  sc_core::sc_in< sc_dt::sc_bv<64> > S_AXI_HP0_WDATA;
  sc_core::sc_in< sc_dt::sc_bv<8> > S_AXI_HP0_WSTRB;
  sc_core::sc_out< bool > S_AXI_HP1_ARREADY;
  sc_core::sc_out< bool > S_AXI_HP1_AWREADY;
  sc_core::sc_out< bool > S_AXI_HP1_BVALID;
  sc_core::sc_out< bool > S_AXI_HP1_RLAST;
  sc_core::sc_out< bool > S_AXI_HP1_RVALID;
  sc_core::sc_out< bool > S_AXI_HP1_WREADY;
  sc_core::sc_out< sc_dt::sc_bv<2> > S_AXI_HP1_BRESP;
  sc_core::sc_out< sc_dt::sc_bv<2> > S_AXI_HP1_RRESP;
  sc_core::sc_out< sc_dt::sc_bv<6> > S_AXI_HP1_BID;
  sc_core::sc_out< sc_dt::sc_bv<6> > S_AXI_HP1_RID;
  sc_core::sc_out< sc_dt::sc_bv<64> > S_AXI_HP1_RDATA;
  sc_core::sc_out< sc_dt::sc_bv<8> > S_AXI_HP1_RCOUNT;
  sc_core::sc_out< sc_dt::sc_bv<8> > S_AXI_HP1_WCOUNT;
  sc_core::sc_out< sc_dt::sc_bv<3> > S_AXI_HP1_RACOUNT;
  sc_core::sc_out< sc_dt::sc_bv<6> > S_AXI_HP1_WACOUNT;
  sc_core::sc_in< bool > S_AXI_HP1_ACLK;
  sc_core::sc_in< bool > S_AXI_HP1_ARVALID;
  sc_core::sc_in< bool > S_AXI_HP1_AWVALID;
  sc_core::sc_in< bool > S_AXI_HP1_BREADY;
  sc_core::sc_in< bool > S_AXI_HP1_RDISSUECAP1_EN;
  sc_core::sc_in< bool > S_AXI_HP1_RREADY;
  sc_core::sc_in< bool > S_AXI_HP1_WLAST;
  sc_core::sc_in< bool > S_AXI_HP1_WRISSUECAP1_EN;
  sc_core::sc_in< bool > S_AXI_HP1_WVALID;
  sc_core::sc_in< sc_dt::sc_bv<2> > S_AXI_HP1_ARBURST;
  sc_core::sc_in< sc_dt::sc_bv<2> > S_AXI_HP1_ARLOCK;
  sc_core::sc_in< sc_dt::sc_bv<3> > S_AXI_HP1_ARSIZE;
  sc_core::sc_in< sc_dt::sc_bv<2> > S_AXI_HP1_AWBURST;
  sc_core::sc_in< sc_dt::sc_bv<2> > S_AXI_HP1_AWLOCK;
  sc_core::sc_in< sc_dt::sc_bv<3> > S_AXI_HP1_AWSIZE;
  sc_core::sc_in< sc_dt::sc_bv<3> > S_AXI_HP1_ARPROT;
  sc_core::sc_in< sc_dt::sc_bv<3> > S_AXI_HP1_AWPROT;
  sc_core::sc_in< sc_dt::sc_bv<32> > S_AXI_HP1_ARADDR;
  sc_core::sc_in< sc_dt::sc_bv<32> > S_AXI_HP1_AWADDR;
  sc_core::sc_in< sc_dt::sc_bv<4> > S_AXI_HP1_ARCACHE;
  sc_core::sc_in< sc_dt::sc_bv<4> > S_AXI_HP1_ARLEN;
  sc_core::sc_in< sc_dt::sc_bv<4> > S_AXI_HP1_ARQOS;
  sc_core::sc_in< sc_dt::sc_bv<4> > S_AXI_HP1_AWCACHE;
  sc_core::sc_in< sc_dt::sc_bv<4> > S_AXI_HP1_AWLEN;
  sc_core::sc_in< sc_dt::sc_bv<4> > S_AXI_HP1_AWQOS;
  sc_core::sc_in< sc_dt::sc_bv<6> > S_AXI_HP1_ARID;
  sc_core::sc_in< sc_dt::sc_bv<6> > S_AXI_HP1_AWID;
  sc_core::sc_in< sc_dt::sc_bv<6> > S_AXI_HP1_WID;
  sc_core::sc_in< sc_dt::sc_bv<64> > S_AXI_HP1_WDATA;
  sc_core::sc_in< sc_dt::sc_bv<8> > S_AXI_HP1_WSTRB;
  sc_core::sc_in< sc_dt::sc_bv<2> > IRQ_F2P;
  sc_core::sc_out< sc_dt::sc_bv<2> > DMA0_DATYPE;
  sc_core::sc_out< bool > DMA0_DAVALID;
  sc_core::sc_out< bool > DMA0_DRREADY;
  sc_core::sc_in< bool > DMA0_ACLK;
  sc_core::sc_in< bool > DMA0_DAREADY;
  sc_core::sc_in< bool > DMA0_DRLAST;
  sc_core::sc_in< bool > DMA0_DRVALID;
  sc_core::sc_in< sc_dt::sc_bv<2> > DMA0_DRTYPE;
  sc_core::sc_out< bool > FCLK_CLK0;
  sc_core::sc_out< bool > FCLK_CLK1;
  sc_core::sc_out< bool > FCLK_CLK2;
  sc_core::sc_out< bool > FCLK_CLK3;
  sc_core::sc_out< bool > FCLK_RESET0_N;
  sc_core::sc_out< bool > FCLK_RESET1_N;
  sc_core::sc_out< bool > FCLK_RESET2_N;
  sc_core::sc_out< bool > FCLK_RESET3_N;
  sc_core::sc_in< sc_dt::sc_bv<32> > FTMT_F2P_DEBUG;
  sc_core::sc_out< sc_dt::sc_bv<32> > FTMT_P2F_DEBUG;
  sc_core::sc_inout< sc_dt::sc_bv<54> > MIO;
  sc_core::sc_inout< bool > DDR_CAS_n;
  sc_core::sc_inout< bool > DDR_CKE;
  sc_core::sc_inout< bool > DDR_Clk_n;
  sc_core::sc_inout< bool > DDR_Clk;
  sc_core::sc_inout< bool > DDR_CS_n;
  sc_core::sc_inout< bool > DDR_DRSTB;
  sc_core::sc_inout< bool > DDR_ODT;
  sc_core::sc_inout< bool > DDR_RAS_n;
  sc_core::sc_inout< bool > DDR_WEB;
  sc_core::sc_inout< sc_dt::sc_bv<3> > DDR_BankAddr;
  sc_core::sc_inout< sc_dt::sc_bv<15> > DDR_Addr;
  sc_core::sc_inout< bool > DDR_VRN;
  sc_core::sc_inout< bool > DDR_VRP;
  sc_core::sc_inout< sc_dt::sc_bv<4> > DDR_DM;
  sc_core::sc_inout< sc_dt::sc_bv<32> > DDR_DQ;
  sc_core::sc_inout< sc_dt::sc_bv<4> > DDR_DQS_n;
  sc_core::sc_inout< sc_dt::sc_bv<4> > DDR_DQS;
  sc_core::sc_inout< bool > PS_SRSTB;
  sc_core::sc_inout< bool > PS_CLK;
  sc_core::sc_inout< bool > PS_PORB;

  // Dummy Signals for IP Ports


protected:

  virtual void before_end_of_elaboration();

private:

  xtlm::xaxis_pin2xtlm_t<1,2,1,1,1,1>* mp_DMA0_REQ_transactor;
  sc_signal< bool > m_DMA0_REQ_transactor_rst_signal;
  xtlm::xaxis_xtlm2pin_t<1,2,1,1,1,1>* mp_DMA0_ACK_transactor;
  sc_signal< bool > m_DMA0_ACK_transactor_rst_signal;
  xtlm::xaximm_xtlm2pin_t<32,32,12,1,1,1,1,1>* mp_M_AXI_GP0_transactor;
  xsc::common::scalar2vectorN_converter<2>* mp_M_AXI_GP0_ARLOCK_converter;
  sc_signal< bool > m_M_AXI_GP0_ARLOCK_converter_signal;
  xsc::common::scalar2vectorN_converter<2>* mp_M_AXI_GP0_AWLOCK_converter;
  sc_signal< bool > m_M_AXI_GP0_AWLOCK_converter_signal;
  xsc::common::vector2vector_converter<8,4>* mp_M_AXI_GP0_ARLEN_converter;
  sc_signal< sc_bv<8> > m_M_AXI_GP0_ARLEN_converter_signal;
  xsc::common::vector2vector_converter<8,4>* mp_M_AXI_GP0_AWLEN_converter;
  sc_signal< sc_bv<8> > m_M_AXI_GP0_AWLEN_converter_signal;
  sc_signal< bool > m_M_AXI_GP0_transactor_rst_signal;
  xtlm::xaximm_xtlm2pin_t<32,32,12,1,1,1,1,1>* mp_M_AXI_GP1_transactor;
  xsc::common::scalar2vectorN_converter<2>* mp_M_AXI_GP1_ARLOCK_converter;
  sc_signal< bool > m_M_AXI_GP1_ARLOCK_converter_signal;
  xsc::common::scalar2vectorN_converter<2>* mp_M_AXI_GP1_AWLOCK_converter;
  sc_signal< bool > m_M_AXI_GP1_AWLOCK_converter_signal;
  xsc::common::vector2vector_converter<8,4>* mp_M_AXI_GP1_ARLEN_converter;
  sc_signal< sc_bv<8> > m_M_AXI_GP1_ARLEN_converter_signal;
  xsc::common::vector2vector_converter<8,4>* mp_M_AXI_GP1_AWLEN_converter;
  sc_signal< sc_bv<8> > m_M_AXI_GP1_AWLEN_converter_signal;
  sc_signal< bool > m_M_AXI_GP1_transactor_rst_signal;
  xtlm::xaximm_pin2xtlm_t<64,32,3,5,1,1,5,1>* mp_S_AXI_ACP_transactor;
  xsc::common::vector2vector_converter<4,8>* mp_S_AXI_ACP_ARLEN_converter;
  sc_signal< sc_bv<8> > m_S_AXI_ACP_ARLEN_converter_signal;
  xsc::common::vector2vector_converter<4,8>* mp_S_AXI_ACP_AWLEN_converter;
  sc_signal< sc_bv<8> > m_S_AXI_ACP_AWLEN_converter_signal;
  xsc::common::vectorN2scalar_converter<2>* mp_S_AXI_ACP_ARLOCK_converter;
  sc_signal< bool > m_S_AXI_ACP_ARLOCK_converter_signal;
  xsc::common::vectorN2scalar_converter<2>* mp_S_AXI_ACP_AWLOCK_converter;
  sc_signal< bool > m_S_AXI_ACP_AWLOCK_converter_signal;
  sc_signal< bool > m_S_AXI_ACP_transactor_rst_signal;
  xtlm::xaximm_pin2xtlm_t<32,32,6,1,1,1,1,1>* mp_S_AXI_GP0_transactor;
  xsc::common::vectorN2scalar_converter<2>* mp_S_AXI_GP0_ARLOCK_converter;
  sc_signal< bool > m_S_AXI_GP0_ARLOCK_converter_signal;
  xsc::common::vectorN2scalar_converter<2>* mp_S_AXI_GP0_AWLOCK_converter;
  sc_signal< bool > m_S_AXI_GP0_AWLOCK_converter_signal;
  xsc::common::vector2vector_converter<4,8>* mp_S_AXI_GP0_ARLEN_converter;
  sc_signal< sc_bv<8> > m_S_AXI_GP0_ARLEN_converter_signal;
  xsc::common::vector2vector_converter<4,8>* mp_S_AXI_GP0_AWLEN_converter;
  sc_signal< sc_bv<8> > m_S_AXI_GP0_AWLEN_converter_signal;
  sc_signal< bool > m_S_AXI_GP0_transactor_rst_signal;
  xtlm::xaximm_pin2xtlm_t<32,32,6,1,1,1,1,1>* mp_S_AXI_GP1_transactor;
  xsc::common::vectorN2scalar_converter<2>* mp_S_AXI_GP1_ARLOCK_converter;
  sc_signal< bool > m_S_AXI_GP1_ARLOCK_converter_signal;
  xsc::common::vectorN2scalar_converter<2>* mp_S_AXI_GP1_AWLOCK_converter;
  sc_signal< bool > m_S_AXI_GP1_AWLOCK_converter_signal;
  xsc::common::vector2vector_converter<4,8>* mp_S_AXI_GP1_ARLEN_converter;
  sc_signal< sc_bv<8> > m_S_AXI_GP1_ARLEN_converter_signal;
  xsc::common::vector2vector_converter<4,8>* mp_S_AXI_GP1_AWLEN_converter;
  sc_signal< sc_bv<8> > m_S_AXI_GP1_AWLEN_converter_signal;
  sc_signal< bool > m_S_AXI_GP1_transactor_rst_signal;
  xtlm::xaximm_pin2xtlm_t<64,32,6,1,1,1,1,1>* mp_S_AXI_HP0_transactor;
  xsc::common::vectorN2scalar_converter<2>* mp_S_AXI_HP0_ARLOCK_converter;
  sc_signal< bool > m_S_AXI_HP0_ARLOCK_converter_signal;
  xsc::common::vectorN2scalar_converter<2>* mp_S_AXI_HP0_AWLOCK_converter;
  sc_signal< bool > m_S_AXI_HP0_AWLOCK_converter_signal;
  xsc::common::vector2vector_converter<4,8>* mp_S_AXI_HP0_ARLEN_converter;
  sc_signal< sc_bv<8> > m_S_AXI_HP0_ARLEN_converter_signal;
  xsc::common::vector2vector_converter<4,8>* mp_S_AXI_HP0_AWLEN_converter;
  sc_signal< sc_bv<8> > m_S_AXI_HP0_AWLEN_converter_signal;
  sc_signal< bool > m_S_AXI_HP0_transactor_rst_signal;
  xtlm::xaximm_pin2xtlm_t<64,32,6,1,1,1,1,1>* mp_S_AXI_HP1_transactor;
  xsc::common::vectorN2scalar_converter<2>* mp_S_AXI_HP1_ARLOCK_converter;
  sc_signal< bool > m_S_AXI_HP1_ARLOCK_converter_signal;
  xsc::common::vectorN2scalar_converter<2>* mp_S_AXI_HP1_AWLOCK_converter;
  sc_signal< bool > m_S_AXI_HP1_AWLOCK_converter_signal;
  xsc::common::vector2vector_converter<4,8>* mp_S_AXI_HP1_ARLEN_converter;
  sc_signal< sc_bv<8> > m_S_AXI_HP1_ARLEN_converter_signal;
  xsc::common::vector2vector_converter<4,8>* mp_S_AXI_HP1_AWLEN_converter;
  sc_signal< sc_bv<8> > m_S_AXI_HP1_AWLEN_converter_signal;
  sc_signal< bool > m_S_AXI_HP1_transactor_rst_signal;

};
#endif // XM_SYSTEMC




#ifdef RIVIERA
class DllExport design_1_processing_system7_0_0 : public design_1_processing_system7_0_0_sc
{
public:

  design_1_processing_system7_0_0(const sc_core::sc_module_name& nm);
  virtual ~design_1_processing_system7_0_0();

  // module pin-to-pin RTL interface

  sc_core::sc_out< bool > CAN0_PHY_TX;
  sc_core::sc_in< bool > CAN0_PHY_RX;
  sc_core::sc_in< bool > PJTAG_TCK;
  sc_core::sc_in< bool > PJTAG_TMS;
  sc_core::sc_in< bool > PJTAG_TDI;
  sc_core::sc_out< bool > PJTAG_TDO;
  sc_core::sc_in< bool > SPI0_SCLK_I;
  sc_core::sc_out< bool > SPI0_SCLK_O;
  sc_core::sc_out< bool > SPI0_SCLK_T;
  sc_core::sc_in< bool > SPI0_MOSI_I;
  sc_core::sc_out< bool > SPI0_MOSI_O;
  sc_core::sc_out< bool > SPI0_MOSI_T;
  sc_core::sc_in< bool > SPI0_MISO_I;
  sc_core::sc_out< bool > SPI0_MISO_O;
  sc_core::sc_out< bool > SPI0_MISO_T;
  sc_core::sc_in< bool > SPI0_SS_I;
  sc_core::sc_out< bool > SPI0_SS_O;
  sc_core::sc_out< bool > SPI0_SS1_O;
  sc_core::sc_out< bool > SPI0_SS2_O;
  sc_core::sc_out< bool > SPI0_SS_T;
  sc_core::sc_out< bool > TTC0_WAVE0_OUT;
  sc_core::sc_out< bool > TTC0_WAVE1_OUT;
  sc_core::sc_out< bool > TTC0_WAVE2_OUT;
  sc_core::sc_out< sc_dt::sc_bv<2> > USB0_PORT_INDCTL;
  sc_core::sc_out< bool > USB0_VBUS_PWRSELECT;
  sc_core::sc_in< bool > USB0_VBUS_PWRFAULT;
  sc_core::sc_out< bool > M_AXI_GP0_ARVALID;
  sc_core::sc_out< bool > M_AXI_GP0_AWVALID;
  sc_core::sc_out< bool > M_AXI_GP0_BREADY;
  sc_core::sc_out< bool > M_AXI_GP0_RREADY;
  sc_core::sc_out< bool > M_AXI_GP0_WLAST;
  sc_core::sc_out< bool > M_AXI_GP0_WVALID;
  sc_core::sc_out< sc_dt::sc_bv<12> > M_AXI_GP0_ARID;
  sc_core::sc_out< sc_dt::sc_bv<12> > M_AXI_GP0_AWID;
  sc_core::sc_out< sc_dt::sc_bv<12> > M_AXI_GP0_WID;
  sc_core::sc_out< sc_dt::sc_bv<2> > M_AXI_GP0_ARBURST;
  sc_core::sc_out< sc_dt::sc_bv<2> > M_AXI_GP0_ARLOCK;
  sc_core::sc_out< sc_dt::sc_bv<3> > M_AXI_GP0_ARSIZE;
  sc_core::sc_out< sc_dt::sc_bv<2> > M_AXI_GP0_AWBURST;
  sc_core::sc_out< sc_dt::sc_bv<2> > M_AXI_GP0_AWLOCK;
  sc_core::sc_out< sc_dt::sc_bv<3> > M_AXI_GP0_AWSIZE;
  sc_core::sc_out< sc_dt::sc_bv<3> > M_AXI_GP0_ARPROT;
  sc_core::sc_out< sc_dt::sc_bv<3> > M_AXI_GP0_AWPROT;
  sc_core::sc_out< sc_dt::sc_bv<32> > M_AXI_GP0_ARADDR;
  sc_core::sc_out< sc_dt::sc_bv<32> > M_AXI_GP0_AWADDR;
  sc_core::sc_out< sc_dt::sc_bv<32> > M_AXI_GP0_WDATA;
  sc_core::sc_out< sc_dt::sc_bv<4> > M_AXI_GP0_ARCACHE;
  sc_core::sc_out< sc_dt::sc_bv<4> > M_AXI_GP0_ARLEN;
  sc_core::sc_out< sc_dt::sc_bv<4> > M_AXI_GP0_ARQOS;
  sc_core::sc_out< sc_dt::sc_bv<4> > M_AXI_GP0_AWCACHE;
  sc_core::sc_out< sc_dt::sc_bv<4> > M_AXI_GP0_AWLEN;
  sc_core::sc_out< sc_dt::sc_bv<4> > M_AXI_GP0_AWQOS;
  sc_core::sc_out< sc_dt::sc_bv<4> > M_AXI_GP0_WSTRB;
  sc_core::sc_in< bool > M_AXI_GP0_ACLK;
  sc_core::sc_in< bool > M_AXI_GP0_ARREADY;
  sc_core::sc_in< bool > M_AXI_GP0_AWREADY;
  sc_core::sc_in< bool > M_AXI_GP0_BVALID;
  sc_core::sc_in< bool > M_AXI_GP0_RLAST;
  sc_core::sc_in< bool > M_AXI_GP0_RVALID;
  sc_core::sc_in< bool > M_AXI_GP0_WREADY;
  sc_core::sc_in< sc_dt::sc_bv<12> > M_AXI_GP0_BID;
  sc_core::sc_in< sc_dt::sc_bv<12> > M_AXI_GP0_RID;
  sc_core::sc_in< sc_dt::sc_bv<2> > M_AXI_GP0_BRESP;
  sc_core::sc_in< sc_dt::sc_bv<2> > M_AXI_GP0_RRESP;
  sc_core::sc_in< sc_dt::sc_bv<32> > M_AXI_GP0_RDATA;
  sc_core::sc_out< bool > M_AXI_GP1_ARVALID;
  sc_core::sc_out< bool > M_AXI_GP1_AWVALID;
  sc_core::sc_out< bool > M_AXI_GP1_BREADY;
  sc_core::sc_out< bool > M_AXI_GP1_RREADY;
  sc_core::sc_out< bool > M_AXI_GP1_WLAST;
  sc_core::sc_out< bool > M_AXI_GP1_WVALID;
  sc_core::sc_out< sc_dt::sc_bv<12> > M_AXI_GP1_ARID;
  sc_core::sc_out< sc_dt::sc_bv<12> > M_AXI_GP1_AWID;
  sc_core::sc_out< sc_dt::sc_bv<12> > M_AXI_GP1_WID;
  sc_core::sc_out< sc_dt::sc_bv<2> > M_AXI_GP1_ARBURST;
  sc_core::sc_out< sc_dt::sc_bv<2> > M_AXI_GP1_ARLOCK;
  sc_core::sc_out< sc_dt::sc_bv<3> > M_AXI_GP1_ARSIZE;
  sc_core::sc_out< sc_dt::sc_bv<2> > M_AXI_GP1_AWBURST;
  sc_core::sc_out< sc_dt::sc_bv<2> > M_AXI_GP1_AWLOCK;
  sc_core::sc_out< sc_dt::sc_bv<3> > M_AXI_GP1_AWSIZE;
  sc_core::sc_out< sc_dt::sc_bv<3> > M_AXI_GP1_ARPROT;
  sc_core::sc_out< sc_dt::sc_bv<3> > M_AXI_GP1_AWPROT;
  sc_core::sc_out< sc_dt::sc_bv<32> > M_AXI_GP1_ARADDR;
  sc_core::sc_out< sc_dt::sc_bv<32> > M_AXI_GP1_AWADDR;
  sc_core::sc_out< sc_dt::sc_bv<32> > M_AXI_GP1_WDATA;
  sc_core::sc_out< sc_dt::sc_bv<4> > M_AXI_GP1_ARCACHE;
  sc_core::sc_out< sc_dt::sc_bv<4> > M_AXI_GP1_ARLEN;
  sc_core::sc_out< sc_dt::sc_bv<4> > M_AXI_GP1_ARQOS;
  sc_core::sc_out< sc_dt::sc_bv<4> > M_AXI_GP1_AWCACHE;
  sc_core::sc_out< sc_dt::sc_bv<4> > M_AXI_GP1_AWLEN;
  sc_core::sc_out< sc_dt::sc_bv<4> > M_AXI_GP1_AWQOS;
  sc_core::sc_out< sc_dt::sc_bv<4> > M_AXI_GP1_WSTRB;
  sc_core::sc_in< bool > M_AXI_GP1_ACLK;
  sc_core::sc_in< bool > M_AXI_GP1_ARREADY;
  sc_core::sc_in< bool > M_AXI_GP1_AWREADY;
  sc_core::sc_in< bool > M_AXI_GP1_BVALID;
  sc_core::sc_in< bool > M_AXI_GP1_RLAST;
  sc_core::sc_in< bool > M_AXI_GP1_RVALID;
  sc_core::sc_in< bool > M_AXI_GP1_WREADY;
  sc_core::sc_in< sc_dt::sc_bv<12> > M_AXI_GP1_BID;
  sc_core::sc_in< sc_dt::sc_bv<12> > M_AXI_GP1_RID;
  sc_core::sc_in< sc_dt::sc_bv<2> > M_AXI_GP1_BRESP;
  sc_core::sc_in< sc_dt::sc_bv<2> > M_AXI_GP1_RRESP;
  sc_core::sc_in< sc_dt::sc_bv<32> > M_AXI_GP1_RDATA;
  sc_core::sc_out< bool > S_AXI_GP0_ARREADY;
  sc_core::sc_out< bool > S_AXI_GP0_AWREADY;
  sc_core::sc_out< bool > S_AXI_GP0_BVALID;
  sc_core::sc_out< bool > S_AXI_GP0_RLAST;
  sc_core::sc_out< bool > S_AXI_GP0_RVALID;
  sc_core::sc_out< bool > S_AXI_GP0_WREADY;
  sc_core::sc_out< sc_dt::sc_bv<2> > S_AXI_GP0_BRESP;
  sc_core::sc_out< sc_dt::sc_bv<2> > S_AXI_GP0_RRESP;
  sc_core::sc_out< sc_dt::sc_bv<32> > S_AXI_GP0_RDATA;
  sc_core::sc_out< sc_dt::sc_bv<6> > S_AXI_GP0_BID;
  sc_core::sc_out< sc_dt::sc_bv<6> > S_AXI_GP0_RID;
  sc_core::sc_in< bool > S_AXI_GP0_ACLK;
  sc_core::sc_in< bool > S_AXI_GP0_ARVALID;
  sc_core::sc_in< bool > S_AXI_GP0_AWVALID;
  sc_core::sc_in< bool > S_AXI_GP0_BREADY;
  sc_core::sc_in< bool > S_AXI_GP0_RREADY;
  sc_core::sc_in< bool > S_AXI_GP0_WLAST;
  sc_core::sc_in< bool > S_AXI_GP0_WVALID;
  sc_core::sc_in< sc_dt::sc_bv<2> > S_AXI_GP0_ARBURST;
  sc_core::sc_in< sc_dt::sc_bv<2> > S_AXI_GP0_ARLOCK;
  sc_core::sc_in< sc_dt::sc_bv<3> > S_AXI_GP0_ARSIZE;
  sc_core::sc_in< sc_dt::sc_bv<2> > S_AXI_GP0_AWBURST;
  sc_core::sc_in< sc_dt::sc_bv<2> > S_AXI_GP0_AWLOCK;
  sc_core::sc_in< sc_dt::sc_bv<3> > S_AXI_GP0_AWSIZE;
  sc_core::sc_in< sc_dt::sc_bv<3> > S_AXI_GP0_ARPROT;
  sc_core::sc_in< sc_dt::sc_bv<3> > S_AXI_GP0_AWPROT;
  sc_core::sc_in< sc_dt::sc_bv<32> > S_AXI_GP0_ARADDR;
  sc_core::sc_in< sc_dt::sc_bv<32> > S_AXI_GP0_AWADDR;
  sc_core::sc_in< sc_dt::sc_bv<32> > S_AXI_GP0_WDATA;
  sc_core::sc_in< sc_dt::sc_bv<4> > S_AXI_GP0_ARCACHE;
  sc_core::sc_in< sc_dt::sc_bv<4> > S_AXI_GP0_ARLEN;
  sc_core::sc_in< sc_dt::sc_bv<4> > S_AXI_GP0_ARQOS;
  sc_core::sc_in< sc_dt::sc_bv<4> > S_AXI_GP0_AWCACHE;
  sc_core::sc_in< sc_dt::sc_bv<4> > S_AXI_GP0_AWLEN;
  sc_core::sc_in< sc_dt::sc_bv<4> > S_AXI_GP0_AWQOS;
  sc_core::sc_in< sc_dt::sc_bv<4> > S_AXI_GP0_WSTRB;
  sc_core::sc_in< sc_dt::sc_bv<6> > S_AXI_GP0_ARID;
  sc_core::sc_in< sc_dt::sc_bv<6> > S_AXI_GP0_AWID;
  sc_core::sc_in< sc_dt::sc_bv<6> > S_AXI_GP0_WID;
  sc_core::sc_out< bool > S_AXI_GP1_ARREADY;
  sc_core::sc_out< bool > S_AXI_GP1_AWREADY;
  sc_core::sc_out< bool > S_AXI_GP1_BVALID;
  sc_core::sc_out< bool > S_AXI_GP1_RLAST;
  sc_core::sc_out< bool > S_AXI_GP1_RVALID;
  sc_core::sc_out< bool > S_AXI_GP1_WREADY;
  sc_core::sc_out< sc_dt::sc_bv<2> > S_AXI_GP1_BRESP;
  sc_core::sc_out< sc_dt::sc_bv<2> > S_AXI_GP1_RRESP;
  sc_core::sc_out< sc_dt::sc_bv<32> > S_AXI_GP1_RDATA;
  sc_core::sc_out< sc_dt::sc_bv<6> > S_AXI_GP1_BID;
  sc_core::sc_out< sc_dt::sc_bv<6> > S_AXI_GP1_RID;
  sc_core::sc_in< bool > S_AXI_GP1_ACLK;
  sc_core::sc_in< bool > S_AXI_GP1_ARVALID;
  sc_core::sc_in< bool > S_AXI_GP1_AWVALID;
  sc_core::sc_in< bool > S_AXI_GP1_BREADY;
  sc_core::sc_in< bool > S_AXI_GP1_RREADY;
  sc_core::sc_in< bool > S_AXI_GP1_WLAST;
  sc_core::sc_in< bool > S_AXI_GP1_WVALID;
  sc_core::sc_in< sc_dt::sc_bv<2> > S_AXI_GP1_ARBURST;
  sc_core::sc_in< sc_dt::sc_bv<2> > S_AXI_GP1_ARLOCK;
  sc_core::sc_in< sc_dt::sc_bv<3> > S_AXI_GP1_ARSIZE;
  sc_core::sc_in< sc_dt::sc_bv<2> > S_AXI_GP1_AWBURST;
  sc_core::sc_in< sc_dt::sc_bv<2> > S_AXI_GP1_AWLOCK;
  sc_core::sc_in< sc_dt::sc_bv<3> > S_AXI_GP1_AWSIZE;
  sc_core::sc_in< sc_dt::sc_bv<3> > S_AXI_GP1_ARPROT;
  sc_core::sc_in< sc_dt::sc_bv<3> > S_AXI_GP1_AWPROT;
  sc_core::sc_in< sc_dt::sc_bv<32> > S_AXI_GP1_ARADDR;
  sc_core::sc_in< sc_dt::sc_bv<32> > S_AXI_GP1_AWADDR;
  sc_core::sc_in< sc_dt::sc_bv<32> > S_AXI_GP1_WDATA;
  sc_core::sc_in< sc_dt::sc_bv<4> > S_AXI_GP1_ARCACHE;
  sc_core::sc_in< sc_dt::sc_bv<4> > S_AXI_GP1_ARLEN;
  sc_core::sc_in< sc_dt::sc_bv<4> > S_AXI_GP1_ARQOS;
  sc_core::sc_in< sc_dt::sc_bv<4> > S_AXI_GP1_AWCACHE;
  sc_core::sc_in< sc_dt::sc_bv<4> > S_AXI_GP1_AWLEN;
  sc_core::sc_in< sc_dt::sc_bv<4> > S_AXI_GP1_AWQOS;
  sc_core::sc_in< sc_dt::sc_bv<4> > S_AXI_GP1_WSTRB;
  sc_core::sc_in< sc_dt::sc_bv<6> > S_AXI_GP1_ARID;
  sc_core::sc_in< sc_dt::sc_bv<6> > S_AXI_GP1_AWID;
  sc_core::sc_in< sc_dt::sc_bv<6> > S_AXI_GP1_WID;
  sc_core::sc_out< bool > S_AXI_ACP_ARREADY;
  sc_core::sc_out< bool > S_AXI_ACP_AWREADY;
  sc_core::sc_out< bool > S_AXI_ACP_BVALID;
  sc_core::sc_out< bool > S_AXI_ACP_RLAST;
  sc_core::sc_out< bool > S_AXI_ACP_RVALID;
  sc_core::sc_out< bool > S_AXI_ACP_WREADY;
  sc_core::sc_out< sc_dt::sc_bv<2> > S_AXI_ACP_BRESP;
  sc_core::sc_out< sc_dt::sc_bv<2> > S_AXI_ACP_RRESP;
  sc_core::sc_out< sc_dt::sc_bv<3> > S_AXI_ACP_BID;
  sc_core::sc_out< sc_dt::sc_bv<3> > S_AXI_ACP_RID;
  sc_core::sc_out< sc_dt::sc_bv<64> > S_AXI_ACP_RDATA;
  sc_core::sc_in< bool > S_AXI_ACP_ACLK;
  sc_core::sc_in< bool > S_AXI_ACP_ARVALID;
  sc_core::sc_in< bool > S_AXI_ACP_AWVALID;
  sc_core::sc_in< bool > S_AXI_ACP_BREADY;
  sc_core::sc_in< bool > S_AXI_ACP_RREADY;
  sc_core::sc_in< bool > S_AXI_ACP_WLAST;
  sc_core::sc_in< bool > S_AXI_ACP_WVALID;
  sc_core::sc_in< sc_dt::sc_bv<3> > S_AXI_ACP_ARID;
  sc_core::sc_in< sc_dt::sc_bv<3> > S_AXI_ACP_ARPROT;
  sc_core::sc_in< sc_dt::sc_bv<3> > S_AXI_ACP_AWID;
  sc_core::sc_in< sc_dt::sc_bv<3> > S_AXI_ACP_AWPROT;
  sc_core::sc_in< sc_dt::sc_bv<3> > S_AXI_ACP_WID;
  sc_core::sc_in< sc_dt::sc_bv<32> > S_AXI_ACP_ARADDR;
  sc_core::sc_in< sc_dt::sc_bv<32> > S_AXI_ACP_AWADDR;
  sc_core::sc_in< sc_dt::sc_bv<4> > S_AXI_ACP_ARCACHE;
  sc_core::sc_in< sc_dt::sc_bv<4> > S_AXI_ACP_ARLEN;
  sc_core::sc_in< sc_dt::sc_bv<4> > S_AXI_ACP_ARQOS;
  sc_core::sc_in< sc_dt::sc_bv<4> > S_AXI_ACP_AWCACHE;
  sc_core::sc_in< sc_dt::sc_bv<4> > S_AXI_ACP_AWLEN;
  sc_core::sc_in< sc_dt::sc_bv<4> > S_AXI_ACP_AWQOS;
  sc_core::sc_in< sc_dt::sc_bv<2> > S_AXI_ACP_ARBURST;
  sc_core::sc_in< sc_dt::sc_bv<2> > S_AXI_ACP_ARLOCK;
  sc_core::sc_in< sc_dt::sc_bv<3> > S_AXI_ACP_ARSIZE;
  sc_core::sc_in< sc_dt::sc_bv<2> > S_AXI_ACP_AWBURST;
  sc_core::sc_in< sc_dt::sc_bv<2> > S_AXI_ACP_AWLOCK;
  sc_core::sc_in< sc_dt::sc_bv<3> > S_AXI_ACP_AWSIZE;
  sc_core::sc_in< sc_dt::sc_bv<5> > S_AXI_ACP_ARUSER;
  sc_core::sc_in< sc_dt::sc_bv<5> > S_AXI_ACP_AWUSER;
  sc_core::sc_in< sc_dt::sc_bv<64> > S_AXI_ACP_WDATA;
  sc_core::sc_in< sc_dt::sc_bv<8> > S_AXI_ACP_WSTRB;
  sc_core::sc_out< bool > S_AXI_HP0_ARREADY;
  sc_core::sc_out< bool > S_AXI_HP0_AWREADY;
  sc_core::sc_out< bool > S_AXI_HP0_BVALID;
  sc_core::sc_out< bool > S_AXI_HP0_RLAST;
  sc_core::sc_out< bool > S_AXI_HP0_RVALID;
  sc_core::sc_out< bool > S_AXI_HP0_WREADY;
  sc_core::sc_out< sc_dt::sc_bv<2> > S_AXI_HP0_BRESP;
  sc_core::sc_out< sc_dt::sc_bv<2> > S_AXI_HP0_RRESP;
  sc_core::sc_out< sc_dt::sc_bv<6> > S_AXI_HP0_BID;
  sc_core::sc_out< sc_dt::sc_bv<6> > S_AXI_HP0_RID;
  sc_core::sc_out< sc_dt::sc_bv<64> > S_AXI_HP0_RDATA;
  sc_core::sc_out< sc_dt::sc_bv<8> > S_AXI_HP0_RCOUNT;
  sc_core::sc_out< sc_dt::sc_bv<8> > S_AXI_HP0_WCOUNT;
  sc_core::sc_out< sc_dt::sc_bv<3> > S_AXI_HP0_RACOUNT;
  sc_core::sc_out< sc_dt::sc_bv<6> > S_AXI_HP0_WACOUNT;
  sc_core::sc_in< bool > S_AXI_HP0_ACLK;
  sc_core::sc_in< bool > S_AXI_HP0_ARVALID;
  sc_core::sc_in< bool > S_AXI_HP0_AWVALID;
  sc_core::sc_in< bool > S_AXI_HP0_BREADY;
  sc_core::sc_in< bool > S_AXI_HP0_RDISSUECAP1_EN;
  sc_core::sc_in< bool > S_AXI_HP0_RREADY;
  sc_core::sc_in< bool > S_AXI_HP0_WLAST;
  sc_core::sc_in< bool > S_AXI_HP0_WRISSUECAP1_EN;
  sc_core::sc_in< bool > S_AXI_HP0_WVALID;
  sc_core::sc_in< sc_dt::sc_bv<2> > S_AXI_HP0_ARBURST;
  sc_core::sc_in< sc_dt::sc_bv<2> > S_AXI_HP0_ARLOCK;
  sc_core::sc_in< sc_dt::sc_bv<3> > S_AXI_HP0_ARSIZE;
  sc_core::sc_in< sc_dt::sc_bv<2> > S_AXI_HP0_AWBURST;
  sc_core::sc_in< sc_dt::sc_bv<2> > S_AXI_HP0_AWLOCK;
  sc_core::sc_in< sc_dt::sc_bv<3> > S_AXI_HP0_AWSIZE;
  sc_core::sc_in< sc_dt::sc_bv<3> > S_AXI_HP0_ARPROT;
  sc_core::sc_in< sc_dt::sc_bv<3> > S_AXI_HP0_AWPROT;
  sc_core::sc_in< sc_dt::sc_bv<32> > S_AXI_HP0_ARADDR;
  sc_core::sc_in< sc_dt::sc_bv<32> > S_AXI_HP0_AWADDR;
  sc_core::sc_in< sc_dt::sc_bv<4> > S_AXI_HP0_ARCACHE;
  sc_core::sc_in< sc_dt::sc_bv<4> > S_AXI_HP0_ARLEN;
  sc_core::sc_in< sc_dt::sc_bv<4> > S_AXI_HP0_ARQOS;
  sc_core::sc_in< sc_dt::sc_bv<4> > S_AXI_HP0_AWCACHE;
  sc_core::sc_in< sc_dt::sc_bv<4> > S_AXI_HP0_AWLEN;
  sc_core::sc_in< sc_dt::sc_bv<4> > S_AXI_HP0_AWQOS;
  sc_core::sc_in< sc_dt::sc_bv<6> > S_AXI_HP0_ARID;
  sc_core::sc_in< sc_dt::sc_bv<6> > S_AXI_HP0_AWID;
  sc_core::sc_in< sc_dt::sc_bv<6> > S_AXI_HP0_WID;
  sc_core::sc_in< sc_dt::sc_bv<64> > S_AXI_HP0_WDATA;
  sc_core::sc_in< sc_dt::sc_bv<8> > S_AXI_HP0_WSTRB;
  sc_core::sc_out< bool > S_AXI_HP1_ARREADY;
  sc_core::sc_out< bool > S_AXI_HP1_AWREADY;
  sc_core::sc_out< bool > S_AXI_HP1_BVALID;
  sc_core::sc_out< bool > S_AXI_HP1_RLAST;
  sc_core::sc_out< bool > S_AXI_HP1_RVALID;
  sc_core::sc_out< bool > S_AXI_HP1_WREADY;
  sc_core::sc_out< sc_dt::sc_bv<2> > S_AXI_HP1_BRESP;
  sc_core::sc_out< sc_dt::sc_bv<2> > S_AXI_HP1_RRESP;
  sc_core::sc_out< sc_dt::sc_bv<6> > S_AXI_HP1_BID;
  sc_core::sc_out< sc_dt::sc_bv<6> > S_AXI_HP1_RID;
  sc_core::sc_out< sc_dt::sc_bv<64> > S_AXI_HP1_RDATA;
  sc_core::sc_out< sc_dt::sc_bv<8> > S_AXI_HP1_RCOUNT;
  sc_core::sc_out< sc_dt::sc_bv<8> > S_AXI_HP1_WCOUNT;
  sc_core::sc_out< sc_dt::sc_bv<3> > S_AXI_HP1_RACOUNT;
  sc_core::sc_out< sc_dt::sc_bv<6> > S_AXI_HP1_WACOUNT;
  sc_core::sc_in< bool > S_AXI_HP1_ACLK;
  sc_core::sc_in< bool > S_AXI_HP1_ARVALID;
  sc_core::sc_in< bool > S_AXI_HP1_AWVALID;
  sc_core::sc_in< bool > S_AXI_HP1_BREADY;
  sc_core::sc_in< bool > S_AXI_HP1_RDISSUECAP1_EN;
  sc_core::sc_in< bool > S_AXI_HP1_RREADY;
  sc_core::sc_in< bool > S_AXI_HP1_WLAST;
  sc_core::sc_in< bool > S_AXI_HP1_WRISSUECAP1_EN;
  sc_core::sc_in< bool > S_AXI_HP1_WVALID;
  sc_core::sc_in< sc_dt::sc_bv<2> > S_AXI_HP1_ARBURST;
  sc_core::sc_in< sc_dt::sc_bv<2> > S_AXI_HP1_ARLOCK;
  sc_core::sc_in< sc_dt::sc_bv<3> > S_AXI_HP1_ARSIZE;
  sc_core::sc_in< sc_dt::sc_bv<2> > S_AXI_HP1_AWBURST;
  sc_core::sc_in< sc_dt::sc_bv<2> > S_AXI_HP1_AWLOCK;
  sc_core::sc_in< sc_dt::sc_bv<3> > S_AXI_HP1_AWSIZE;
  sc_core::sc_in< sc_dt::sc_bv<3> > S_AXI_HP1_ARPROT;
  sc_core::sc_in< sc_dt::sc_bv<3> > S_AXI_HP1_AWPROT;
  sc_core::sc_in< sc_dt::sc_bv<32> > S_AXI_HP1_ARADDR;
  sc_core::sc_in< sc_dt::sc_bv<32> > S_AXI_HP1_AWADDR;
  sc_core::sc_in< sc_dt::sc_bv<4> > S_AXI_HP1_ARCACHE;
  sc_core::sc_in< sc_dt::sc_bv<4> > S_AXI_HP1_ARLEN;
  sc_core::sc_in< sc_dt::sc_bv<4> > S_AXI_HP1_ARQOS;
  sc_core::sc_in< sc_dt::sc_bv<4> > S_AXI_HP1_AWCACHE;
  sc_core::sc_in< sc_dt::sc_bv<4> > S_AXI_HP1_AWLEN;
  sc_core::sc_in< sc_dt::sc_bv<4> > S_AXI_HP1_AWQOS;
  sc_core::sc_in< sc_dt::sc_bv<6> > S_AXI_HP1_ARID;
  sc_core::sc_in< sc_dt::sc_bv<6> > S_AXI_HP1_AWID;
  sc_core::sc_in< sc_dt::sc_bv<6> > S_AXI_HP1_WID;
  sc_core::sc_in< sc_dt::sc_bv<64> > S_AXI_HP1_WDATA;
  sc_core::sc_in< sc_dt::sc_bv<8> > S_AXI_HP1_WSTRB;
  sc_core::sc_in< sc_dt::sc_bv<2> > IRQ_F2P;
  sc_core::sc_out< sc_dt::sc_bv<2> > DMA0_DATYPE;
  sc_core::sc_out< bool > DMA0_DAVALID;
  sc_core::sc_out< bool > DMA0_DRREADY;
  sc_core::sc_in< bool > DMA0_ACLK;
  sc_core::sc_in< bool > DMA0_DAREADY;
  sc_core::sc_in< bool > DMA0_DRLAST;
  sc_core::sc_in< bool > DMA0_DRVALID;
  sc_core::sc_in< sc_dt::sc_bv<2> > DMA0_DRTYPE;
  sc_core::sc_out< bool > FCLK_CLK0;
  sc_core::sc_out< bool > FCLK_CLK1;
  sc_core::sc_out< bool > FCLK_CLK2;
  sc_core::sc_out< bool > FCLK_CLK3;
  sc_core::sc_out< bool > FCLK_RESET0_N;
  sc_core::sc_out< bool > FCLK_RESET1_N;
  sc_core::sc_out< bool > FCLK_RESET2_N;
  sc_core::sc_out< bool > FCLK_RESET3_N;
  sc_core::sc_in< sc_dt::sc_bv<32> > FTMT_F2P_DEBUG;
  sc_core::sc_out< sc_dt::sc_bv<32> > FTMT_P2F_DEBUG;
  sc_core::sc_out< sc_dt::sc_bv<54> > MIO;
  sc_core::sc_out< bool > DDR_CAS_n;
  sc_core::sc_out< bool > DDR_CKE;
  sc_core::sc_out< bool > DDR_Clk_n;
  sc_core::sc_out< bool > DDR_Clk;
  sc_core::sc_out< bool > DDR_CS_n;
  sc_core::sc_out< bool > DDR_DRSTB;
  sc_core::sc_out< bool > DDR_ODT;
  sc_core::sc_out< bool > DDR_RAS_n;
  sc_core::sc_out< bool > DDR_WEB;
  sc_core::sc_out< sc_dt::sc_bv<3> > DDR_BankAddr;
  sc_core::sc_out< sc_dt::sc_bv<15> > DDR_Addr;
  sc_core::sc_out< bool > DDR_VRN;
  sc_core::sc_out< bool > DDR_VRP;
  sc_core::sc_out< sc_dt::sc_bv<4> > DDR_DM;
  sc_core::sc_out< sc_dt::sc_bv<32> > DDR_DQ;
  sc_core::sc_out< sc_dt::sc_bv<4> > DDR_DQS_n;
  sc_core::sc_out< sc_dt::sc_bv<4> > DDR_DQS;
  sc_core::sc_out< bool > PS_SRSTB;
  sc_core::sc_out< bool > PS_CLK;
  sc_core::sc_out< bool > PS_PORB;

  // Dummy Signals for IP Ports


protected:

  virtual void before_end_of_elaboration();

private:

  xtlm::xaxis_pin2xtlm_t<1,2,1,1,1,1>* mp_DMA0_REQ_transactor;
  sc_signal< bool > m_DMA0_REQ_transactor_rst_signal;
  xtlm::xaxis_xtlm2pin_t<1,2,1,1,1,1>* mp_DMA0_ACK_transactor;
  sc_signal< bool > m_DMA0_ACK_transactor_rst_signal;
  xtlm::xaximm_xtlm2pin_t<32,32,12,1,1,1,1,1>* mp_M_AXI_GP0_transactor;
  xsc::common::scalar2vectorN_converter<2>* mp_M_AXI_GP0_ARLOCK_converter;
  sc_signal< bool > m_M_AXI_GP0_ARLOCK_converter_signal;
  xsc::common::scalar2vectorN_converter<2>* mp_M_AXI_GP0_AWLOCK_converter;
  sc_signal< bool > m_M_AXI_GP0_AWLOCK_converter_signal;
  xsc::common::vector2vector_converter<8,4>* mp_M_AXI_GP0_ARLEN_converter;
  sc_signal< sc_bv<8> > m_M_AXI_GP0_ARLEN_converter_signal;
  xsc::common::vector2vector_converter<8,4>* mp_M_AXI_GP0_AWLEN_converter;
  sc_signal< sc_bv<8> > m_M_AXI_GP0_AWLEN_converter_signal;
  sc_signal< bool > m_M_AXI_GP0_transactor_rst_signal;
  xtlm::xaximm_xtlm2pin_t<32,32,12,1,1,1,1,1>* mp_M_AXI_GP1_transactor;
  xsc::common::scalar2vectorN_converter<2>* mp_M_AXI_GP1_ARLOCK_converter;
  sc_signal< bool > m_M_AXI_GP1_ARLOCK_converter_signal;
  xsc::common::scalar2vectorN_converter<2>* mp_M_AXI_GP1_AWLOCK_converter;
  sc_signal< bool > m_M_AXI_GP1_AWLOCK_converter_signal;
  xsc::common::vector2vector_converter<8,4>* mp_M_AXI_GP1_ARLEN_converter;
  sc_signal< sc_bv<8> > m_M_AXI_GP1_ARLEN_converter_signal;
  xsc::common::vector2vector_converter<8,4>* mp_M_AXI_GP1_AWLEN_converter;
  sc_signal< sc_bv<8> > m_M_AXI_GP1_AWLEN_converter_signal;
  sc_signal< bool > m_M_AXI_GP1_transactor_rst_signal;
  xtlm::xaximm_pin2xtlm_t<64,32,3,5,1,1,5,1>* mp_S_AXI_ACP_transactor;
  xsc::common::vector2vector_converter<4,8>* mp_S_AXI_ACP_ARLEN_converter;
  sc_signal< sc_bv<8> > m_S_AXI_ACP_ARLEN_converter_signal;
  xsc::common::vector2vector_converter<4,8>* mp_S_AXI_ACP_AWLEN_converter;
  sc_signal< sc_bv<8> > m_S_AXI_ACP_AWLEN_converter_signal;
  xsc::common::vectorN2scalar_converter<2>* mp_S_AXI_ACP_ARLOCK_converter;
  sc_signal< bool > m_S_AXI_ACP_ARLOCK_converter_signal;
  xsc::common::vectorN2scalar_converter<2>* mp_S_AXI_ACP_AWLOCK_converter;
  sc_signal< bool > m_S_AXI_ACP_AWLOCK_converter_signal;
  sc_signal< bool > m_S_AXI_ACP_transactor_rst_signal;
  xtlm::xaximm_pin2xtlm_t<32,32,6,1,1,1,1,1>* mp_S_AXI_GP0_transactor;
  xsc::common::vectorN2scalar_converter<2>* mp_S_AXI_GP0_ARLOCK_converter;
  sc_signal< bool > m_S_AXI_GP0_ARLOCK_converter_signal;
  xsc::common::vectorN2scalar_converter<2>* mp_S_AXI_GP0_AWLOCK_converter;
  sc_signal< bool > m_S_AXI_GP0_AWLOCK_converter_signal;
  xsc::common::vector2vector_converter<4,8>* mp_S_AXI_GP0_ARLEN_converter;
  sc_signal< sc_bv<8> > m_S_AXI_GP0_ARLEN_converter_signal;
  xsc::common::vector2vector_converter<4,8>* mp_S_AXI_GP0_AWLEN_converter;
  sc_signal< sc_bv<8> > m_S_AXI_GP0_AWLEN_converter_signal;
  sc_signal< bool > m_S_AXI_GP0_transactor_rst_signal;
  xtlm::xaximm_pin2xtlm_t<32,32,6,1,1,1,1,1>* mp_S_AXI_GP1_transactor;
  xsc::common::vectorN2scalar_converter<2>* mp_S_AXI_GP1_ARLOCK_converter;
  sc_signal< bool > m_S_AXI_GP1_ARLOCK_converter_signal;
  xsc::common::vectorN2scalar_converter<2>* mp_S_AXI_GP1_AWLOCK_converter;
  sc_signal< bool > m_S_AXI_GP1_AWLOCK_converter_signal;
  xsc::common::vector2vector_converter<4,8>* mp_S_AXI_GP1_ARLEN_converter;
  sc_signal< sc_bv<8> > m_S_AXI_GP1_ARLEN_converter_signal;
  xsc::common::vector2vector_converter<4,8>* mp_S_AXI_GP1_AWLEN_converter;
  sc_signal< sc_bv<8> > m_S_AXI_GP1_AWLEN_converter_signal;
  sc_signal< bool > m_S_AXI_GP1_transactor_rst_signal;
  xtlm::xaximm_pin2xtlm_t<64,32,6,1,1,1,1,1>* mp_S_AXI_HP0_transactor;
  xsc::common::vectorN2scalar_converter<2>* mp_S_AXI_HP0_ARLOCK_converter;
  sc_signal< bool > m_S_AXI_HP0_ARLOCK_converter_signal;
  xsc::common::vectorN2scalar_converter<2>* mp_S_AXI_HP0_AWLOCK_converter;
  sc_signal< bool > m_S_AXI_HP0_AWLOCK_converter_signal;
  xsc::common::vector2vector_converter<4,8>* mp_S_AXI_HP0_ARLEN_converter;
  sc_signal< sc_bv<8> > m_S_AXI_HP0_ARLEN_converter_signal;
  xsc::common::vector2vector_converter<4,8>* mp_S_AXI_HP0_AWLEN_converter;
  sc_signal< sc_bv<8> > m_S_AXI_HP0_AWLEN_converter_signal;
  sc_signal< bool > m_S_AXI_HP0_transactor_rst_signal;
  xtlm::xaximm_pin2xtlm_t<64,32,6,1,1,1,1,1>* mp_S_AXI_HP1_transactor;
  xsc::common::vectorN2scalar_converter<2>* mp_S_AXI_HP1_ARLOCK_converter;
  sc_signal< bool > m_S_AXI_HP1_ARLOCK_converter_signal;
  xsc::common::vectorN2scalar_converter<2>* mp_S_AXI_HP1_AWLOCK_converter;
  sc_signal< bool > m_S_AXI_HP1_AWLOCK_converter_signal;
  xsc::common::vector2vector_converter<4,8>* mp_S_AXI_HP1_ARLEN_converter;
  sc_signal< sc_bv<8> > m_S_AXI_HP1_ARLEN_converter_signal;
  xsc::common::vector2vector_converter<4,8>* mp_S_AXI_HP1_AWLEN_converter;
  sc_signal< sc_bv<8> > m_S_AXI_HP1_AWLEN_converter_signal;
  sc_signal< bool > m_S_AXI_HP1_transactor_rst_signal;

};
#endif // RIVIERA




#ifdef VCSSYSTEMC
#include "utils/xtlm_aximm_initiator_stub.h"

#include "utils/xtlm_aximm_target_stub.h"

#include "utils/xtlm_axis_initiator_stub.h"

#include "utils/xtlm_axis_target_stub.h"

class DllExport design_1_processing_system7_0_0 : public design_1_processing_system7_0_0_sc
{
public:

  design_1_processing_system7_0_0(const sc_core::sc_module_name& nm);
  virtual ~design_1_processing_system7_0_0();

  // module pin-to-pin RTL interface

  sc_core::sc_out< bool > CAN0_PHY_TX;
  sc_core::sc_in< bool > CAN0_PHY_RX;
  sc_core::sc_in< bool > PJTAG_TCK;
  sc_core::sc_in< bool > PJTAG_TMS;
  sc_core::sc_in< bool > PJTAG_TDI;
  sc_core::sc_out< bool > PJTAG_TDO;
  sc_core::sc_in< bool > SPI0_SCLK_I;
  sc_core::sc_out< bool > SPI0_SCLK_O;
  sc_core::sc_out< bool > SPI0_SCLK_T;
  sc_core::sc_in< bool > SPI0_MOSI_I;
  sc_core::sc_out< bool > SPI0_MOSI_O;
  sc_core::sc_out< bool > SPI0_MOSI_T;
  sc_core::sc_in< bool > SPI0_MISO_I;
  sc_core::sc_out< bool > SPI0_MISO_O;
  sc_core::sc_out< bool > SPI0_MISO_T;
  sc_core::sc_in< bool > SPI0_SS_I;
  sc_core::sc_out< bool > SPI0_SS_O;
  sc_core::sc_out< bool > SPI0_SS1_O;
  sc_core::sc_out< bool > SPI0_SS2_O;
  sc_core::sc_out< bool > SPI0_SS_T;
  sc_core::sc_out< bool > TTC0_WAVE0_OUT;
  sc_core::sc_out< bool > TTC0_WAVE1_OUT;
  sc_core::sc_out< bool > TTC0_WAVE2_OUT;
  sc_core::sc_out< sc_dt::sc_bv<2> > USB0_PORT_INDCTL;
  sc_core::sc_out< bool > USB0_VBUS_PWRSELECT;
  sc_core::sc_in< bool > USB0_VBUS_PWRFAULT;
  sc_core::sc_out< bool > M_AXI_GP0_ARVALID;
  sc_core::sc_out< bool > M_AXI_GP0_AWVALID;
  sc_core::sc_out< bool > M_AXI_GP0_BREADY;
  sc_core::sc_out< bool > M_AXI_GP0_RREADY;
  sc_core::sc_out< bool > M_AXI_GP0_WLAST;
  sc_core::sc_out< bool > M_AXI_GP0_WVALID;
  sc_core::sc_out< sc_dt::sc_bv<12> > M_AXI_GP0_ARID;
  sc_core::sc_out< sc_dt::sc_bv<12> > M_AXI_GP0_AWID;
  sc_core::sc_out< sc_dt::sc_bv<12> > M_AXI_GP0_WID;
  sc_core::sc_out< sc_dt::sc_bv<2> > M_AXI_GP0_ARBURST;
  sc_core::sc_out< sc_dt::sc_bv<2> > M_AXI_GP0_ARLOCK;
  sc_core::sc_out< sc_dt::sc_bv<3> > M_AXI_GP0_ARSIZE;
  sc_core::sc_out< sc_dt::sc_bv<2> > M_AXI_GP0_AWBURST;
  sc_core::sc_out< sc_dt::sc_bv<2> > M_AXI_GP0_AWLOCK;
  sc_core::sc_out< sc_dt::sc_bv<3> > M_AXI_GP0_AWSIZE;
  sc_core::sc_out< sc_dt::sc_bv<3> > M_AXI_GP0_ARPROT;
  sc_core::sc_out< sc_dt::sc_bv<3> > M_AXI_GP0_AWPROT;
  sc_core::sc_out< sc_dt::sc_bv<32> > M_AXI_GP0_ARADDR;
  sc_core::sc_out< sc_dt::sc_bv<32> > M_AXI_GP0_AWADDR;
  sc_core::sc_out< sc_dt::sc_bv<32> > M_AXI_GP0_WDATA;
  sc_core::sc_out< sc_dt::sc_bv<4> > M_AXI_GP0_ARCACHE;
  sc_core::sc_out< sc_dt::sc_bv<4> > M_AXI_GP0_ARLEN;
  sc_core::sc_out< sc_dt::sc_bv<4> > M_AXI_GP0_ARQOS;
  sc_core::sc_out< sc_dt::sc_bv<4> > M_AXI_GP0_AWCACHE;
  sc_core::sc_out< sc_dt::sc_bv<4> > M_AXI_GP0_AWLEN;
  sc_core::sc_out< sc_dt::sc_bv<4> > M_AXI_GP0_AWQOS;
  sc_core::sc_out< sc_dt::sc_bv<4> > M_AXI_GP0_WSTRB;
  sc_core::sc_in< bool > M_AXI_GP0_ACLK;
  sc_core::sc_in< bool > M_AXI_GP0_ARREADY;
  sc_core::sc_in< bool > M_AXI_GP0_AWREADY;
  sc_core::sc_in< bool > M_AXI_GP0_BVALID;
  sc_core::sc_in< bool > M_AXI_GP0_RLAST;
  sc_core::sc_in< bool > M_AXI_GP0_RVALID;
  sc_core::sc_in< bool > M_AXI_GP0_WREADY;
  sc_core::sc_in< sc_dt::sc_bv<12> > M_AXI_GP0_BID;
  sc_core::sc_in< sc_dt::sc_bv<12> > M_AXI_GP0_RID;
  sc_core::sc_in< sc_dt::sc_bv<2> > M_AXI_GP0_BRESP;
  sc_core::sc_in< sc_dt::sc_bv<2> > M_AXI_GP0_RRESP;
  sc_core::sc_in< sc_dt::sc_bv<32> > M_AXI_GP0_RDATA;
  sc_core::sc_out< bool > M_AXI_GP1_ARVALID;
  sc_core::sc_out< bool > M_AXI_GP1_AWVALID;
  sc_core::sc_out< bool > M_AXI_GP1_BREADY;
  sc_core::sc_out< bool > M_AXI_GP1_RREADY;
  sc_core::sc_out< bool > M_AXI_GP1_WLAST;
  sc_core::sc_out< bool > M_AXI_GP1_WVALID;
  sc_core::sc_out< sc_dt::sc_bv<12> > M_AXI_GP1_ARID;
  sc_core::sc_out< sc_dt::sc_bv<12> > M_AXI_GP1_AWID;
  sc_core::sc_out< sc_dt::sc_bv<12> > M_AXI_GP1_WID;
  sc_core::sc_out< sc_dt::sc_bv<2> > M_AXI_GP1_ARBURST;
  sc_core::sc_out< sc_dt::sc_bv<2> > M_AXI_GP1_ARLOCK;
  sc_core::sc_out< sc_dt::sc_bv<3> > M_AXI_GP1_ARSIZE;
  sc_core::sc_out< sc_dt::sc_bv<2> > M_AXI_GP1_AWBURST;
  sc_core::sc_out< sc_dt::sc_bv<2> > M_AXI_GP1_AWLOCK;
  sc_core::sc_out< sc_dt::sc_bv<3> > M_AXI_GP1_AWSIZE;
  sc_core::sc_out< sc_dt::sc_bv<3> > M_AXI_GP1_ARPROT;
  sc_core::sc_out< sc_dt::sc_bv<3> > M_AXI_GP1_AWPROT;
  sc_core::sc_out< sc_dt::sc_bv<32> > M_AXI_GP1_ARADDR;
  sc_core::sc_out< sc_dt::sc_bv<32> > M_AXI_GP1_AWADDR;
  sc_core::sc_out< sc_dt::sc_bv<32> > M_AXI_GP1_WDATA;
  sc_core::sc_out< sc_dt::sc_bv<4> > M_AXI_GP1_ARCACHE;
  sc_core::sc_out< sc_dt::sc_bv<4> > M_AXI_GP1_ARLEN;
  sc_core::sc_out< sc_dt::sc_bv<4> > M_AXI_GP1_ARQOS;
  sc_core::sc_out< sc_dt::sc_bv<4> > M_AXI_GP1_AWCACHE;
  sc_core::sc_out< sc_dt::sc_bv<4> > M_AXI_GP1_AWLEN;
  sc_core::sc_out< sc_dt::sc_bv<4> > M_AXI_GP1_AWQOS;
  sc_core::sc_out< sc_dt::sc_bv<4> > M_AXI_GP1_WSTRB;
  sc_core::sc_in< bool > M_AXI_GP1_ACLK;
  sc_core::sc_in< bool > M_AXI_GP1_ARREADY;
  sc_core::sc_in< bool > M_AXI_GP1_AWREADY;
  sc_core::sc_in< bool > M_AXI_GP1_BVALID;
  sc_core::sc_in< bool > M_AXI_GP1_RLAST;
  sc_core::sc_in< bool > M_AXI_GP1_RVALID;
  sc_core::sc_in< bool > M_AXI_GP1_WREADY;
  sc_core::sc_in< sc_dt::sc_bv<12> > M_AXI_GP1_BID;
  sc_core::sc_in< sc_dt::sc_bv<12> > M_AXI_GP1_RID;
  sc_core::sc_in< sc_dt::sc_bv<2> > M_AXI_GP1_BRESP;
  sc_core::sc_in< sc_dt::sc_bv<2> > M_AXI_GP1_RRESP;
  sc_core::sc_in< sc_dt::sc_bv<32> > M_AXI_GP1_RDATA;
  sc_core::sc_out< bool > S_AXI_GP0_ARREADY;
  sc_core::sc_out< bool > S_AXI_GP0_AWREADY;
  sc_core::sc_out< bool > S_AXI_GP0_BVALID;
  sc_core::sc_out< bool > S_AXI_GP0_RLAST;
  sc_core::sc_out< bool > S_AXI_GP0_RVALID;
  sc_core::sc_out< bool > S_AXI_GP0_WREADY;
  sc_core::sc_out< sc_dt::sc_bv<2> > S_AXI_GP0_BRESP;
  sc_core::sc_out< sc_dt::sc_bv<2> > S_AXI_GP0_RRESP;
  sc_core::sc_out< sc_dt::sc_bv<32> > S_AXI_GP0_RDATA;
  sc_core::sc_out< sc_dt::sc_bv<6> > S_AXI_GP0_BID;
  sc_core::sc_out< sc_dt::sc_bv<6> > S_AXI_GP0_RID;
  sc_core::sc_in< bool > S_AXI_GP0_ACLK;
  sc_core::sc_in< bool > S_AXI_GP0_ARVALID;
  sc_core::sc_in< bool > S_AXI_GP0_AWVALID;
  sc_core::sc_in< bool > S_AXI_GP0_BREADY;
  sc_core::sc_in< bool > S_AXI_GP0_RREADY;
  sc_core::sc_in< bool > S_AXI_GP0_WLAST;
  sc_core::sc_in< bool > S_AXI_GP0_WVALID;
  sc_core::sc_in< sc_dt::sc_bv<2> > S_AXI_GP0_ARBURST;
  sc_core::sc_in< sc_dt::sc_bv<2> > S_AXI_GP0_ARLOCK;
  sc_core::sc_in< sc_dt::sc_bv<3> > S_AXI_GP0_ARSIZE;
  sc_core::sc_in< sc_dt::sc_bv<2> > S_AXI_GP0_AWBURST;
  sc_core::sc_in< sc_dt::sc_bv<2> > S_AXI_GP0_AWLOCK;
  sc_core::sc_in< sc_dt::sc_bv<3> > S_AXI_GP0_AWSIZE;
  sc_core::sc_in< sc_dt::sc_bv<3> > S_AXI_GP0_ARPROT;
  sc_core::sc_in< sc_dt::sc_bv<3> > S_AXI_GP0_AWPROT;
  sc_core::sc_in< sc_dt::sc_bv<32> > S_AXI_GP0_ARADDR;
  sc_core::sc_in< sc_dt::sc_bv<32> > S_AXI_GP0_AWADDR;
  sc_core::sc_in< sc_dt::sc_bv<32> > S_AXI_GP0_WDATA;
  sc_core::sc_in< sc_dt::sc_bv<4> > S_AXI_GP0_ARCACHE;
  sc_core::sc_in< sc_dt::sc_bv<4> > S_AXI_GP0_ARLEN;
  sc_core::sc_in< sc_dt::sc_bv<4> > S_AXI_GP0_ARQOS;
  sc_core::sc_in< sc_dt::sc_bv<4> > S_AXI_GP0_AWCACHE;
  sc_core::sc_in< sc_dt::sc_bv<4> > S_AXI_GP0_AWLEN;
  sc_core::sc_in< sc_dt::sc_bv<4> > S_AXI_GP0_AWQOS;
  sc_core::sc_in< sc_dt::sc_bv<4> > S_AXI_GP0_WSTRB;
  sc_core::sc_in< sc_dt::sc_bv<6> > S_AXI_GP0_ARID;
  sc_core::sc_in< sc_dt::sc_bv<6> > S_AXI_GP0_AWID;
  sc_core::sc_in< sc_dt::sc_bv<6> > S_AXI_GP0_WID;
  sc_core::sc_out< bool > S_AXI_GP1_ARREADY;
  sc_core::sc_out< bool > S_AXI_GP1_AWREADY;
  sc_core::sc_out< bool > S_AXI_GP1_BVALID;
  sc_core::sc_out< bool > S_AXI_GP1_RLAST;
  sc_core::sc_out< bool > S_AXI_GP1_RVALID;
  sc_core::sc_out< bool > S_AXI_GP1_WREADY;
  sc_core::sc_out< sc_dt::sc_bv<2> > S_AXI_GP1_BRESP;
  sc_core::sc_out< sc_dt::sc_bv<2> > S_AXI_GP1_RRESP;
  sc_core::sc_out< sc_dt::sc_bv<32> > S_AXI_GP1_RDATA;
  sc_core::sc_out< sc_dt::sc_bv<6> > S_AXI_GP1_BID;
  sc_core::sc_out< sc_dt::sc_bv<6> > S_AXI_GP1_RID;
  sc_core::sc_in< bool > S_AXI_GP1_ACLK;
  sc_core::sc_in< bool > S_AXI_GP1_ARVALID;
  sc_core::sc_in< bool > S_AXI_GP1_AWVALID;
  sc_core::sc_in< bool > S_AXI_GP1_BREADY;
  sc_core::sc_in< bool > S_AXI_GP1_RREADY;
  sc_core::sc_in< bool > S_AXI_GP1_WLAST;
  sc_core::sc_in< bool > S_AXI_GP1_WVALID;
  sc_core::sc_in< sc_dt::sc_bv<2> > S_AXI_GP1_ARBURST;
  sc_core::sc_in< sc_dt::sc_bv<2> > S_AXI_GP1_ARLOCK;
  sc_core::sc_in< sc_dt::sc_bv<3> > S_AXI_GP1_ARSIZE;
  sc_core::sc_in< sc_dt::sc_bv<2> > S_AXI_GP1_AWBURST;
  sc_core::sc_in< sc_dt::sc_bv<2> > S_AXI_GP1_AWLOCK;
  sc_core::sc_in< sc_dt::sc_bv<3> > S_AXI_GP1_AWSIZE;
  sc_core::sc_in< sc_dt::sc_bv<3> > S_AXI_GP1_ARPROT;
  sc_core::sc_in< sc_dt::sc_bv<3> > S_AXI_GP1_AWPROT;
  sc_core::sc_in< sc_dt::sc_bv<32> > S_AXI_GP1_ARADDR;
  sc_core::sc_in< sc_dt::sc_bv<32> > S_AXI_GP1_AWADDR;
  sc_core::sc_in< sc_dt::sc_bv<32> > S_AXI_GP1_WDATA;
  sc_core::sc_in< sc_dt::sc_bv<4> > S_AXI_GP1_ARCACHE;
  sc_core::sc_in< sc_dt::sc_bv<4> > S_AXI_GP1_ARLEN;
  sc_core::sc_in< sc_dt::sc_bv<4> > S_AXI_GP1_ARQOS;
  sc_core::sc_in< sc_dt::sc_bv<4> > S_AXI_GP1_AWCACHE;
  sc_core::sc_in< sc_dt::sc_bv<4> > S_AXI_GP1_AWLEN;
  sc_core::sc_in< sc_dt::sc_bv<4> > S_AXI_GP1_AWQOS;
  sc_core::sc_in< sc_dt::sc_bv<4> > S_AXI_GP1_WSTRB;
  sc_core::sc_in< sc_dt::sc_bv<6> > S_AXI_GP1_ARID;
  sc_core::sc_in< sc_dt::sc_bv<6> > S_AXI_GP1_AWID;
  sc_core::sc_in< sc_dt::sc_bv<6> > S_AXI_GP1_WID;
  sc_core::sc_out< bool > S_AXI_ACP_ARREADY;
  sc_core::sc_out< bool > S_AXI_ACP_AWREADY;
  sc_core::sc_out< bool > S_AXI_ACP_BVALID;
  sc_core::sc_out< bool > S_AXI_ACP_RLAST;
  sc_core::sc_out< bool > S_AXI_ACP_RVALID;
  sc_core::sc_out< bool > S_AXI_ACP_WREADY;
  sc_core::sc_out< sc_dt::sc_bv<2> > S_AXI_ACP_BRESP;
  sc_core::sc_out< sc_dt::sc_bv<2> > S_AXI_ACP_RRESP;
  sc_core::sc_out< sc_dt::sc_bv<3> > S_AXI_ACP_BID;
  sc_core::sc_out< sc_dt::sc_bv<3> > S_AXI_ACP_RID;
  sc_core::sc_out< sc_dt::sc_bv<64> > S_AXI_ACP_RDATA;
  sc_core::sc_in< bool > S_AXI_ACP_ACLK;
  sc_core::sc_in< bool > S_AXI_ACP_ARVALID;
  sc_core::sc_in< bool > S_AXI_ACP_AWVALID;
  sc_core::sc_in< bool > S_AXI_ACP_BREADY;
  sc_core::sc_in< bool > S_AXI_ACP_RREADY;
  sc_core::sc_in< bool > S_AXI_ACP_WLAST;
  sc_core::sc_in< bool > S_AXI_ACP_WVALID;
  sc_core::sc_in< sc_dt::sc_bv<3> > S_AXI_ACP_ARID;
  sc_core::sc_in< sc_dt::sc_bv<3> > S_AXI_ACP_ARPROT;
  sc_core::sc_in< sc_dt::sc_bv<3> > S_AXI_ACP_AWID;
  sc_core::sc_in< sc_dt::sc_bv<3> > S_AXI_ACP_AWPROT;
  sc_core::sc_in< sc_dt::sc_bv<3> > S_AXI_ACP_WID;
  sc_core::sc_in< sc_dt::sc_bv<32> > S_AXI_ACP_ARADDR;
  sc_core::sc_in< sc_dt::sc_bv<32> > S_AXI_ACP_AWADDR;
  sc_core::sc_in< sc_dt::sc_bv<4> > S_AXI_ACP_ARCACHE;
  sc_core::sc_in< sc_dt::sc_bv<4> > S_AXI_ACP_ARLEN;
  sc_core::sc_in< sc_dt::sc_bv<4> > S_AXI_ACP_ARQOS;
  sc_core::sc_in< sc_dt::sc_bv<4> > S_AXI_ACP_AWCACHE;
  sc_core::sc_in< sc_dt::sc_bv<4> > S_AXI_ACP_AWLEN;
  sc_core::sc_in< sc_dt::sc_bv<4> > S_AXI_ACP_AWQOS;
  sc_core::sc_in< sc_dt::sc_bv<2> > S_AXI_ACP_ARBURST;
  sc_core::sc_in< sc_dt::sc_bv<2> > S_AXI_ACP_ARLOCK;
  sc_core::sc_in< sc_dt::sc_bv<3> > S_AXI_ACP_ARSIZE;
  sc_core::sc_in< sc_dt::sc_bv<2> > S_AXI_ACP_AWBURST;
  sc_core::sc_in< sc_dt::sc_bv<2> > S_AXI_ACP_AWLOCK;
  sc_core::sc_in< sc_dt::sc_bv<3> > S_AXI_ACP_AWSIZE;
  sc_core::sc_in< sc_dt::sc_bv<5> > S_AXI_ACP_ARUSER;
  sc_core::sc_in< sc_dt::sc_bv<5> > S_AXI_ACP_AWUSER;
  sc_core::sc_in< sc_dt::sc_bv<64> > S_AXI_ACP_WDATA;
  sc_core::sc_in< sc_dt::sc_bv<8> > S_AXI_ACP_WSTRB;
  sc_core::sc_out< bool > S_AXI_HP0_ARREADY;
  sc_core::sc_out< bool > S_AXI_HP0_AWREADY;
  sc_core::sc_out< bool > S_AXI_HP0_BVALID;
  sc_core::sc_out< bool > S_AXI_HP0_RLAST;
  sc_core::sc_out< bool > S_AXI_HP0_RVALID;
  sc_core::sc_out< bool > S_AXI_HP0_WREADY;
  sc_core::sc_out< sc_dt::sc_bv<2> > S_AXI_HP0_BRESP;
  sc_core::sc_out< sc_dt::sc_bv<2> > S_AXI_HP0_RRESP;
  sc_core::sc_out< sc_dt::sc_bv<6> > S_AXI_HP0_BID;
  sc_core::sc_out< sc_dt::sc_bv<6> > S_AXI_HP0_RID;
  sc_core::sc_out< sc_dt::sc_bv<64> > S_AXI_HP0_RDATA;
  sc_core::sc_out< sc_dt::sc_bv<8> > S_AXI_HP0_RCOUNT;
  sc_core::sc_out< sc_dt::sc_bv<8> > S_AXI_HP0_WCOUNT;
  sc_core::sc_out< sc_dt::sc_bv<3> > S_AXI_HP0_RACOUNT;
  sc_core::sc_out< sc_dt::sc_bv<6> > S_AXI_HP0_WACOUNT;
  sc_core::sc_in< bool > S_AXI_HP0_ACLK;
  sc_core::sc_in< bool > S_AXI_HP0_ARVALID;
  sc_core::sc_in< bool > S_AXI_HP0_AWVALID;
  sc_core::sc_in< bool > S_AXI_HP0_BREADY;
  sc_core::sc_in< bool > S_AXI_HP0_RDISSUECAP1_EN;
  sc_core::sc_in< bool > S_AXI_HP0_RREADY;
  sc_core::sc_in< bool > S_AXI_HP0_WLAST;
  sc_core::sc_in< bool > S_AXI_HP0_WRISSUECAP1_EN;
  sc_core::sc_in< bool > S_AXI_HP0_WVALID;
  sc_core::sc_in< sc_dt::sc_bv<2> > S_AXI_HP0_ARBURST;
  sc_core::sc_in< sc_dt::sc_bv<2> > S_AXI_HP0_ARLOCK;
  sc_core::sc_in< sc_dt::sc_bv<3> > S_AXI_HP0_ARSIZE;
  sc_core::sc_in< sc_dt::sc_bv<2> > S_AXI_HP0_AWBURST;
  sc_core::sc_in< sc_dt::sc_bv<2> > S_AXI_HP0_AWLOCK;
  sc_core::sc_in< sc_dt::sc_bv<3> > S_AXI_HP0_AWSIZE;
  sc_core::sc_in< sc_dt::sc_bv<3> > S_AXI_HP0_ARPROT;
  sc_core::sc_in< sc_dt::sc_bv<3> > S_AXI_HP0_AWPROT;
  sc_core::sc_in< sc_dt::sc_bv<32> > S_AXI_HP0_ARADDR;
  sc_core::sc_in< sc_dt::sc_bv<32> > S_AXI_HP0_AWADDR;
  sc_core::sc_in< sc_dt::sc_bv<4> > S_AXI_HP0_ARCACHE;
  sc_core::sc_in< sc_dt::sc_bv<4> > S_AXI_HP0_ARLEN;
  sc_core::sc_in< sc_dt::sc_bv<4> > S_AXI_HP0_ARQOS;
  sc_core::sc_in< sc_dt::sc_bv<4> > S_AXI_HP0_AWCACHE;
  sc_core::sc_in< sc_dt::sc_bv<4> > S_AXI_HP0_AWLEN;
  sc_core::sc_in< sc_dt::sc_bv<4> > S_AXI_HP0_AWQOS;
  sc_core::sc_in< sc_dt::sc_bv<6> > S_AXI_HP0_ARID;
  sc_core::sc_in< sc_dt::sc_bv<6> > S_AXI_HP0_AWID;
  sc_core::sc_in< sc_dt::sc_bv<6> > S_AXI_HP0_WID;
  sc_core::sc_in< sc_dt::sc_bv<64> > S_AXI_HP0_WDATA;
  sc_core::sc_in< sc_dt::sc_bv<8> > S_AXI_HP0_WSTRB;
  sc_core::sc_out< bool > S_AXI_HP1_ARREADY;
  sc_core::sc_out< bool > S_AXI_HP1_AWREADY;
  sc_core::sc_out< bool > S_AXI_HP1_BVALID;
  sc_core::sc_out< bool > S_AXI_HP1_RLAST;
  sc_core::sc_out< bool > S_AXI_HP1_RVALID;
  sc_core::sc_out< bool > S_AXI_HP1_WREADY;
  sc_core::sc_out< sc_dt::sc_bv<2> > S_AXI_HP1_BRESP;
  sc_core::sc_out< sc_dt::sc_bv<2> > S_AXI_HP1_RRESP;
  sc_core::sc_out< sc_dt::sc_bv<6> > S_AXI_HP1_BID;
  sc_core::sc_out< sc_dt::sc_bv<6> > S_AXI_HP1_RID;
  sc_core::sc_out< sc_dt::sc_bv<64> > S_AXI_HP1_RDATA;
  sc_core::sc_out< sc_dt::sc_bv<8> > S_AXI_HP1_RCOUNT;
  sc_core::sc_out< sc_dt::sc_bv<8> > S_AXI_HP1_WCOUNT;
  sc_core::sc_out< sc_dt::sc_bv<3> > S_AXI_HP1_RACOUNT;
  sc_core::sc_out< sc_dt::sc_bv<6> > S_AXI_HP1_WACOUNT;
  sc_core::sc_in< bool > S_AXI_HP1_ACLK;
  sc_core::sc_in< bool > S_AXI_HP1_ARVALID;
  sc_core::sc_in< bool > S_AXI_HP1_AWVALID;
  sc_core::sc_in< bool > S_AXI_HP1_BREADY;
  sc_core::sc_in< bool > S_AXI_HP1_RDISSUECAP1_EN;
  sc_core::sc_in< bool > S_AXI_HP1_RREADY;
  sc_core::sc_in< bool > S_AXI_HP1_WLAST;
  sc_core::sc_in< bool > S_AXI_HP1_WRISSUECAP1_EN;
  sc_core::sc_in< bool > S_AXI_HP1_WVALID;
  sc_core::sc_in< sc_dt::sc_bv<2> > S_AXI_HP1_ARBURST;
  sc_core::sc_in< sc_dt::sc_bv<2> > S_AXI_HP1_ARLOCK;
  sc_core::sc_in< sc_dt::sc_bv<3> > S_AXI_HP1_ARSIZE;
  sc_core::sc_in< sc_dt::sc_bv<2> > S_AXI_HP1_AWBURST;
  sc_core::sc_in< sc_dt::sc_bv<2> > S_AXI_HP1_AWLOCK;
  sc_core::sc_in< sc_dt::sc_bv<3> > S_AXI_HP1_AWSIZE;
  sc_core::sc_in< sc_dt::sc_bv<3> > S_AXI_HP1_ARPROT;
  sc_core::sc_in< sc_dt::sc_bv<3> > S_AXI_HP1_AWPROT;
  sc_core::sc_in< sc_dt::sc_bv<32> > S_AXI_HP1_ARADDR;
  sc_core::sc_in< sc_dt::sc_bv<32> > S_AXI_HP1_AWADDR;
  sc_core::sc_in< sc_dt::sc_bv<4> > S_AXI_HP1_ARCACHE;
  sc_core::sc_in< sc_dt::sc_bv<4> > S_AXI_HP1_ARLEN;
  sc_core::sc_in< sc_dt::sc_bv<4> > S_AXI_HP1_ARQOS;
  sc_core::sc_in< sc_dt::sc_bv<4> > S_AXI_HP1_AWCACHE;
  sc_core::sc_in< sc_dt::sc_bv<4> > S_AXI_HP1_AWLEN;
  sc_core::sc_in< sc_dt::sc_bv<4> > S_AXI_HP1_AWQOS;
  sc_core::sc_in< sc_dt::sc_bv<6> > S_AXI_HP1_ARID;
  sc_core::sc_in< sc_dt::sc_bv<6> > S_AXI_HP1_AWID;
  sc_core::sc_in< sc_dt::sc_bv<6> > S_AXI_HP1_WID;
  sc_core::sc_in< sc_dt::sc_bv<64> > S_AXI_HP1_WDATA;
  sc_core::sc_in< sc_dt::sc_bv<8> > S_AXI_HP1_WSTRB;
  sc_core::sc_in< sc_dt::sc_bv<2> > IRQ_F2P;
  sc_core::sc_out< sc_dt::sc_bv<2> > DMA0_DATYPE;
  sc_core::sc_out< bool > DMA0_DAVALID;
  sc_core::sc_out< bool > DMA0_DRREADY;
  sc_core::sc_in< bool > DMA0_ACLK;
  sc_core::sc_in< bool > DMA0_DAREADY;
  sc_core::sc_in< bool > DMA0_DRLAST;
  sc_core::sc_in< bool > DMA0_DRVALID;
  sc_core::sc_in< sc_dt::sc_bv<2> > DMA0_DRTYPE;
  sc_core::sc_out< bool > FCLK_CLK0;
  sc_core::sc_out< bool > FCLK_CLK1;
  sc_core::sc_out< bool > FCLK_CLK2;
  sc_core::sc_out< bool > FCLK_CLK3;
  sc_core::sc_out< bool > FCLK_RESET0_N;
  sc_core::sc_out< bool > FCLK_RESET1_N;
  sc_core::sc_out< bool > FCLK_RESET2_N;
  sc_core::sc_out< bool > FCLK_RESET3_N;
  sc_core::sc_in< sc_dt::sc_bv<32> > FTMT_F2P_DEBUG;
  sc_core::sc_out< sc_dt::sc_bv<32> > FTMT_P2F_DEBUG;
  sc_core::sc_out< sc_dt::sc_bv<54> > MIO;
  sc_core::sc_out< bool > DDR_CAS_n;
  sc_core::sc_out< bool > DDR_CKE;
  sc_core::sc_out< bool > DDR_Clk_n;
  sc_core::sc_out< bool > DDR_Clk;
  sc_core::sc_out< bool > DDR_CS_n;
  sc_core::sc_out< bool > DDR_DRSTB;
  sc_core::sc_out< bool > DDR_ODT;
  sc_core::sc_out< bool > DDR_RAS_n;
  sc_core::sc_out< bool > DDR_WEB;
  sc_core::sc_out< sc_dt::sc_bv<3> > DDR_BankAddr;
  sc_core::sc_out< sc_dt::sc_bv<15> > DDR_Addr;
  sc_core::sc_out< bool > DDR_VRN;
  sc_core::sc_out< bool > DDR_VRP;
  sc_core::sc_out< sc_dt::sc_bv<4> > DDR_DM;
  sc_core::sc_out< sc_dt::sc_bv<32> > DDR_DQ;
  sc_core::sc_out< sc_dt::sc_bv<4> > DDR_DQS_n;
  sc_core::sc_out< sc_dt::sc_bv<4> > DDR_DQS;
  sc_core::sc_out< bool > PS_SRSTB;
  sc_core::sc_out< bool > PS_CLK;
  sc_core::sc_out< bool > PS_PORB;

  // Dummy Signals for IP Ports


protected:

  virtual void before_end_of_elaboration();

private:

  xtlm::xaxis_pin2xtlm_t<1,2,1,1,1,1>* mp_DMA0_REQ_transactor;
  sc_signal< bool > m_DMA0_REQ_transactor_rst_signal;
  xtlm::xaxis_xtlm2pin_t<1,2,1,1,1,1>* mp_DMA0_ACK_transactor;
  sc_signal< bool > m_DMA0_ACK_transactor_rst_signal;
  xtlm::xaximm_xtlm2pin_t<32,32,12,1,1,1,1,1>* mp_M_AXI_GP0_transactor;
  xsc::common::scalar2vectorN_converter<2>* mp_M_AXI_GP0_ARLOCK_converter;
  sc_signal< bool > m_M_AXI_GP0_ARLOCK_converter_signal;
  xsc::common::scalar2vectorN_converter<2>* mp_M_AXI_GP0_AWLOCK_converter;
  sc_signal< bool > m_M_AXI_GP0_AWLOCK_converter_signal;
  xsc::common::vector2vector_converter<8,4>* mp_M_AXI_GP0_ARLEN_converter;
  sc_signal< sc_bv<8> > m_M_AXI_GP0_ARLEN_converter_signal;
  xsc::common::vector2vector_converter<8,4>* mp_M_AXI_GP0_AWLEN_converter;
  sc_signal< sc_bv<8> > m_M_AXI_GP0_AWLEN_converter_signal;
  sc_signal< bool > m_M_AXI_GP0_transactor_rst_signal;
  xtlm::xaximm_xtlm2pin_t<32,32,12,1,1,1,1,1>* mp_M_AXI_GP1_transactor;
  xsc::common::scalar2vectorN_converter<2>* mp_M_AXI_GP1_ARLOCK_converter;
  sc_signal< bool > m_M_AXI_GP1_ARLOCK_converter_signal;
  xsc::common::scalar2vectorN_converter<2>* mp_M_AXI_GP1_AWLOCK_converter;
  sc_signal< bool > m_M_AXI_GP1_AWLOCK_converter_signal;
  xsc::common::vector2vector_converter<8,4>* mp_M_AXI_GP1_ARLEN_converter;
  sc_signal< sc_bv<8> > m_M_AXI_GP1_ARLEN_converter_signal;
  xsc::common::vector2vector_converter<8,4>* mp_M_AXI_GP1_AWLEN_converter;
  sc_signal< sc_bv<8> > m_M_AXI_GP1_AWLEN_converter_signal;
  sc_signal< bool > m_M_AXI_GP1_transactor_rst_signal;
  xtlm::xaximm_pin2xtlm_t<64,32,3,5,1,1,5,1>* mp_S_AXI_ACP_transactor;
  xsc::common::vector2vector_converter<4,8>* mp_S_AXI_ACP_ARLEN_converter;
  sc_signal< sc_bv<8> > m_S_AXI_ACP_ARLEN_converter_signal;
  xsc::common::vector2vector_converter<4,8>* mp_S_AXI_ACP_AWLEN_converter;
  sc_signal< sc_bv<8> > m_S_AXI_ACP_AWLEN_converter_signal;
  xsc::common::vectorN2scalar_converter<2>* mp_S_AXI_ACP_ARLOCK_converter;
  sc_signal< bool > m_S_AXI_ACP_ARLOCK_converter_signal;
  xsc::common::vectorN2scalar_converter<2>* mp_S_AXI_ACP_AWLOCK_converter;
  sc_signal< bool > m_S_AXI_ACP_AWLOCK_converter_signal;
  sc_signal< bool > m_S_AXI_ACP_transactor_rst_signal;
  xtlm::xaximm_pin2xtlm_t<32,32,6,1,1,1,1,1>* mp_S_AXI_GP0_transactor;
  xsc::common::vectorN2scalar_converter<2>* mp_S_AXI_GP0_ARLOCK_converter;
  sc_signal< bool > m_S_AXI_GP0_ARLOCK_converter_signal;
  xsc::common::vectorN2scalar_converter<2>* mp_S_AXI_GP0_AWLOCK_converter;
  sc_signal< bool > m_S_AXI_GP0_AWLOCK_converter_signal;
  xsc::common::vector2vector_converter<4,8>* mp_S_AXI_GP0_ARLEN_converter;
  sc_signal< sc_bv<8> > m_S_AXI_GP0_ARLEN_converter_signal;
  xsc::common::vector2vector_converter<4,8>* mp_S_AXI_GP0_AWLEN_converter;
  sc_signal< sc_bv<8> > m_S_AXI_GP0_AWLEN_converter_signal;
  sc_signal< bool > m_S_AXI_GP0_transactor_rst_signal;
  xtlm::xaximm_pin2xtlm_t<32,32,6,1,1,1,1,1>* mp_S_AXI_GP1_transactor;
  xsc::common::vectorN2scalar_converter<2>* mp_S_AXI_GP1_ARLOCK_converter;
  sc_signal< bool > m_S_AXI_GP1_ARLOCK_converter_signal;
  xsc::common::vectorN2scalar_converter<2>* mp_S_AXI_GP1_AWLOCK_converter;
  sc_signal< bool > m_S_AXI_GP1_AWLOCK_converter_signal;
  xsc::common::vector2vector_converter<4,8>* mp_S_AXI_GP1_ARLEN_converter;
  sc_signal< sc_bv<8> > m_S_AXI_GP1_ARLEN_converter_signal;
  xsc::common::vector2vector_converter<4,8>* mp_S_AXI_GP1_AWLEN_converter;
  sc_signal< sc_bv<8> > m_S_AXI_GP1_AWLEN_converter_signal;
  sc_signal< bool > m_S_AXI_GP1_transactor_rst_signal;
  xtlm::xaximm_pin2xtlm_t<64,32,6,1,1,1,1,1>* mp_S_AXI_HP0_transactor;
  xsc::common::vectorN2scalar_converter<2>* mp_S_AXI_HP0_ARLOCK_converter;
  sc_signal< bool > m_S_AXI_HP0_ARLOCK_converter_signal;
  xsc::common::vectorN2scalar_converter<2>* mp_S_AXI_HP0_AWLOCK_converter;
  sc_signal< bool > m_S_AXI_HP0_AWLOCK_converter_signal;
  xsc::common::vector2vector_converter<4,8>* mp_S_AXI_HP0_ARLEN_converter;
  sc_signal< sc_bv<8> > m_S_AXI_HP0_ARLEN_converter_signal;
  xsc::common::vector2vector_converter<4,8>* mp_S_AXI_HP0_AWLEN_converter;
  sc_signal< sc_bv<8> > m_S_AXI_HP0_AWLEN_converter_signal;
  sc_signal< bool > m_S_AXI_HP0_transactor_rst_signal;
  xtlm::xaximm_pin2xtlm_t<64,32,6,1,1,1,1,1>* mp_S_AXI_HP1_transactor;
  xsc::common::vectorN2scalar_converter<2>* mp_S_AXI_HP1_ARLOCK_converter;
  sc_signal< bool > m_S_AXI_HP1_ARLOCK_converter_signal;
  xsc::common::vectorN2scalar_converter<2>* mp_S_AXI_HP1_AWLOCK_converter;
  sc_signal< bool > m_S_AXI_HP1_AWLOCK_converter_signal;
  xsc::common::vector2vector_converter<4,8>* mp_S_AXI_HP1_ARLEN_converter;
  sc_signal< sc_bv<8> > m_S_AXI_HP1_ARLEN_converter_signal;
  xsc::common::vector2vector_converter<4,8>* mp_S_AXI_HP1_AWLEN_converter;
  sc_signal< sc_bv<8> > m_S_AXI_HP1_AWLEN_converter_signal;
  sc_signal< bool > m_S_AXI_HP1_transactor_rst_signal;

  // Transactor stubs
  xtlm::xtlm_aximm_initiator_stub * M_AXI_GP0_transactor_initiator_rd_socket_stub;
  xtlm::xtlm_aximm_initiator_stub * M_AXI_GP0_transactor_initiator_wr_socket_stub;
  xtlm::xtlm_aximm_initiator_stub * M_AXI_GP1_transactor_initiator_rd_socket_stub;
  xtlm::xtlm_aximm_initiator_stub * M_AXI_GP1_transactor_initiator_wr_socket_stub;
  xtlm::xtlm_aximm_target_stub * S_AXI_ACP_transactor_target_rd_socket_stub;
  xtlm::xtlm_aximm_target_stub * S_AXI_ACP_transactor_target_wr_socket_stub;
  xtlm::xtlm_aximm_target_stub * S_AXI_GP0_transactor_target_rd_socket_stub;
  xtlm::xtlm_aximm_target_stub * S_AXI_GP0_transactor_target_wr_socket_stub;
  xtlm::xtlm_aximm_target_stub * S_AXI_GP1_transactor_target_rd_socket_stub;
  xtlm::xtlm_aximm_target_stub * S_AXI_GP1_transactor_target_wr_socket_stub;
  xtlm::xtlm_aximm_target_stub * S_AXI_HP0_transactor_target_rd_socket_stub;
  xtlm::xtlm_aximm_target_stub * S_AXI_HP0_transactor_target_wr_socket_stub;
  xtlm::xtlm_aximm_target_stub * S_AXI_HP1_transactor_target_rd_socket_stub;
  xtlm::xtlm_aximm_target_stub * S_AXI_HP1_transactor_target_wr_socket_stub;
  xtlm::xtlm_axis_initiator_stub * DMA0_ACK_transactor_initiator_socket_stub;
  xtlm::xtlm_axis_target_stub * DMA0_REQ_transactor_target_socket_stub;

  // Socket stubs

};
#endif // VCSSYSTEMC




#ifdef MTI_SYSTEMC
#include "utils/xtlm_aximm_initiator_stub.h"

#include "utils/xtlm_aximm_target_stub.h"

#include "utils/xtlm_axis_initiator_stub.h"

#include "utils/xtlm_axis_target_stub.h"

class DllExport design_1_processing_system7_0_0 : public design_1_processing_system7_0_0_sc
{
public:

  design_1_processing_system7_0_0(const sc_core::sc_module_name& nm);
  virtual ~design_1_processing_system7_0_0();

  // module pin-to-pin RTL interface

  sc_core::sc_out< bool > CAN0_PHY_TX;
  sc_core::sc_in< bool > CAN0_PHY_RX;
  sc_core::sc_in< bool > PJTAG_TCK;
  sc_core::sc_in< bool > PJTAG_TMS;
  sc_core::sc_in< bool > PJTAG_TDI;
  sc_core::sc_out< bool > PJTAG_TDO;
  sc_core::sc_in< bool > SPI0_SCLK_I;
  sc_core::sc_out< bool > SPI0_SCLK_O;
  sc_core::sc_out< bool > SPI0_SCLK_T;
  sc_core::sc_in< bool > SPI0_MOSI_I;
  sc_core::sc_out< bool > SPI0_MOSI_O;
  sc_core::sc_out< bool > SPI0_MOSI_T;
  sc_core::sc_in< bool > SPI0_MISO_I;
  sc_core::sc_out< bool > SPI0_MISO_O;
  sc_core::sc_out< bool > SPI0_MISO_T;
  sc_core::sc_in< bool > SPI0_SS_I;
  sc_core::sc_out< bool > SPI0_SS_O;
  sc_core::sc_out< bool > SPI0_SS1_O;
  sc_core::sc_out< bool > SPI0_SS2_O;
  sc_core::sc_out< bool > SPI0_SS_T;
  sc_core::sc_out< bool > TTC0_WAVE0_OUT;
  sc_core::sc_out< bool > TTC0_WAVE1_OUT;
  sc_core::sc_out< bool > TTC0_WAVE2_OUT;
  sc_core::sc_out< sc_dt::sc_bv<2> > USB0_PORT_INDCTL;
  sc_core::sc_out< bool > USB0_VBUS_PWRSELECT;
  sc_core::sc_in< bool > USB0_VBUS_PWRFAULT;
  sc_core::sc_out< bool > M_AXI_GP0_ARVALID;
  sc_core::sc_out< bool > M_AXI_GP0_AWVALID;
  sc_core::sc_out< bool > M_AXI_GP0_BREADY;
  sc_core::sc_out< bool > M_AXI_GP0_RREADY;
  sc_core::sc_out< bool > M_AXI_GP0_WLAST;
  sc_core::sc_out< bool > M_AXI_GP0_WVALID;
  sc_core::sc_out< sc_dt::sc_bv<12> > M_AXI_GP0_ARID;
  sc_core::sc_out< sc_dt::sc_bv<12> > M_AXI_GP0_AWID;
  sc_core::sc_out< sc_dt::sc_bv<12> > M_AXI_GP0_WID;
  sc_core::sc_out< sc_dt::sc_bv<2> > M_AXI_GP0_ARBURST;
  sc_core::sc_out< sc_dt::sc_bv<2> > M_AXI_GP0_ARLOCK;
  sc_core::sc_out< sc_dt::sc_bv<3> > M_AXI_GP0_ARSIZE;
  sc_core::sc_out< sc_dt::sc_bv<2> > M_AXI_GP0_AWBURST;
  sc_core::sc_out< sc_dt::sc_bv<2> > M_AXI_GP0_AWLOCK;
  sc_core::sc_out< sc_dt::sc_bv<3> > M_AXI_GP0_AWSIZE;
  sc_core::sc_out< sc_dt::sc_bv<3> > M_AXI_GP0_ARPROT;
  sc_core::sc_out< sc_dt::sc_bv<3> > M_AXI_GP0_AWPROT;
  sc_core::sc_out< sc_dt::sc_bv<32> > M_AXI_GP0_ARADDR;
  sc_core::sc_out< sc_dt::sc_bv<32> > M_AXI_GP0_AWADDR;
  sc_core::sc_out< sc_dt::sc_bv<32> > M_AXI_GP0_WDATA;
  sc_core::sc_out< sc_dt::sc_bv<4> > M_AXI_GP0_ARCACHE;
  sc_core::sc_out< sc_dt::sc_bv<4> > M_AXI_GP0_ARLEN;
  sc_core::sc_out< sc_dt::sc_bv<4> > M_AXI_GP0_ARQOS;
  sc_core::sc_out< sc_dt::sc_bv<4> > M_AXI_GP0_AWCACHE;
  sc_core::sc_out< sc_dt::sc_bv<4> > M_AXI_GP0_AWLEN;
  sc_core::sc_out< sc_dt::sc_bv<4> > M_AXI_GP0_AWQOS;
  sc_core::sc_out< sc_dt::sc_bv<4> > M_AXI_GP0_WSTRB;
  sc_core::sc_in< bool > M_AXI_GP0_ACLK;
  sc_core::sc_in< bool > M_AXI_GP0_ARREADY;
  sc_core::sc_in< bool > M_AXI_GP0_AWREADY;
  sc_core::sc_in< bool > M_AXI_GP0_BVALID;
  sc_core::sc_in< bool > M_AXI_GP0_RLAST;
  sc_core::sc_in< bool > M_AXI_GP0_RVALID;
  sc_core::sc_in< bool > M_AXI_GP0_WREADY;
  sc_core::sc_in< sc_dt::sc_bv<12> > M_AXI_GP0_BID;
  sc_core::sc_in< sc_dt::sc_bv<12> > M_AXI_GP0_RID;
  sc_core::sc_in< sc_dt::sc_bv<2> > M_AXI_GP0_BRESP;
  sc_core::sc_in< sc_dt::sc_bv<2> > M_AXI_GP0_RRESP;
  sc_core::sc_in< sc_dt::sc_bv<32> > M_AXI_GP0_RDATA;
  sc_core::sc_out< bool > M_AXI_GP1_ARVALID;
  sc_core::sc_out< bool > M_AXI_GP1_AWVALID;
  sc_core::sc_out< bool > M_AXI_GP1_BREADY;
  sc_core::sc_out< bool > M_AXI_GP1_RREADY;
  sc_core::sc_out< bool > M_AXI_GP1_WLAST;
  sc_core::sc_out< bool > M_AXI_GP1_WVALID;
  sc_core::sc_out< sc_dt::sc_bv<12> > M_AXI_GP1_ARID;
  sc_core::sc_out< sc_dt::sc_bv<12> > M_AXI_GP1_AWID;
  sc_core::sc_out< sc_dt::sc_bv<12> > M_AXI_GP1_WID;
  sc_core::sc_out< sc_dt::sc_bv<2> > M_AXI_GP1_ARBURST;
  sc_core::sc_out< sc_dt::sc_bv<2> > M_AXI_GP1_ARLOCK;
  sc_core::sc_out< sc_dt::sc_bv<3> > M_AXI_GP1_ARSIZE;
  sc_core::sc_out< sc_dt::sc_bv<2> > M_AXI_GP1_AWBURST;
  sc_core::sc_out< sc_dt::sc_bv<2> > M_AXI_GP1_AWLOCK;
  sc_core::sc_out< sc_dt::sc_bv<3> > M_AXI_GP1_AWSIZE;
  sc_core::sc_out< sc_dt::sc_bv<3> > M_AXI_GP1_ARPROT;
  sc_core::sc_out< sc_dt::sc_bv<3> > M_AXI_GP1_AWPROT;
  sc_core::sc_out< sc_dt::sc_bv<32> > M_AXI_GP1_ARADDR;
  sc_core::sc_out< sc_dt::sc_bv<32> > M_AXI_GP1_AWADDR;
  sc_core::sc_out< sc_dt::sc_bv<32> > M_AXI_GP1_WDATA;
  sc_core::sc_out< sc_dt::sc_bv<4> > M_AXI_GP1_ARCACHE;
  sc_core::sc_out< sc_dt::sc_bv<4> > M_AXI_GP1_ARLEN;
  sc_core::sc_out< sc_dt::sc_bv<4> > M_AXI_GP1_ARQOS;
  sc_core::sc_out< sc_dt::sc_bv<4> > M_AXI_GP1_AWCACHE;
  sc_core::sc_out< sc_dt::sc_bv<4> > M_AXI_GP1_AWLEN;
  sc_core::sc_out< sc_dt::sc_bv<4> > M_AXI_GP1_AWQOS;
  sc_core::sc_out< sc_dt::sc_bv<4> > M_AXI_GP1_WSTRB;
  sc_core::sc_in< bool > M_AXI_GP1_ACLK;
  sc_core::sc_in< bool > M_AXI_GP1_ARREADY;
  sc_core::sc_in< bool > M_AXI_GP1_AWREADY;
  sc_core::sc_in< bool > M_AXI_GP1_BVALID;
  sc_core::sc_in< bool > M_AXI_GP1_RLAST;
  sc_core::sc_in< bool > M_AXI_GP1_RVALID;
  sc_core::sc_in< bool > M_AXI_GP1_WREADY;
  sc_core::sc_in< sc_dt::sc_bv<12> > M_AXI_GP1_BID;
  sc_core::sc_in< sc_dt::sc_bv<12> > M_AXI_GP1_RID;
  sc_core::sc_in< sc_dt::sc_bv<2> > M_AXI_GP1_BRESP;
  sc_core::sc_in< sc_dt::sc_bv<2> > M_AXI_GP1_RRESP;
  sc_core::sc_in< sc_dt::sc_bv<32> > M_AXI_GP1_RDATA;
  sc_core::sc_out< bool > S_AXI_GP0_ARREADY;
  sc_core::sc_out< bool > S_AXI_GP0_AWREADY;
  sc_core::sc_out< bool > S_AXI_GP0_BVALID;
  sc_core::sc_out< bool > S_AXI_GP0_RLAST;
  sc_core::sc_out< bool > S_AXI_GP0_RVALID;
  sc_core::sc_out< bool > S_AXI_GP0_WREADY;
  sc_core::sc_out< sc_dt::sc_bv<2> > S_AXI_GP0_BRESP;
  sc_core::sc_out< sc_dt::sc_bv<2> > S_AXI_GP0_RRESP;
  sc_core::sc_out< sc_dt::sc_bv<32> > S_AXI_GP0_RDATA;
  sc_core::sc_out< sc_dt::sc_bv<6> > S_AXI_GP0_BID;
  sc_core::sc_out< sc_dt::sc_bv<6> > S_AXI_GP0_RID;
  sc_core::sc_in< bool > S_AXI_GP0_ACLK;
  sc_core::sc_in< bool > S_AXI_GP0_ARVALID;
  sc_core::sc_in< bool > S_AXI_GP0_AWVALID;
  sc_core::sc_in< bool > S_AXI_GP0_BREADY;
  sc_core::sc_in< bool > S_AXI_GP0_RREADY;
  sc_core::sc_in< bool > S_AXI_GP0_WLAST;
  sc_core::sc_in< bool > S_AXI_GP0_WVALID;
  sc_core::sc_in< sc_dt::sc_bv<2> > S_AXI_GP0_ARBURST;
  sc_core::sc_in< sc_dt::sc_bv<2> > S_AXI_GP0_ARLOCK;
  sc_core::sc_in< sc_dt::sc_bv<3> > S_AXI_GP0_ARSIZE;
  sc_core::sc_in< sc_dt::sc_bv<2> > S_AXI_GP0_AWBURST;
  sc_core::sc_in< sc_dt::sc_bv<2> > S_AXI_GP0_AWLOCK;
  sc_core::sc_in< sc_dt::sc_bv<3> > S_AXI_GP0_AWSIZE;
  sc_core::sc_in< sc_dt::sc_bv<3> > S_AXI_GP0_ARPROT;
  sc_core::sc_in< sc_dt::sc_bv<3> > S_AXI_GP0_AWPROT;
  sc_core::sc_in< sc_dt::sc_bv<32> > S_AXI_GP0_ARADDR;
  sc_core::sc_in< sc_dt::sc_bv<32> > S_AXI_GP0_AWADDR;
  sc_core::sc_in< sc_dt::sc_bv<32> > S_AXI_GP0_WDATA;
  sc_core::sc_in< sc_dt::sc_bv<4> > S_AXI_GP0_ARCACHE;
  sc_core::sc_in< sc_dt::sc_bv<4> > S_AXI_GP0_ARLEN;
  sc_core::sc_in< sc_dt::sc_bv<4> > S_AXI_GP0_ARQOS;
  sc_core::sc_in< sc_dt::sc_bv<4> > S_AXI_GP0_AWCACHE;
  sc_core::sc_in< sc_dt::sc_bv<4> > S_AXI_GP0_AWLEN;
  sc_core::sc_in< sc_dt::sc_bv<4> > S_AXI_GP0_AWQOS;
  sc_core::sc_in< sc_dt::sc_bv<4> > S_AXI_GP0_WSTRB;
  sc_core::sc_in< sc_dt::sc_bv<6> > S_AXI_GP0_ARID;
  sc_core::sc_in< sc_dt::sc_bv<6> > S_AXI_GP0_AWID;
  sc_core::sc_in< sc_dt::sc_bv<6> > S_AXI_GP0_WID;
  sc_core::sc_out< bool > S_AXI_GP1_ARREADY;
  sc_core::sc_out< bool > S_AXI_GP1_AWREADY;
  sc_core::sc_out< bool > S_AXI_GP1_BVALID;
  sc_core::sc_out< bool > S_AXI_GP1_RLAST;
  sc_core::sc_out< bool > S_AXI_GP1_RVALID;
  sc_core::sc_out< bool > S_AXI_GP1_WREADY;
  sc_core::sc_out< sc_dt::sc_bv<2> > S_AXI_GP1_BRESP;
  sc_core::sc_out< sc_dt::sc_bv<2> > S_AXI_GP1_RRESP;
  sc_core::sc_out< sc_dt::sc_bv<32> > S_AXI_GP1_RDATA;
  sc_core::sc_out< sc_dt::sc_bv<6> > S_AXI_GP1_BID;
  sc_core::sc_out< sc_dt::sc_bv<6> > S_AXI_GP1_RID;
  sc_core::sc_in< bool > S_AXI_GP1_ACLK;
  sc_core::sc_in< bool > S_AXI_GP1_ARVALID;
  sc_core::sc_in< bool > S_AXI_GP1_AWVALID;
  sc_core::sc_in< bool > S_AXI_GP1_BREADY;
  sc_core::sc_in< bool > S_AXI_GP1_RREADY;
  sc_core::sc_in< bool > S_AXI_GP1_WLAST;
  sc_core::sc_in< bool > S_AXI_GP1_WVALID;
  sc_core::sc_in< sc_dt::sc_bv<2> > S_AXI_GP1_ARBURST;
  sc_core::sc_in< sc_dt::sc_bv<2> > S_AXI_GP1_ARLOCK;
  sc_core::sc_in< sc_dt::sc_bv<3> > S_AXI_GP1_ARSIZE;
  sc_core::sc_in< sc_dt::sc_bv<2> > S_AXI_GP1_AWBURST;
  sc_core::sc_in< sc_dt::sc_bv<2> > S_AXI_GP1_AWLOCK;
  sc_core::sc_in< sc_dt::sc_bv<3> > S_AXI_GP1_AWSIZE;
  sc_core::sc_in< sc_dt::sc_bv<3> > S_AXI_GP1_ARPROT;
  sc_core::sc_in< sc_dt::sc_bv<3> > S_AXI_GP1_AWPROT;
  sc_core::sc_in< sc_dt::sc_bv<32> > S_AXI_GP1_ARADDR;
  sc_core::sc_in< sc_dt::sc_bv<32> > S_AXI_GP1_AWADDR;
  sc_core::sc_in< sc_dt::sc_bv<32> > S_AXI_GP1_WDATA;
  sc_core::sc_in< sc_dt::sc_bv<4> > S_AXI_GP1_ARCACHE;
  sc_core::sc_in< sc_dt::sc_bv<4> > S_AXI_GP1_ARLEN;
  sc_core::sc_in< sc_dt::sc_bv<4> > S_AXI_GP1_ARQOS;
  sc_core::sc_in< sc_dt::sc_bv<4> > S_AXI_GP1_AWCACHE;
  sc_core::sc_in< sc_dt::sc_bv<4> > S_AXI_GP1_AWLEN;
  sc_core::sc_in< sc_dt::sc_bv<4> > S_AXI_GP1_AWQOS;
  sc_core::sc_in< sc_dt::sc_bv<4> > S_AXI_GP1_WSTRB;
  sc_core::sc_in< sc_dt::sc_bv<6> > S_AXI_GP1_ARID;
  sc_core::sc_in< sc_dt::sc_bv<6> > S_AXI_GP1_AWID;
  sc_core::sc_in< sc_dt::sc_bv<6> > S_AXI_GP1_WID;
  sc_core::sc_out< bool > S_AXI_ACP_ARREADY;
  sc_core::sc_out< bool > S_AXI_ACP_AWREADY;
  sc_core::sc_out< bool > S_AXI_ACP_BVALID;
  sc_core::sc_out< bool > S_AXI_ACP_RLAST;
  sc_core::sc_out< bool > S_AXI_ACP_RVALID;
  sc_core::sc_out< bool > S_AXI_ACP_WREADY;
  sc_core::sc_out< sc_dt::sc_bv<2> > S_AXI_ACP_BRESP;
  sc_core::sc_out< sc_dt::sc_bv<2> > S_AXI_ACP_RRESP;
  sc_core::sc_out< sc_dt::sc_bv<3> > S_AXI_ACP_BID;
  sc_core::sc_out< sc_dt::sc_bv<3> > S_AXI_ACP_RID;
  sc_core::sc_out< sc_dt::sc_bv<64> > S_AXI_ACP_RDATA;
  sc_core::sc_in< bool > S_AXI_ACP_ACLK;
  sc_core::sc_in< bool > S_AXI_ACP_ARVALID;
  sc_core::sc_in< bool > S_AXI_ACP_AWVALID;
  sc_core::sc_in< bool > S_AXI_ACP_BREADY;
  sc_core::sc_in< bool > S_AXI_ACP_RREADY;
  sc_core::sc_in< bool > S_AXI_ACP_WLAST;
  sc_core::sc_in< bool > S_AXI_ACP_WVALID;
  sc_core::sc_in< sc_dt::sc_bv<3> > S_AXI_ACP_ARID;
  sc_core::sc_in< sc_dt::sc_bv<3> > S_AXI_ACP_ARPROT;
  sc_core::sc_in< sc_dt::sc_bv<3> > S_AXI_ACP_AWID;
  sc_core::sc_in< sc_dt::sc_bv<3> > S_AXI_ACP_AWPROT;
  sc_core::sc_in< sc_dt::sc_bv<3> > S_AXI_ACP_WID;
  sc_core::sc_in< sc_dt::sc_bv<32> > S_AXI_ACP_ARADDR;
  sc_core::sc_in< sc_dt::sc_bv<32> > S_AXI_ACP_AWADDR;
  sc_core::sc_in< sc_dt::sc_bv<4> > S_AXI_ACP_ARCACHE;
  sc_core::sc_in< sc_dt::sc_bv<4> > S_AXI_ACP_ARLEN;
  sc_core::sc_in< sc_dt::sc_bv<4> > S_AXI_ACP_ARQOS;
  sc_core::sc_in< sc_dt::sc_bv<4> > S_AXI_ACP_AWCACHE;
  sc_core::sc_in< sc_dt::sc_bv<4> > S_AXI_ACP_AWLEN;
  sc_core::sc_in< sc_dt::sc_bv<4> > S_AXI_ACP_AWQOS;
  sc_core::sc_in< sc_dt::sc_bv<2> > S_AXI_ACP_ARBURST;
  sc_core::sc_in< sc_dt::sc_bv<2> > S_AXI_ACP_ARLOCK;
  sc_core::sc_in< sc_dt::sc_bv<3> > S_AXI_ACP_ARSIZE;
  sc_core::sc_in< sc_dt::sc_bv<2> > S_AXI_ACP_AWBURST;
  sc_core::sc_in< sc_dt::sc_bv<2> > S_AXI_ACP_AWLOCK;
  sc_core::sc_in< sc_dt::sc_bv<3> > S_AXI_ACP_AWSIZE;
  sc_core::sc_in< sc_dt::sc_bv<5> > S_AXI_ACP_ARUSER;
  sc_core::sc_in< sc_dt::sc_bv<5> > S_AXI_ACP_AWUSER;
  sc_core::sc_in< sc_dt::sc_bv<64> > S_AXI_ACP_WDATA;
  sc_core::sc_in< sc_dt::sc_bv<8> > S_AXI_ACP_WSTRB;
  sc_core::sc_out< bool > S_AXI_HP0_ARREADY;
  sc_core::sc_out< bool > S_AXI_HP0_AWREADY;
  sc_core::sc_out< bool > S_AXI_HP0_BVALID;
  sc_core::sc_out< bool > S_AXI_HP0_RLAST;
  sc_core::sc_out< bool > S_AXI_HP0_RVALID;
  sc_core::sc_out< bool > S_AXI_HP0_WREADY;
  sc_core::sc_out< sc_dt::sc_bv<2> > S_AXI_HP0_BRESP;
  sc_core::sc_out< sc_dt::sc_bv<2> > S_AXI_HP0_RRESP;
  sc_core::sc_out< sc_dt::sc_bv<6> > S_AXI_HP0_BID;
  sc_core::sc_out< sc_dt::sc_bv<6> > S_AXI_HP0_RID;
  sc_core::sc_out< sc_dt::sc_bv<64> > S_AXI_HP0_RDATA;
  sc_core::sc_out< sc_dt::sc_bv<8> > S_AXI_HP0_RCOUNT;
  sc_core::sc_out< sc_dt::sc_bv<8> > S_AXI_HP0_WCOUNT;
  sc_core::sc_out< sc_dt::sc_bv<3> > S_AXI_HP0_RACOUNT;
  sc_core::sc_out< sc_dt::sc_bv<6> > S_AXI_HP0_WACOUNT;
  sc_core::sc_in< bool > S_AXI_HP0_ACLK;
  sc_core::sc_in< bool > S_AXI_HP0_ARVALID;
  sc_core::sc_in< bool > S_AXI_HP0_AWVALID;
  sc_core::sc_in< bool > S_AXI_HP0_BREADY;
  sc_core::sc_in< bool > S_AXI_HP0_RDISSUECAP1_EN;
  sc_core::sc_in< bool > S_AXI_HP0_RREADY;
  sc_core::sc_in< bool > S_AXI_HP0_WLAST;
  sc_core::sc_in< bool > S_AXI_HP0_WRISSUECAP1_EN;
  sc_core::sc_in< bool > S_AXI_HP0_WVALID;
  sc_core::sc_in< sc_dt::sc_bv<2> > S_AXI_HP0_ARBURST;
  sc_core::sc_in< sc_dt::sc_bv<2> > S_AXI_HP0_ARLOCK;
  sc_core::sc_in< sc_dt::sc_bv<3> > S_AXI_HP0_ARSIZE;
  sc_core::sc_in< sc_dt::sc_bv<2> > S_AXI_HP0_AWBURST;
  sc_core::sc_in< sc_dt::sc_bv<2> > S_AXI_HP0_AWLOCK;
  sc_core::sc_in< sc_dt::sc_bv<3> > S_AXI_HP0_AWSIZE;
  sc_core::sc_in< sc_dt::sc_bv<3> > S_AXI_HP0_ARPROT;
  sc_core::sc_in< sc_dt::sc_bv<3> > S_AXI_HP0_AWPROT;
  sc_core::sc_in< sc_dt::sc_bv<32> > S_AXI_HP0_ARADDR;
  sc_core::sc_in< sc_dt::sc_bv<32> > S_AXI_HP0_AWADDR;
  sc_core::sc_in< sc_dt::sc_bv<4> > S_AXI_HP0_ARCACHE;
  sc_core::sc_in< sc_dt::sc_bv<4> > S_AXI_HP0_ARLEN;
  sc_core::sc_in< sc_dt::sc_bv<4> > S_AXI_HP0_ARQOS;
  sc_core::sc_in< sc_dt::sc_bv<4> > S_AXI_HP0_AWCACHE;
  sc_core::sc_in< sc_dt::sc_bv<4> > S_AXI_HP0_AWLEN;
  sc_core::sc_in< sc_dt::sc_bv<4> > S_AXI_HP0_AWQOS;
  sc_core::sc_in< sc_dt::sc_bv<6> > S_AXI_HP0_ARID;
  sc_core::sc_in< sc_dt::sc_bv<6> > S_AXI_HP0_AWID;
  sc_core::sc_in< sc_dt::sc_bv<6> > S_AXI_HP0_WID;
  sc_core::sc_in< sc_dt::sc_bv<64> > S_AXI_HP0_WDATA;
  sc_core::sc_in< sc_dt::sc_bv<8> > S_AXI_HP0_WSTRB;
  sc_core::sc_out< bool > S_AXI_HP1_ARREADY;
  sc_core::sc_out< bool > S_AXI_HP1_AWREADY;
  sc_core::sc_out< bool > S_AXI_HP1_BVALID;
  sc_core::sc_out< bool > S_AXI_HP1_RLAST;
  sc_core::sc_out< bool > S_AXI_HP1_RVALID;
  sc_core::sc_out< bool > S_AXI_HP1_WREADY;
  sc_core::sc_out< sc_dt::sc_bv<2> > S_AXI_HP1_BRESP;
  sc_core::sc_out< sc_dt::sc_bv<2> > S_AXI_HP1_RRESP;
  sc_core::sc_out< sc_dt::sc_bv<6> > S_AXI_HP1_BID;
  sc_core::sc_out< sc_dt::sc_bv<6> > S_AXI_HP1_RID;
  sc_core::sc_out< sc_dt::sc_bv<64> > S_AXI_HP1_RDATA;
  sc_core::sc_out< sc_dt::sc_bv<8> > S_AXI_HP1_RCOUNT;
  sc_core::sc_out< sc_dt::sc_bv<8> > S_AXI_HP1_WCOUNT;
  sc_core::sc_out< sc_dt::sc_bv<3> > S_AXI_HP1_RACOUNT;
  sc_core::sc_out< sc_dt::sc_bv<6> > S_AXI_HP1_WACOUNT;
  sc_core::sc_in< bool > S_AXI_HP1_ACLK;
  sc_core::sc_in< bool > S_AXI_HP1_ARVALID;
  sc_core::sc_in< bool > S_AXI_HP1_AWVALID;
  sc_core::sc_in< bool > S_AXI_HP1_BREADY;
  sc_core::sc_in< bool > S_AXI_HP1_RDISSUECAP1_EN;
  sc_core::sc_in< bool > S_AXI_HP1_RREADY;
  sc_core::sc_in< bool > S_AXI_HP1_WLAST;
  sc_core::sc_in< bool > S_AXI_HP1_WRISSUECAP1_EN;
  sc_core::sc_in< bool > S_AXI_HP1_WVALID;
  sc_core::sc_in< sc_dt::sc_bv<2> > S_AXI_HP1_ARBURST;
  sc_core::sc_in< sc_dt::sc_bv<2> > S_AXI_HP1_ARLOCK;
  sc_core::sc_in< sc_dt::sc_bv<3> > S_AXI_HP1_ARSIZE;
  sc_core::sc_in< sc_dt::sc_bv<2> > S_AXI_HP1_AWBURST;
  sc_core::sc_in< sc_dt::sc_bv<2> > S_AXI_HP1_AWLOCK;
  sc_core::sc_in< sc_dt::sc_bv<3> > S_AXI_HP1_AWSIZE;
  sc_core::sc_in< sc_dt::sc_bv<3> > S_AXI_HP1_ARPROT;
  sc_core::sc_in< sc_dt::sc_bv<3> > S_AXI_HP1_AWPROT;
  sc_core::sc_in< sc_dt::sc_bv<32> > S_AXI_HP1_ARADDR;
  sc_core::sc_in< sc_dt::sc_bv<32> > S_AXI_HP1_AWADDR;
  sc_core::sc_in< sc_dt::sc_bv<4> > S_AXI_HP1_ARCACHE;
  sc_core::sc_in< sc_dt::sc_bv<4> > S_AXI_HP1_ARLEN;
  sc_core::sc_in< sc_dt::sc_bv<4> > S_AXI_HP1_ARQOS;
  sc_core::sc_in< sc_dt::sc_bv<4> > S_AXI_HP1_AWCACHE;
  sc_core::sc_in< sc_dt::sc_bv<4> > S_AXI_HP1_AWLEN;
  sc_core::sc_in< sc_dt::sc_bv<4> > S_AXI_HP1_AWQOS;
  sc_core::sc_in< sc_dt::sc_bv<6> > S_AXI_HP1_ARID;
  sc_core::sc_in< sc_dt::sc_bv<6> > S_AXI_HP1_AWID;
  sc_core::sc_in< sc_dt::sc_bv<6> > S_AXI_HP1_WID;
  sc_core::sc_in< sc_dt::sc_bv<64> > S_AXI_HP1_WDATA;
  sc_core::sc_in< sc_dt::sc_bv<8> > S_AXI_HP1_WSTRB;
  sc_core::sc_in< sc_dt::sc_bv<2> > IRQ_F2P;
  sc_core::sc_out< sc_dt::sc_bv<2> > DMA0_DATYPE;
  sc_core::sc_out< bool > DMA0_DAVALID;
  sc_core::sc_out< bool > DMA0_DRREADY;
  sc_core::sc_in< bool > DMA0_ACLK;
  sc_core::sc_in< bool > DMA0_DAREADY;
  sc_core::sc_in< bool > DMA0_DRLAST;
  sc_core::sc_in< bool > DMA0_DRVALID;
  sc_core::sc_in< sc_dt::sc_bv<2> > DMA0_DRTYPE;
  sc_core::sc_out< bool > FCLK_CLK0;
  sc_core::sc_out< bool > FCLK_CLK1;
  sc_core::sc_out< bool > FCLK_CLK2;
  sc_core::sc_out< bool > FCLK_CLK3;
  sc_core::sc_out< bool > FCLK_RESET0_N;
  sc_core::sc_out< bool > FCLK_RESET1_N;
  sc_core::sc_out< bool > FCLK_RESET2_N;
  sc_core::sc_out< bool > FCLK_RESET3_N;
  sc_core::sc_in< sc_dt::sc_bv<32> > FTMT_F2P_DEBUG;
  sc_core::sc_out< sc_dt::sc_bv<32> > FTMT_P2F_DEBUG;
  sc_core::sc_out< sc_dt::sc_bv<54> > MIO;
  sc_core::sc_out< bool > DDR_CAS_n;
  sc_core::sc_out< bool > DDR_CKE;
  sc_core::sc_out< bool > DDR_Clk_n;
  sc_core::sc_out< bool > DDR_Clk;
  sc_core::sc_out< bool > DDR_CS_n;
  sc_core::sc_out< bool > DDR_DRSTB;
  sc_core::sc_out< bool > DDR_ODT;
  sc_core::sc_out< bool > DDR_RAS_n;
  sc_core::sc_out< bool > DDR_WEB;
  sc_core::sc_out< sc_dt::sc_bv<3> > DDR_BankAddr;
  sc_core::sc_out< sc_dt::sc_bv<15> > DDR_Addr;
  sc_core::sc_out< bool > DDR_VRN;
  sc_core::sc_out< bool > DDR_VRP;
  sc_core::sc_out< sc_dt::sc_bv<4> > DDR_DM;
  sc_core::sc_out< sc_dt::sc_bv<32> > DDR_DQ;
  sc_core::sc_out< sc_dt::sc_bv<4> > DDR_DQS_n;
  sc_core::sc_out< sc_dt::sc_bv<4> > DDR_DQS;
  sc_core::sc_out< bool > PS_SRSTB;
  sc_core::sc_out< bool > PS_CLK;
  sc_core::sc_out< bool > PS_PORB;

  // Dummy Signals for IP Ports


protected:

  virtual void before_end_of_elaboration();

private:

  xtlm::xaxis_pin2xtlm_t<1,2,1,1,1,1>* mp_DMA0_REQ_transactor;
  sc_signal< bool > m_DMA0_REQ_transactor_rst_signal;
  xtlm::xaxis_xtlm2pin_t<1,2,1,1,1,1>* mp_DMA0_ACK_transactor;
  sc_signal< bool > m_DMA0_ACK_transactor_rst_signal;
  xtlm::xaximm_xtlm2pin_t<32,32,12,1,1,1,1,1>* mp_M_AXI_GP0_transactor;
  xsc::common::scalar2vectorN_converter<2>* mp_M_AXI_GP0_ARLOCK_converter;
  sc_signal< bool > m_M_AXI_GP0_ARLOCK_converter_signal;
  xsc::common::scalar2vectorN_converter<2>* mp_M_AXI_GP0_AWLOCK_converter;
  sc_signal< bool > m_M_AXI_GP0_AWLOCK_converter_signal;
  xsc::common::vector2vector_converter<8,4>* mp_M_AXI_GP0_ARLEN_converter;
  sc_signal< sc_bv<8> > m_M_AXI_GP0_ARLEN_converter_signal;
  xsc::common::vector2vector_converter<8,4>* mp_M_AXI_GP0_AWLEN_converter;
  sc_signal< sc_bv<8> > m_M_AXI_GP0_AWLEN_converter_signal;
  sc_signal< bool > m_M_AXI_GP0_transactor_rst_signal;
  xtlm::xaximm_xtlm2pin_t<32,32,12,1,1,1,1,1>* mp_M_AXI_GP1_transactor;
  xsc::common::scalar2vectorN_converter<2>* mp_M_AXI_GP1_ARLOCK_converter;
  sc_signal< bool > m_M_AXI_GP1_ARLOCK_converter_signal;
  xsc::common::scalar2vectorN_converter<2>* mp_M_AXI_GP1_AWLOCK_converter;
  sc_signal< bool > m_M_AXI_GP1_AWLOCK_converter_signal;
  xsc::common::vector2vector_converter<8,4>* mp_M_AXI_GP1_ARLEN_converter;
  sc_signal< sc_bv<8> > m_M_AXI_GP1_ARLEN_converter_signal;
  xsc::common::vector2vector_converter<8,4>* mp_M_AXI_GP1_AWLEN_converter;
  sc_signal< sc_bv<8> > m_M_AXI_GP1_AWLEN_converter_signal;
  sc_signal< bool > m_M_AXI_GP1_transactor_rst_signal;
  xtlm::xaximm_pin2xtlm_t<64,32,3,5,1,1,5,1>* mp_S_AXI_ACP_transactor;
  xsc::common::vector2vector_converter<4,8>* mp_S_AXI_ACP_ARLEN_converter;
  sc_signal< sc_bv<8> > m_S_AXI_ACP_ARLEN_converter_signal;
  xsc::common::vector2vector_converter<4,8>* mp_S_AXI_ACP_AWLEN_converter;
  sc_signal< sc_bv<8> > m_S_AXI_ACP_AWLEN_converter_signal;
  xsc::common::vectorN2scalar_converter<2>* mp_S_AXI_ACP_ARLOCK_converter;
  sc_signal< bool > m_S_AXI_ACP_ARLOCK_converter_signal;
  xsc::common::vectorN2scalar_converter<2>* mp_S_AXI_ACP_AWLOCK_converter;
  sc_signal< bool > m_S_AXI_ACP_AWLOCK_converter_signal;
  sc_signal< bool > m_S_AXI_ACP_transactor_rst_signal;
  xtlm::xaximm_pin2xtlm_t<32,32,6,1,1,1,1,1>* mp_S_AXI_GP0_transactor;
  xsc::common::vectorN2scalar_converter<2>* mp_S_AXI_GP0_ARLOCK_converter;
  sc_signal< bool > m_S_AXI_GP0_ARLOCK_converter_signal;
  xsc::common::vectorN2scalar_converter<2>* mp_S_AXI_GP0_AWLOCK_converter;
  sc_signal< bool > m_S_AXI_GP0_AWLOCK_converter_signal;
  xsc::common::vector2vector_converter<4,8>* mp_S_AXI_GP0_ARLEN_converter;
  sc_signal< sc_bv<8> > m_S_AXI_GP0_ARLEN_converter_signal;
  xsc::common::vector2vector_converter<4,8>* mp_S_AXI_GP0_AWLEN_converter;
  sc_signal< sc_bv<8> > m_S_AXI_GP0_AWLEN_converter_signal;
  sc_signal< bool > m_S_AXI_GP0_transactor_rst_signal;
  xtlm::xaximm_pin2xtlm_t<32,32,6,1,1,1,1,1>* mp_S_AXI_GP1_transactor;
  xsc::common::vectorN2scalar_converter<2>* mp_S_AXI_GP1_ARLOCK_converter;
  sc_signal< bool > m_S_AXI_GP1_ARLOCK_converter_signal;
  xsc::common::vectorN2scalar_converter<2>* mp_S_AXI_GP1_AWLOCK_converter;
  sc_signal< bool > m_S_AXI_GP1_AWLOCK_converter_signal;
  xsc::common::vector2vector_converter<4,8>* mp_S_AXI_GP1_ARLEN_converter;
  sc_signal< sc_bv<8> > m_S_AXI_GP1_ARLEN_converter_signal;
  xsc::common::vector2vector_converter<4,8>* mp_S_AXI_GP1_AWLEN_converter;
  sc_signal< sc_bv<8> > m_S_AXI_GP1_AWLEN_converter_signal;
  sc_signal< bool > m_S_AXI_GP1_transactor_rst_signal;
  xtlm::xaximm_pin2xtlm_t<64,32,6,1,1,1,1,1>* mp_S_AXI_HP0_transactor;
  xsc::common::vectorN2scalar_converter<2>* mp_S_AXI_HP0_ARLOCK_converter;
  sc_signal< bool > m_S_AXI_HP0_ARLOCK_converter_signal;
  xsc::common::vectorN2scalar_converter<2>* mp_S_AXI_HP0_AWLOCK_converter;
  sc_signal< bool > m_S_AXI_HP0_AWLOCK_converter_signal;
  xsc::common::vector2vector_converter<4,8>* mp_S_AXI_HP0_ARLEN_converter;
  sc_signal< sc_bv<8> > m_S_AXI_HP0_ARLEN_converter_signal;
  xsc::common::vector2vector_converter<4,8>* mp_S_AXI_HP0_AWLEN_converter;
  sc_signal< sc_bv<8> > m_S_AXI_HP0_AWLEN_converter_signal;
  sc_signal< bool > m_S_AXI_HP0_transactor_rst_signal;
  xtlm::xaximm_pin2xtlm_t<64,32,6,1,1,1,1,1>* mp_S_AXI_HP1_transactor;
  xsc::common::vectorN2scalar_converter<2>* mp_S_AXI_HP1_ARLOCK_converter;
  sc_signal< bool > m_S_AXI_HP1_ARLOCK_converter_signal;
  xsc::common::vectorN2scalar_converter<2>* mp_S_AXI_HP1_AWLOCK_converter;
  sc_signal< bool > m_S_AXI_HP1_AWLOCK_converter_signal;
  xsc::common::vector2vector_converter<4,8>* mp_S_AXI_HP1_ARLEN_converter;
  sc_signal< sc_bv<8> > m_S_AXI_HP1_ARLEN_converter_signal;
  xsc::common::vector2vector_converter<4,8>* mp_S_AXI_HP1_AWLEN_converter;
  sc_signal< sc_bv<8> > m_S_AXI_HP1_AWLEN_converter_signal;
  sc_signal< bool > m_S_AXI_HP1_transactor_rst_signal;

  // Transactor stubs
  xtlm::xtlm_aximm_initiator_stub * M_AXI_GP0_transactor_initiator_rd_socket_stub;
  xtlm::xtlm_aximm_initiator_stub * M_AXI_GP0_transactor_initiator_wr_socket_stub;
  xtlm::xtlm_aximm_initiator_stub * M_AXI_GP1_transactor_initiator_rd_socket_stub;
  xtlm::xtlm_aximm_initiator_stub * M_AXI_GP1_transactor_initiator_wr_socket_stub;
  xtlm::xtlm_aximm_target_stub * S_AXI_ACP_transactor_target_rd_socket_stub;
  xtlm::xtlm_aximm_target_stub * S_AXI_ACP_transactor_target_wr_socket_stub;
  xtlm::xtlm_aximm_target_stub * S_AXI_GP0_transactor_target_rd_socket_stub;
  xtlm::xtlm_aximm_target_stub * S_AXI_GP0_transactor_target_wr_socket_stub;
  xtlm::xtlm_aximm_target_stub * S_AXI_GP1_transactor_target_rd_socket_stub;
  xtlm::xtlm_aximm_target_stub * S_AXI_GP1_transactor_target_wr_socket_stub;
  xtlm::xtlm_aximm_target_stub * S_AXI_HP0_transactor_target_rd_socket_stub;
  xtlm::xtlm_aximm_target_stub * S_AXI_HP0_transactor_target_wr_socket_stub;
  xtlm::xtlm_aximm_target_stub * S_AXI_HP1_transactor_target_rd_socket_stub;
  xtlm::xtlm_aximm_target_stub * S_AXI_HP1_transactor_target_wr_socket_stub;
  xtlm::xtlm_axis_initiator_stub * DMA0_ACK_transactor_initiator_socket_stub;
  xtlm::xtlm_axis_target_stub * DMA0_REQ_transactor_target_socket_stub;

  // Socket stubs

};
#endif // MTI_SYSTEMC
#endif // IP_DESIGN_1_PROCESSING_SYSTEM7_0_0_H_
