cropinghigh/zynq_a9_mb/software/FPGA_VIVADO/Platform/Platform.ip_user_files/mem_init_files/design_1_smartconnect_1_0.h

#ifndef IP_DESIGN_1_SMARTCONNECT_1_0_H_
#define IP_DESIGN_1_SMARTCONNECT_1_0_H_

// (c) Copyright 1995-2025 Xilinx, Inc. All rights reserved.
// 
// This file contains confidential and proprietary information
// of Xilinx, Inc. and is protected under U.S. and
// international copyright and other intellectual property
// laws.
// 
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
// CRITICAL APPLICATIONS
// Xilinx products are not designed or intended to be fail-
// safe, or for use in any application requiring fail-safe
// performance, such as life-support or safety devices or
// systems, Class III medical devices, nuclear facilities,
// applications related to the deployment of airbags, or any
// other applications that could lead to death, personal
// injury, or severe property or environmental damage
// (individually and collectively, "Critical
// Applications"). Customer assumes the sole risk and
// liability of any use of Xilinx products in Critical
// Applications, subject only to applicable laws and
// regulations governing limitations on product liability.
// 
// THIS COPYRIGHT NOTICE AND DISCLAIMER MUST BE RETAINED AS
// PART OF THIS FILE AT ALL TIMES.
// 
// DO NOT MODIFY THIS FILE.


#ifndef XTLM
#include "xtlm.h"
#endif
#ifndef SYSTEMC_INCLUDED
#include <systemc>
#endif

#if defined(_MSC_VER)
#define DllExport __declspec(dllexport)
#elif defined(__GNUC__)
#define DllExport __attribute__ ((visibility("default")))
#else
#define DllExport
#endif

#include "design_1_smartconnect_1_0_sc.h"




#ifdef XILINX_SIMULATOR
class DllExport design_1_smartconnect_1_0 : public design_1_smartconnect_1_0_sc
{
public:

  design_1_smartconnect_1_0(const sc_core::sc_module_name& nm);
  virtual ~design_1_smartconnect_1_0();

  // module pin-to-pin RTL interface

  sc_core::sc_in< bool > aclk;
  sc_core::sc_in< bool > aresetn;
  sc_core::sc_in< sc_dt::sc_bv<12> > S00_AXI_awid;
  sc_core::sc_in< sc_dt::sc_bv<32> > S00_AXI_awaddr;
  sc_core::sc_in< sc_dt::sc_bv<4> > S00_AXI_awlen;
  sc_core::sc_in< sc_dt::sc_bv<3> > S00_AXI_awsize;
  sc_core::sc_in< sc_dt::sc_bv<2> > S00_AXI_awburst;
  sc_core::sc_in< sc_dt::sc_bv<2> > S00_AXI_awlock;
  sc_core::sc_in< sc_dt::sc_bv<4> > S00_AXI_awcache;
  sc_core::sc_in< sc_dt::sc_bv<3> > S00_AXI_awprot;
  sc_core::sc_in< sc_dt::sc_bv<4> > S00_AXI_awqos;
  sc_core::sc_in< bool > S00_AXI_awvalid;
  sc_core::sc_out< bool > S00_AXI_awready;
  sc_core::sc_in< sc_dt::sc_bv<12> > S00_AXI_wid;
  sc_core::sc_in< sc_dt::sc_bv<32> > S00_AXI_wdata;
  sc_core::sc_in< sc_dt::sc_bv<4> > S00_AXI_wstrb;
  sc_core::sc_in< bool > S00_AXI_wlast;
  sc_core::sc_in< bool > S00_AXI_wvalid;
  sc_core::sc_out< bool > S00_AXI_wready;
  sc_core::sc_out< sc_dt::sc_bv<12> > S00_AXI_bid;
  sc_core::sc_out< sc_dt::sc_bv<2> > S00_AXI_bresp;
  sc_core::sc_out< bool > S00_AXI_bvalid;
  sc_core::sc_in< bool > S00_AXI_bready;
  sc_core::sc_in< sc_dt::sc_bv<12> > S00_AXI_arid;
  sc_core::sc_in< sc_dt::sc_bv<32> > S00_AXI_araddr;
  sc_core::sc_in< sc_dt::sc_bv<4> > S00_AXI_arlen;
  sc_core::sc_in< sc_dt::sc_bv<3> > S00_AXI_arsize;
  sc_core::sc_in< sc_dt::sc_bv<2> > S00_AXI_arburst;
  sc_core::sc_in< sc_dt::sc_bv<2> > S00_AXI_arlock;
  sc_core::sc_in< sc_dt::sc_bv<4> > S00_AXI_arcache;
  sc_core::sc_in< sc_dt::sc_bv<3> > S00_AXI_arprot;
  sc_core::sc_in< sc_dt::sc_bv<4> > S00_AXI_arqos;
  sc_core::sc_in< bool > S00_AXI_arvalid;
  sc_core::sc_out< bool > S00_AXI_arready;
  sc_core::sc_out< sc_dt::sc_bv<12> > S00_AXI_rid;
  sc_core::sc_out< sc_dt::sc_bv<32> > S00_AXI_rdata;
  sc_core::sc_out< sc_dt::sc_bv<2> > S00_AXI_rresp;
  sc_core::sc_out< bool > S00_AXI_rlast;
  sc_core::sc_out< bool > S00_AXI_rvalid;
  sc_core::sc_in< bool > S00_AXI_rready;
  sc_core::sc_out< sc_dt::sc_bv<9> > M00_AXI_awaddr;
  sc_core::sc_out< sc_dt::sc_bv<3> > M00_AXI_awprot;
  sc_core::sc_out< bool > M00_AXI_awvalid;
  sc_core::sc_in< bool > M00_AXI_awready;
  sc_core::sc_out< sc_dt::sc_bv<32> > M00_AXI_wdata;
  sc_core::sc_out< sc_dt::sc_bv<4> > M00_AXI_wstrb;
  sc_core::sc_out< bool > M00_AXI_wvalid;
  sc_core::sc_in< bool > M00_AXI_wready;
  sc_core::sc_in< sc_dt::sc_bv<2> > M00_AXI_bresp;
  sc_core::sc_in< bool > M00_AXI_bvalid;
  sc_core::sc_out< bool > M00_AXI_bready;
  sc_core::sc_out< sc_dt::sc_bv<9> > M00_AXI_araddr;
  sc_core::sc_out< sc_dt::sc_bv<3> > M00_AXI_arprot;
  sc_core::sc_out< bool > M00_AXI_arvalid;
  sc_core::sc_in< bool > M00_AXI_arready;
  sc_core::sc_in< sc_dt::sc_bv<32> > M00_AXI_rdata;
  sc_core::sc_in< sc_dt::sc_bv<2> > M00_AXI_rresp;
  sc_core::sc_in< bool > M00_AXI_rvalid;
  sc_core::sc_out< bool > M00_AXI_rready;
  sc_core::sc_out< sc_dt::sc_bv<6> > M01_AXI_awaddr;
  sc_core::sc_out< sc_dt::sc_bv<3> > M01_AXI_awprot;
  sc_core::sc_out< bool > M01_AXI_awvalid;
  sc_core::sc_in< bool > M01_AXI_awready;
  sc_core::sc_out< sc_dt::sc_bv<32> > M01_AXI_wdata;
  sc_core::sc_out< sc_dt::sc_bv<4> > M01_AXI_wstrb;
  sc_core::sc_out< bool > M01_AXI_wvalid;
  sc_core::sc_in< bool > M01_AXI_wready;
  sc_core::sc_in< sc_dt::sc_bv<2> > M01_AXI_bresp;
  sc_core::sc_in< bool > M01_AXI_bvalid;
  sc_core::sc_out< bool > M01_AXI_bready;
  sc_core::sc_out< sc_dt::sc_bv<6> > M01_AXI_araddr;
  sc_core::sc_out< sc_dt::sc_bv<3> > M01_AXI_arprot;
  sc_core::sc_out< bool > M01_AXI_arvalid;
  sc_core::sc_in< bool > M01_AXI_arready;
  sc_core::sc_in< sc_dt::sc_bv<32> > M01_AXI_rdata;
  sc_core::sc_in< sc_dt::sc_bv<2> > M01_AXI_rresp;
  sc_core::sc_in< bool > M01_AXI_rvalid;
  sc_core::sc_out< bool > M01_AXI_rready;
  sc_core::sc_out< sc_dt::sc_bv<9> > M02_AXI_awaddr;
  sc_core::sc_out< sc_dt::sc_bv<3> > M02_AXI_awprot;
  sc_core::sc_out< bool > M02_AXI_awvalid;
  sc_core::sc_in< bool > M02_AXI_awready;
  sc_core::sc_out< sc_dt::sc_bv<32> > M02_AXI_wdata;
  sc_core::sc_out< sc_dt::sc_bv<4> > M02_AXI_wstrb;
  sc_core::sc_out< bool > M02_AXI_wvalid;
  sc_core::sc_in< bool > M02_AXI_wready;
  sc_core::sc_in< sc_dt::sc_bv<2> > M02_AXI_bresp;
  sc_core::sc_in< bool > M02_AXI_bvalid;
  sc_core::sc_out< bool > M02_AXI_bready;
  sc_core::sc_out< sc_dt::sc_bv<9> > M02_AXI_araddr;
  sc_core::sc_out< sc_dt::sc_bv<3> > M02_AXI_arprot;
  sc_core::sc_out< bool > M02_AXI_arvalid;
  sc_core::sc_in< bool > M02_AXI_arready;
  sc_core::sc_in< sc_dt::sc_bv<32> > M02_AXI_rdata;
  sc_core::sc_in< sc_dt::sc_bv<2> > M02_AXI_rresp;
  sc_core::sc_in< bool > M02_AXI_rvalid;
  sc_core::sc_out< bool > M02_AXI_rready;
  sc_core::sc_out< sc_dt::sc_bv<8> > M03_AXI_awaddr;
  sc_core::sc_out< sc_dt::sc_bv<3> > M03_AXI_awprot;
  sc_core::sc_out< bool > M03_AXI_awvalid;
  sc_core::sc_in< bool > M03_AXI_awready;
  sc_core::sc_out< sc_dt::sc_bv<32> > M03_AXI_wdata;
  sc_core::sc_out< sc_dt::sc_bv<4> > M03_AXI_wstrb;
  sc_core::sc_out< bool > M03_AXI_wvalid;
  sc_core::sc_in< bool > M03_AXI_wready;
  sc_core::sc_in< sc_dt::sc_bv<2> > M03_AXI_bresp;
  sc_core::sc_in< bool > M03_AXI_bvalid;
  sc_core::sc_out< bool > M03_AXI_bready;
  sc_core::sc_out< sc_dt::sc_bv<8> > M03_AXI_araddr;
  sc_core::sc_out< sc_dt::sc_bv<3> > M03_AXI_arprot;
  sc_core::sc_out< bool > M03_AXI_arvalid;
  sc_core::sc_in< bool > M03_AXI_arready;
  sc_core::sc_in< sc_dt::sc_bv<32> > M03_AXI_rdata;
  sc_core::sc_in< sc_dt::sc_bv<2> > M03_AXI_rresp;
  sc_core::sc_in< bool > M03_AXI_rvalid;
  sc_core::sc_out< bool > M03_AXI_rready;
  sc_core::sc_out< sc_dt::sc_bv<7> > M04_AXI_awaddr;
  sc_core::sc_out< sc_dt::sc_bv<3> > M04_AXI_awprot;
  sc_core::sc_out< bool > M04_AXI_awvalid;
  sc_core::sc_in< bool > M04_AXI_awready;
  sc_core::sc_out< sc_dt::sc_bv<32> > M04_AXI_wdata;
  sc_core::sc_out< sc_dt::sc_bv<4> > M04_AXI_wstrb;
  sc_core::sc_out< bool > M04_AXI_wvalid;
  sc_core::sc_in< bool > M04_AXI_wready;
  sc_core::sc_in< sc_dt::sc_bv<2> > M04_AXI_bresp;
  sc_core::sc_in< bool > M04_AXI_bvalid;
  sc_core::sc_out< bool > M04_AXI_bready;
  sc_core::sc_out< sc_dt::sc_bv<7> > M04_AXI_araddr;
  sc_core::sc_out< sc_dt::sc_bv<3> > M04_AXI_arprot;
  sc_core::sc_out< bool > M04_AXI_arvalid;
  sc_core::sc_in< bool > M04_AXI_arready;
  sc_core::sc_in< sc_dt::sc_bv<32> > M04_AXI_rdata;
  sc_core::sc_in< sc_dt::sc_bv<2> > M04_AXI_rresp;
  sc_core::sc_in< bool > M04_AXI_rvalid;
  sc_core::sc_out< bool > M04_AXI_rready;
  sc_core::sc_out< bool > M05_AXI_awid;
  sc_core::sc_out< bool > M05_AXI_awaddr;
  sc_core::sc_out< bool > M05_AXI_awlen;
  sc_core::sc_out< sc_dt::sc_bv<3> > M05_AXI_awsize;
  sc_core::sc_out< sc_dt::sc_bv<2> > M05_AXI_awburst;
  sc_core::sc_out< bool > M05_AXI_awlock;
  sc_core::sc_out< sc_dt::sc_bv<4> > M05_AXI_awcache;
  sc_core::sc_out< sc_dt::sc_bv<3> > M05_AXI_awprot;
  sc_core::sc_out< sc_dt::sc_bv<4> > M05_AXI_awregion;
  sc_core::sc_out< sc_dt::sc_bv<4> > M05_AXI_awqos;
  sc_core::sc_out< bool > M05_AXI_awuser;
  sc_core::sc_out< sc_dt::sc_bv<1> > M05_AXI_awvalid;
  sc_core::sc_in< sc_dt::sc_bv<1> > M05_AXI_awready;
  sc_core::sc_out< bool > M05_AXI_wid;
  sc_core::sc_out< bool > M05_AXI_wdata;
  sc_core::sc_out< bool > M05_AXI_wstrb;
  sc_core::sc_out< sc_dt::sc_bv<1> > M05_AXI_wlast;
  sc_core::sc_out< bool > M05_AXI_wuser;
  sc_core::sc_out< sc_dt::sc_bv<1> > M05_AXI_wvalid;
  sc_core::sc_in< sc_dt::sc_bv<1> > M05_AXI_wready;
  sc_core::sc_in< bool > M05_AXI_bid;
  sc_core::sc_in< sc_dt::sc_bv<2> > M05_AXI_bresp;
  sc_core::sc_in< bool > M05_AXI_buser;
  sc_core::sc_in< sc_dt::sc_bv<1> > M05_AXI_bvalid;
  sc_core::sc_out< sc_dt::sc_bv<1> > M05_AXI_bready;
  sc_core::sc_out< bool > M05_AXI_arid;
  sc_core::sc_out< bool > M05_AXI_araddr;
  sc_core::sc_out< bool > M05_AXI_arlen;
  sc_core::sc_out< sc_dt::sc_bv<3> > M05_AXI_arsize;
  sc_core::sc_out< sc_dt::sc_bv<2> > M05_AXI_arburst;
  sc_core::sc_out< bool > M05_AXI_arlock;
  sc_core::sc_out< sc_dt::sc_bv<4> > M05_AXI_arcache;
  sc_core::sc_out< sc_dt::sc_bv<3> > M05_AXI_arprot;
  sc_core::sc_out< sc_dt::sc_bv<4> > M05_AXI_arregion;
  sc_core::sc_out< sc_dt::sc_bv<4> > M05_AXI_arqos;
  sc_core::sc_out< bool > M05_AXI_aruser;
  sc_core::sc_out< sc_dt::sc_bv<1> > M05_AXI_arvalid;
  sc_core::sc_in< sc_dt::sc_bv<1> > M05_AXI_arready;
  sc_core::sc_in< bool > M05_AXI_rid;
  sc_core::sc_in< bool > M05_AXI_rdata;
  sc_core::sc_in< sc_dt::sc_bv<2> > M05_AXI_rresp;
  sc_core::sc_in< sc_dt::sc_bv<1> > M05_AXI_rlast;
  sc_core::sc_in< bool > M05_AXI_ruser;
  sc_core::sc_in< sc_dt::sc_bv<1> > M05_AXI_rvalid;
  sc_core::sc_out< sc_dt::sc_bv<1> > M05_AXI_rready;
  sc_core::sc_out< bool > M06_AXI_awid;
  sc_core::sc_out< bool > M06_AXI_awaddr;
  sc_core::sc_out< bool > M06_AXI_awlen;
  sc_core::sc_out< sc_dt::sc_bv<3> > M06_AXI_awsize;
  sc_core::sc_out< sc_dt::sc_bv<2> > M06_AXI_awburst;
  sc_core::sc_out< bool > M06_AXI_awlock;
  sc_core::sc_out< sc_dt::sc_bv<4> > M06_AXI_awcache;
  sc_core::sc_out< sc_dt::sc_bv<3> > M06_AXI_awprot;
  sc_core::sc_out< sc_dt::sc_bv<4> > M06_AXI_awregion;
  sc_core::sc_out< sc_dt::sc_bv<4> > M06_AXI_awqos;
  sc_core::sc_out< bool > M06_AXI_awuser;
  sc_core::sc_out< sc_dt::sc_bv<1> > M06_AXI_awvalid;
  sc_core::sc_in< sc_dt::sc_bv<1> > M06_AXI_awready;
  sc_core::sc_out< bool > M06_AXI_wid;
  sc_core::sc_out< bool > M06_AXI_wdata;
  sc_core::sc_out< bool > M06_AXI_wstrb;
  sc_core::sc_out< sc_dt::sc_bv<1> > M06_AXI_wlast;
  sc_core::sc_out< bool > M06_AXI_wuser;
  sc_core::sc_out< sc_dt::sc_bv<1> > M06_AXI_wvalid;
  sc_core::sc_in< sc_dt::sc_bv<1> > M06_AXI_wready;
  sc_core::sc_in< bool > M06_AXI_bid;
  sc_core::sc_in< sc_dt::sc_bv<2> > M06_AXI_bresp;
  sc_core::sc_in< bool > M06_AXI_buser;
  sc_core::sc_in< sc_dt::sc_bv<1> > M06_AXI_bvalid;
  sc_core::sc_out< sc_dt::sc_bv<1> > M06_AXI_bready;
  sc_core::sc_out< bool > M06_AXI_arid;
  sc_core::sc_out< bool > M06_AXI_araddr;
  sc_core::sc_out< bool > M06_AXI_arlen;
  sc_core::sc_out< sc_dt::sc_bv<3> > M06_AXI_arsize;
  sc_core::sc_out< sc_dt::sc_bv<2> > M06_AXI_arburst;
  sc_core::sc_out< bool > M06_AXI_arlock;
  sc_core::sc_out< sc_dt::sc_bv<4> > M06_AXI_arcache;
  sc_core::sc_out< sc_dt::sc_bv<3> > M06_AXI_arprot;
  sc_core::sc_out< sc_dt::sc_bv<4> > M06_AXI_arregion;
  sc_core::sc_out< sc_dt::sc_bv<4> > M06_AXI_arqos;
  sc_core::sc_out< bool > M06_AXI_aruser;
  sc_core::sc_out< sc_dt::sc_bv<1> > M06_AXI_arvalid;
  sc_core::sc_in< sc_dt::sc_bv<1> > M06_AXI_arready;
  sc_core::sc_in< bool > M06_AXI_rid;
  sc_core::sc_in< bool > M06_AXI_rdata;
  sc_core::sc_in< sc_dt::sc_bv<2> > M06_AXI_rresp;
  sc_core::sc_in< sc_dt::sc_bv<1> > M06_AXI_rlast;
  sc_core::sc_in< bool > M06_AXI_ruser;
  sc_core::sc_in< sc_dt::sc_bv<1> > M06_AXI_rvalid;
  sc_core::sc_out< sc_dt::sc_bv<1> > M06_AXI_rready;
  sc_core::sc_out< bool > M07_AXI_awid;
  sc_core::sc_out< bool > M07_AXI_awaddr;
  sc_core::sc_out< bool > M07_AXI_awlen;
  sc_core::sc_out< sc_dt::sc_bv<3> > M07_AXI_awsize;
  sc_core::sc_out< sc_dt::sc_bv<2> > M07_AXI_awburst;
  sc_core::sc_out< bool > M07_AXI_awlock;
  sc_core::sc_out< sc_dt::sc_bv<4> > M07_AXI_awcache;
  sc_core::sc_out< sc_dt::sc_bv<3> > M07_AXI_awprot;
  sc_core::sc_out< sc_dt::sc_bv<4> > M07_AXI_awregion;
  sc_core::sc_out< sc_dt::sc_bv<4> > M07_AXI_awqos;
  sc_core::sc_out< bool > M07_AXI_awuser;
  sc_core::sc_out< sc_dt::sc_bv<1> > M07_AXI_awvalid;
  sc_core::sc_in< sc_dt::sc_bv<1> > M07_AXI_awready;
  sc_core::sc_out< bool > M07_AXI_wid;
  sc_core::sc_out< bool > M07_AXI_wdata;
  sc_core::sc_out< bool > M07_AXI_wstrb;
  sc_core::sc_out< sc_dt::sc_bv<1> > M07_AXI_wlast;
  sc_core::sc_out< bool > M07_AXI_wuser;
  sc_core::sc_out< sc_dt::sc_bv<1> > M07_AXI_wvalid;
  sc_core::sc_in< sc_dt::sc_bv<1> > M07_AXI_wready;
  sc_core::sc_in< bool > M07_AXI_bid;
  sc_core::sc_in< sc_dt::sc_bv<2> > M07_AXI_bresp;
  sc_core::sc_in< bool > M07_AXI_buser;
  sc_core::sc_in< sc_dt::sc_bv<1> > M07_AXI_bvalid;
  sc_core::sc_out< sc_dt::sc_bv<1> > M07_AXI_bready;
  sc_core::sc_out< bool > M07_AXI_arid;
  sc_core::sc_out< bool > M07_AXI_araddr;
  sc_core::sc_out< bool > M07_AXI_arlen;
  sc_core::sc_out< sc_dt::sc_bv<3> > M07_AXI_arsize;
  sc_core::sc_out< sc_dt::sc_bv<2> > M07_AXI_arburst;
  sc_core::sc_out< bool > M07_AXI_arlock;
  sc_core::sc_out< sc_dt::sc_bv<4> > M07_AXI_arcache;
  sc_core::sc_out< sc_dt::sc_bv<3> > M07_AXI_arprot;
  sc_core::sc_out< sc_dt::sc_bv<4> > M07_AXI_arregion;
  sc_core::sc_out< sc_dt::sc_bv<4> > M07_AXI_arqos;
  sc_core::sc_out< bool > M07_AXI_aruser;
  sc_core::sc_out< sc_dt::sc_bv<1> > M07_AXI_arvalid;
  sc_core::sc_in< sc_dt::sc_bv<1> > M07_AXI_arready;
  sc_core::sc_in< bool > M07_AXI_rid;
  sc_core::sc_in< bool > M07_AXI_rdata;
  sc_core::sc_in< sc_dt::sc_bv<2> > M07_AXI_rresp;
  sc_core::sc_in< sc_dt::sc_bv<1> > M07_AXI_rlast;
  sc_core::sc_in< bool > M07_AXI_ruser;
  sc_core::sc_in< sc_dt::sc_bv<1> > M07_AXI_rvalid;
  sc_core::sc_out< sc_dt::sc_bv<1> > M07_AXI_rready;
  sc_core::sc_out< bool > M08_AXI_awid;
  sc_core::sc_out< bool > M08_AXI_awaddr;
  sc_core::sc_out< bool > M08_AXI_awlen;
  sc_core::sc_out< sc_dt::sc_bv<3> > M08_AXI_awsize;
  sc_core::sc_out< sc_dt::sc_bv<2> > M08_AXI_awburst;
  sc_core::sc_out< bool > M08_AXI_awlock;
  sc_core::sc_out< sc_dt::sc_bv<4> > M08_AXI_awcache;
  sc_core::sc_out< sc_dt::sc_bv<3> > M08_AXI_awprot;
  sc_core::sc_out< sc_dt::sc_bv<4> > M08_AXI_awregion;
  sc_core::sc_out< sc_dt::sc_bv<4> > M08_AXI_awqos;
  sc_core::sc_out< bool > M08_AXI_awuser;
  sc_core::sc_out< sc_dt::sc_bv<1> > M08_AXI_awvalid;
  sc_core::sc_in< sc_dt::sc_bv<1> > M08_AXI_awready;
  sc_core::sc_out< bool > M08_AXI_wid;
  sc_core::sc_out< bool > M08_AXI_wdata;
  sc_core::sc_out< bool > M08_AXI_wstrb;
  sc_core::sc_out< sc_dt::sc_bv<1> > M08_AXI_wlast;
  sc_core::sc_out< bool > M08_AXI_wuser;
  sc_core::sc_out< sc_dt::sc_bv<1> > M08_AXI_wvalid;
  sc_core::sc_in< sc_dt::sc_bv<1> > M08_AXI_wready;
  sc_core::sc_in< bool > M08_AXI_bid;
  sc_core::sc_in< sc_dt::sc_bv<2> > M08_AXI_bresp;
  sc_core::sc_in< bool > M08_AXI_buser;
  sc_core::sc_in< sc_dt::sc_bv<1> > M08_AXI_bvalid;
  sc_core::sc_out< sc_dt::sc_bv<1> > M08_AXI_bready;
  sc_core::sc_out< bool > M08_AXI_arid;
  sc_core::sc_out< bool > M08_AXI_araddr;
  sc_core::sc_out< bool > M08_AXI_arlen;
  sc_core::sc_out< sc_dt::sc_bv<3> > M08_AXI_arsize;
  sc_core::sc_out< sc_dt::sc_bv<2> > M08_AXI_arburst;
  sc_core::sc_out< bool > M08_AXI_arlock;
  sc_core::sc_out< sc_dt::sc_bv<4> > M08_AXI_arcache;
  sc_core::sc_out< sc_dt::sc_bv<3> > M08_AXI_arprot;
  sc_core::sc_out< sc_dt::sc_bv<4> > M08_AXI_arregion;
  sc_core::sc_out< sc_dt::sc_bv<4> > M08_AXI_arqos;
  sc_core::sc_out< bool > M08_AXI_aruser;
  sc_core::sc_out< sc_dt::sc_bv<1> > M08_AXI_arvalid;
  sc_core::sc_in< sc_dt::sc_bv<1> > M08_AXI_arready;
  sc_core::sc_in< bool > M08_AXI_rid;
  sc_core::sc_in< bool > M08_AXI_rdata;
  sc_core::sc_in< sc_dt::sc_bv<2> > M08_AXI_rresp;
  sc_core::sc_in< sc_dt::sc_bv<1> > M08_AXI_rlast;
  sc_core::sc_in< bool > M08_AXI_ruser;
  sc_core::sc_in< sc_dt::sc_bv<1> > M08_AXI_rvalid;
  sc_core::sc_out< sc_dt::sc_bv<1> > M08_AXI_rready;

  // Dummy Signals for IP Ports


protected:

  virtual void before_end_of_elaboration();

private:

  xtlm::xaximm_pin2xtlm_t<32,32,12,1,1,1,1,1>* mp_S00_AXI_transactor;
  xsc::common::vector2vector_converter<4,8>* mp_S00_AXI_awlen_converter;
  sc_signal< sc_bv<8> > m_S00_AXI_awlen_converter_signal;
  xsc::common::vectorN2scalar_converter<2>* mp_S00_AXI_awlock_converter;
  sc_signal< bool > m_S00_AXI_awlock_converter_signal;
  xsc::common::vector2vector_converter<4,8>* mp_S00_AXI_arlen_converter;
  sc_signal< sc_bv<8> > m_S00_AXI_arlen_converter_signal;
  xsc::common::vectorN2scalar_converter<2>* mp_S00_AXI_arlock_converter;
  sc_signal< bool > m_S00_AXI_arlock_converter_signal;
  xtlm::xaximm_xtlm2pin_t<32,9,1,1,1,1,1,1>* mp_M00_AXI_transactor;
  xtlm::xaximm_xtlm2pin_t<32,6,1,1,1,1,1,1>* mp_M01_AXI_transactor;
  xtlm::xaximm_xtlm2pin_t<32,9,1,1,1,1,1,1>* mp_M02_AXI_transactor;
  xtlm::xaximm_xtlm2pin_t<32,8,1,1,1,1,1,1>* mp_M03_AXI_transactor;
  xtlm::xaximm_xtlm2pin_t<32,7,1,1,1,1,1,1>* mp_M04_AXI_transactor;
  xtlm::xaximm_xtlm2pin_t<32,32,1,1,1,1,1,1>* mp_M05_AXI_transactor;
  xsc::common::vectorN2scalar_converter<1>* mp_M05_AXI_awid_converter;
  sc_signal< sc_bv<1> > m_M05_AXI_awid_converter_signal;
  xsc::common::vectorN2scalar_converter<32>* mp_M05_AXI_awaddr_converter;
  sc_signal< sc_bv<1> > m_M05_AXI_awaddr_converter_signal;
  xsc::common::vectorN2scalar_converter<8>* mp_M05_AXI_awlen_converter;
  sc_signal< sc_bv<1> > m_M05_AXI_awlen_converter_signal;
  xsc::common::vectorN2scalar_converter<1>* mp_M05_AXI_awuser_converter;
  sc_signal< sc_bv<1> > m_M05_AXI_awuser_converter_signal;
  xsc::common::scalar2vectorN_converter<1>* mp_M05_AXI_awvalid_converter;
  sc_signal< bool > m_M05_AXI_awvalid_converter_signal;
  xsc::common::vectorN2scalar_converter<1>* mp_M05_AXI_awready_converter;
  sc_signal< bool > m_M05_AXI_awready_converter_signal;
  xsc::common::vectorN2scalar_converter<32>* mp_M05_AXI_wdata_converter;
  sc_signal< sc_bv<1> > m_M05_AXI_wdata_converter_signal;
  xsc::common::vectorN2scalar_converter<4>* mp_M05_AXI_wstrb_converter;
  sc_signal< sc_bv<1> > m_M05_AXI_wstrb_converter_signal;
  xsc::common::scalar2vectorN_converter<1>* mp_M05_AXI_wlast_converter;
  sc_signal< bool > m_M05_AXI_wlast_converter_signal;
  xsc::common::vectorN2scalar_converter<1>* mp_M05_AXI_wuser_converter;
  sc_signal< sc_bv<1> > m_M05_AXI_wuser_converter_signal;
  xsc::common::scalar2vectorN_converter<1>* mp_M05_AXI_wvalid_converter;
  sc_signal< bool > m_M05_AXI_wvalid_converter_signal;
  xsc::common::vectorN2scalar_converter<1>* mp_M05_AXI_wready_converter;
  sc_signal< bool > m_M05_AXI_wready_converter_signal;
  xsc::common::scalar2vectorN_converter<1>* mp_M05_AXI_bid_converter;
  sc_signal< sc_bv<1> > m_M05_AXI_bid_converter_signal;
  xsc::common::scalar2vectorN_converter<1>* mp_M05_AXI_buser_converter;
  sc_signal< sc_bv<1> > m_M05_AXI_buser_converter_signal;
  xsc::common::vectorN2scalar_converter<1>* mp_M05_AXI_bvalid_converter;
  sc_signal< bool > m_M05_AXI_bvalid_converter_signal;
  xsc::common::scalar2vectorN_converter<1>* mp_M05_AXI_bready_converter;
  sc_signal< bool > m_M05_AXI_bready_converter_signal;
  xsc::common::vectorN2scalar_converter<1>* mp_M05_AXI_arid_converter;
  sc_signal< sc_bv<1> > m_M05_AXI_arid_converter_signal;
  xsc::common::vectorN2scalar_converter<32>* mp_M05_AXI_araddr_converter;
  sc_signal< sc_bv<1> > m_M05_AXI_araddr_converter_signal;
  xsc::common::vectorN2scalar_converter<8>* mp_M05_AXI_arlen_converter;
  sc_signal< sc_bv<1> > m_M05_AXI_arlen_converter_signal;
  xsc::common::vectorN2scalar_converter<1>* mp_M05_AXI_aruser_converter;
  sc_signal< sc_bv<1> > m_M05_AXI_aruser_converter_signal;
  xsc::common::scalar2vectorN_converter<1>* mp_M05_AXI_arvalid_converter;
  sc_signal< bool > m_M05_AXI_arvalid_converter_signal;
  xsc::common::vectorN2scalar_converter<1>* mp_M05_AXI_arready_converter;
  sc_signal< bool > m_M05_AXI_arready_converter_signal;
  xsc::common::scalar2vectorN_converter<1>* mp_M05_AXI_rid_converter;
  sc_signal< sc_bv<1> > m_M05_AXI_rid_converter_signal;
  xsc::common::scalar2vectorN_converter<32>* mp_M05_AXI_rdata_converter;
  sc_signal< sc_bv<1> > m_M05_AXI_rdata_converter_signal;
  xsc::common::vectorN2scalar_converter<1>* mp_M05_AXI_rlast_converter;
  sc_signal< bool > m_M05_AXI_rlast_converter_signal;
  xsc::common::scalar2vectorN_converter<1>* mp_M05_AXI_ruser_converter;
  sc_signal< sc_bv<1> > m_M05_AXI_ruser_converter_signal;
  xsc::common::vectorN2scalar_converter<1>* mp_M05_AXI_rvalid_converter;
  sc_signal< bool > m_M05_AXI_rvalid_converter_signal;
  xsc::common::scalar2vectorN_converter<1>* mp_M05_AXI_rready_converter;
  sc_signal< bool > m_M05_AXI_rready_converter_signal;
  xtlm::xaximm_xtlm2pin_t<32,32,1,1,1,1,1,1>* mp_M06_AXI_transactor;
  xsc::common::vectorN2scalar_converter<1>* mp_M06_AXI_awid_converter;
  sc_signal< sc_bv<1> > m_M06_AXI_awid_converter_signal;
  xsc::common::vectorN2scalar_converter<32>* mp_M06_AXI_awaddr_converter;
  sc_signal< sc_bv<1> > m_M06_AXI_awaddr_converter_signal;
  xsc::common::vectorN2scalar_converter<8>* mp_M06_AXI_awlen_converter;
  sc_signal< sc_bv<1> > m_M06_AXI_awlen_converter_signal;
  xsc::common::vectorN2scalar_converter<1>* mp_M06_AXI_awuser_converter;
  sc_signal< sc_bv<1> > m_M06_AXI_awuser_converter_signal;
  xsc::common::scalar2vectorN_converter<1>* mp_M06_AXI_awvalid_converter;
  sc_signal< bool > m_M06_AXI_awvalid_converter_signal;
  xsc::common::vectorN2scalar_converter<1>* mp_M06_AXI_awready_converter;
  sc_signal< bool > m_M06_AXI_awready_converter_signal;
  xsc::common::vectorN2scalar_converter<32>* mp_M06_AXI_wdata_converter;
  sc_signal< sc_bv<1> > m_M06_AXI_wdata_converter_signal;
  xsc::common::vectorN2scalar_converter<4>* mp_M06_AXI_wstrb_converter;
  sc_signal< sc_bv<1> > m_M06_AXI_wstrb_converter_signal;
  xsc::common::scalar2vectorN_converter<1>* mp_M06_AXI_wlast_converter;
  sc_signal< bool > m_M06_AXI_wlast_converter_signal;
  xsc::common::vectorN2scalar_converter<1>* mp_M06_AXI_wuser_converter;
  sc_signal< sc_bv<1> > m_M06_AXI_wuser_converter_signal;
  xsc::common::scalar2vectorN_converter<1>* mp_M06_AXI_wvalid_converter;
  sc_signal< bool > m_M06_AXI_wvalid_converter_signal;
  xsc::common::vectorN2scalar_converter<1>* mp_M06_AXI_wready_converter;
  sc_signal< bool > m_M06_AXI_wready_converter_signal;
  xsc::common::scalar2vectorN_converter<1>* mp_M06_AXI_bid_converter;
  sc_signal< sc_bv<1> > m_M06_AXI_bid_converter_signal;
  xsc::common::scalar2vectorN_converter<1>* mp_M06_AXI_buser_converter;
  sc_signal< sc_bv<1> > m_M06_AXI_buser_converter_signal;
  xsc::common::vectorN2scalar_converter<1>* mp_M06_AXI_bvalid_converter;
  sc_signal< bool > m_M06_AXI_bvalid_converter_signal;
  xsc::common::scalar2vectorN_converter<1>* mp_M06_AXI_bready_converter;
  sc_signal< bool > m_M06_AXI_bready_converter_signal;
  xsc::common::vectorN2scalar_converter<1>* mp_M06_AXI_arid_converter;
  sc_signal< sc_bv<1> > m_M06_AXI_arid_converter_signal;
  xsc::common::vectorN2scalar_converter<32>* mp_M06_AXI_araddr_converter;
  sc_signal< sc_bv<1> > m_M06_AXI_araddr_converter_signal;
  xsc::common::vectorN2scalar_converter<8>* mp_M06_AXI_arlen_converter;
  sc_signal< sc_bv<1> > m_M06_AXI_arlen_converter_signal;
  xsc::common::vectorN2scalar_converter<1>* mp_M06_AXI_aruser_converter;
  sc_signal< sc_bv<1> > m_M06_AXI_aruser_converter_signal;
  xsc::common::scalar2vectorN_converter<1>* mp_M06_AXI_arvalid_converter;
  sc_signal< bool > m_M06_AXI_arvalid_converter_signal;
  xsc::common::vectorN2scalar_converter<1>* mp_M06_AXI_arready_converter;
  sc_signal< bool > m_M06_AXI_arready_converter_signal;
  xsc::common::scalar2vectorN_converter<1>* mp_M06_AXI_rid_converter;
  sc_signal< sc_bv<1> > m_M06_AXI_rid_converter_signal;
  xsc::common::scalar2vectorN_converter<32>* mp_M06_AXI_rdata_converter;
  sc_signal< sc_bv<1> > m_M06_AXI_rdata_converter_signal;
  xsc::common::vectorN2scalar_converter<1>* mp_M06_AXI_rlast_converter;
  sc_signal< bool > m_M06_AXI_rlast_converter_signal;
  xsc::common::scalar2vectorN_converter<1>* mp_M06_AXI_ruser_converter;
  sc_signal< sc_bv<1> > m_M06_AXI_ruser_converter_signal;
  xsc::common::vectorN2scalar_converter<1>* mp_M06_AXI_rvalid_converter;
  sc_signal< bool > m_M06_AXI_rvalid_converter_signal;
  xsc::common::scalar2vectorN_converter<1>* mp_M06_AXI_rready_converter;
  sc_signal< bool > m_M06_AXI_rready_converter_signal;
  xtlm::xaximm_xtlm2pin_t<32,32,1,1,1,1,1,1>* mp_M07_AXI_transactor;
  xsc::common::vectorN2scalar_converter<1>* mp_M07_AXI_awid_converter;
  sc_signal< sc_bv<1> > m_M07_AXI_awid_converter_signal;
  xsc::common::vectorN2scalar_converter<32>* mp_M07_AXI_awaddr_converter;
  sc_signal< sc_bv<1> > m_M07_AXI_awaddr_converter_signal;
  xsc::common::vectorN2scalar_converter<8>* mp_M07_AXI_awlen_converter;
  sc_signal< sc_bv<1> > m_M07_AXI_awlen_converter_signal;
  xsc::common::vectorN2scalar_converter<1>* mp_M07_AXI_awuser_converter;
  sc_signal< sc_bv<1> > m_M07_AXI_awuser_converter_signal;
  xsc::common::scalar2vectorN_converter<1>* mp_M07_AXI_awvalid_converter;
  sc_signal< bool > m_M07_AXI_awvalid_converter_signal;
  xsc::common::vectorN2scalar_converter<1>* mp_M07_AXI_awready_converter;
  sc_signal< bool > m_M07_AXI_awready_converter_signal;
  xsc::common::vectorN2scalar_converter<32>* mp_M07_AXI_wdata_converter;
  sc_signal< sc_bv<1> > m_M07_AXI_wdata_converter_signal;
  xsc::common::vectorN2scalar_converter<4>* mp_M07_AXI_wstrb_converter;
  sc_signal< sc_bv<1> > m_M07_AXI_wstrb_converter_signal;
  xsc::common::scalar2vectorN_converter<1>* mp_M07_AXI_wlast_converter;
  sc_signal< bool > m_M07_AXI_wlast_converter_signal;
  xsc::common::vectorN2scalar_converter<1>* mp_M07_AXI_wuser_converter;
  sc_signal< sc_bv<1> > m_M07_AXI_wuser_converter_signal;
  xsc::common::scalar2vectorN_converter<1>* mp_M07_AXI_wvalid_converter;
  sc_signal< bool > m_M07_AXI_wvalid_converter_signal;
  xsc::common::vectorN2scalar_converter<1>* mp_M07_AXI_wready_converter;
  sc_signal< bool > m_M07_AXI_wready_converter_signal;
  xsc::common::scalar2vectorN_converter<1>* mp_M07_AXI_bid_converter;
  sc_signal< sc_bv<1> > m_M07_AXI_bid_converter_signal;
  xsc::common::scalar2vectorN_converter<1>* mp_M07_AXI_buser_converter;
  sc_signal< sc_bv<1> > m_M07_AXI_buser_converter_signal;
  xsc::common::vectorN2scalar_converter<1>* mp_M07_AXI_bvalid_converter;
  sc_signal< bool > m_M07_AXI_bvalid_converter_signal;
  xsc::common::scalar2vectorN_converter<1>* mp_M07_AXI_bready_converter;
  sc_signal< bool > m_M07_AXI_bready_converter_signal;
  xsc::common::vectorN2scalar_converter<1>* mp_M07_AXI_arid_converter;
  sc_signal< sc_bv<1> > m_M07_AXI_arid_converter_signal;
  xsc::common::vectorN2scalar_converter<32>* mp_M07_AXI_araddr_converter;
  sc_signal< sc_bv<1> > m_M07_AXI_araddr_converter_signal;
  xsc::common::vectorN2scalar_converter<8>* mp_M07_AXI_arlen_converter;
  sc_signal< sc_bv<1> > m_M07_AXI_arlen_converter_signal;
  xsc::common::vectorN2scalar_converter<1>* mp_M07_AXI_aruser_converter;
  sc_signal< sc_bv<1> > m_M07_AXI_aruser_converter_signal;
  xsc::common::scalar2vectorN_converter<1>* mp_M07_AXI_arvalid_converter;
  sc_signal< bool > m_M07_AXI_arvalid_converter_signal;
  xsc::common::vectorN2scalar_converter<1>* mp_M07_AXI_arready_converter;
  sc_signal< bool > m_M07_AXI_arready_converter_signal;
  xsc::common::scalar2vectorN_converter<1>* mp_M07_AXI_rid_converter;
  sc_signal< sc_bv<1> > m_M07_AXI_rid_converter_signal;
  xsc::common::scalar2vectorN_converter<32>* mp_M07_AXI_rdata_converter;
  sc_signal< sc_bv<1> > m_M07_AXI_rdata_converter_signal;
  xsc::common::vectorN2scalar_converter<1>* mp_M07_AXI_rlast_converter;
  sc_signal< bool > m_M07_AXI_rlast_converter_signal;
  xsc::common::scalar2vectorN_converter<1>* mp_M07_AXI_ruser_converter;
  sc_signal< sc_bv<1> > m_M07_AXI_ruser_converter_signal;
  xsc::common::vectorN2scalar_converter<1>* mp_M07_AXI_rvalid_converter;
  sc_signal< bool > m_M07_AXI_rvalid_converter_signal;
  xsc::common::scalar2vectorN_converter<1>* mp_M07_AXI_rready_converter;
  sc_signal< bool > m_M07_AXI_rready_converter_signal;
  xtlm::xaximm_xtlm2pin_t<32,32,1,1,1,1,1,1>* mp_M08_AXI_transactor;
  xsc::common::vectorN2scalar_converter<1>* mp_M08_AXI_awid_converter;
  sc_signal< sc_bv<1> > m_M08_AXI_awid_converter_signal;
  xsc::common::vectorN2scalar_converter<32>* mp_M08_AXI_awaddr_converter;
  sc_signal< sc_bv<1> > m_M08_AXI_awaddr_converter_signal;
  xsc::common::vectorN2scalar_converter<8>* mp_M08_AXI_awlen_converter;
  sc_signal< sc_bv<1> > m_M08_AXI_awlen_converter_signal;
  xsc::common::vectorN2scalar_converter<1>* mp_M08_AXI_awuser_converter;
  sc_signal< sc_bv<1> > m_M08_AXI_awuser_converter_signal;
  xsc::common::scalar2vectorN_converter<1>* mp_M08_AXI_awvalid_converter;
  sc_signal< bool > m_M08_AXI_awvalid_converter_signal;
  xsc::common::vectorN2scalar_converter<1>* mp_M08_AXI_awready_converter;
  sc_signal< bool > m_M08_AXI_awready_converter_signal;
  xsc::common::vectorN2scalar_converter<32>* mp_M08_AXI_wdata_converter;
  sc_signal< sc_bv<1> > m_M08_AXI_wdata_converter_signal;
  xsc::common::vectorN2scalar_converter<4>* mp_M08_AXI_wstrb_converter;
  sc_signal< sc_bv<1> > m_M08_AXI_wstrb_converter_signal;
  xsc::common::scalar2vectorN_converter<1>* mp_M08_AXI_wlast_converter;
  sc_signal< bool > m_M08_AXI_wlast_converter_signal;
  xsc::common::vectorN2scalar_converter<1>* mp_M08_AXI_wuser_converter;
  sc_signal< sc_bv<1> > m_M08_AXI_wuser_converter_signal;
  xsc::common::scalar2vectorN_converter<1>* mp_M08_AXI_wvalid_converter;
  sc_signal< bool > m_M08_AXI_wvalid_converter_signal;
  xsc::common::vectorN2scalar_converter<1>* mp_M08_AXI_wready_converter;
  sc_signal< bool > m_M08_AXI_wready_converter_signal;
  xsc::common::scalar2vectorN_converter<1>* mp_M08_AXI_bid_converter;
  sc_signal< sc_bv<1> > m_M08_AXI_bid_converter_signal;
  xsc::common::scalar2vectorN_converter<1>* mp_M08_AXI_buser_converter;
  sc_signal< sc_bv<1> > m_M08_AXI_buser_converter_signal;
  xsc::common::vectorN2scalar_converter<1>* mp_M08_AXI_bvalid_converter;
  sc_signal< bool > m_M08_AXI_bvalid_converter_signal;
  xsc::common::scalar2vectorN_converter<1>* mp_M08_AXI_bready_converter;
  sc_signal< bool > m_M08_AXI_bready_converter_signal;
  xsc::common::vectorN2scalar_converter<1>* mp_M08_AXI_arid_converter;
  sc_signal< sc_bv<1> > m_M08_AXI_arid_converter_signal;
  xsc::common::vectorN2scalar_converter<32>* mp_M08_AXI_araddr_converter;
  sc_signal< sc_bv<1> > m_M08_AXI_araddr_converter_signal;
  xsc::common::vectorN2scalar_converter<8>* mp_M08_AXI_arlen_converter;
  sc_signal< sc_bv<1> > m_M08_AXI_arlen_converter_signal;
  xsc::common::vectorN2scalar_converter<1>* mp_M08_AXI_aruser_converter;
  sc_signal< sc_bv<1> > m_M08_AXI_aruser_converter_signal;
  xsc::common::scalar2vectorN_converter<1>* mp_M08_AXI_arvalid_converter;
  sc_signal< bool > m_M08_AXI_arvalid_converter_signal;
  xsc::common::vectorN2scalar_converter<1>* mp_M08_AXI_arready_converter;
  sc_signal< bool > m_M08_AXI_arready_converter_signal;
  xsc::common::scalar2vectorN_converter<1>* mp_M08_AXI_rid_converter;
  sc_signal< sc_bv<1> > m_M08_AXI_rid_converter_signal;
  xsc::common::scalar2vectorN_converter<32>* mp_M08_AXI_rdata_converter;
  sc_signal< sc_bv<1> > m_M08_AXI_rdata_converter_signal;
  xsc::common::vectorN2scalar_converter<1>* mp_M08_AXI_rlast_converter;
  sc_signal< bool > m_M08_AXI_rlast_converter_signal;
  xsc::common::scalar2vectorN_converter<1>* mp_M08_AXI_ruser_converter;
  sc_signal< sc_bv<1> > m_M08_AXI_ruser_converter_signal;
  xsc::common::vectorN2scalar_converter<1>* mp_M08_AXI_rvalid_converter;
  sc_signal< bool > m_M08_AXI_rvalid_converter_signal;
  xsc::common::scalar2vectorN_converter<1>* mp_M08_AXI_rready_converter;
  sc_signal< bool > m_M08_AXI_rready_converter_signal;

};
#endif // XILINX_SIMULATOR




#ifdef XM_SYSTEMC
class DllExport design_1_smartconnect_1_0 : public design_1_smartconnect_1_0_sc
{
public:

  design_1_smartconnect_1_0(const sc_core::sc_module_name& nm);
  virtual ~design_1_smartconnect_1_0();

  // module pin-to-pin RTL interface

  sc_core::sc_in< bool > aclk;
  sc_core::sc_in< bool > aresetn;
  sc_core::sc_in< sc_dt::sc_bv<12> > S00_AXI_awid;
  sc_core::sc_in< sc_dt::sc_bv<32> > S00_AXI_awaddr;
  sc_core::sc_in< sc_dt::sc_bv<4> > S00_AXI_awlen;
  sc_core::sc_in< sc_dt::sc_bv<3> > S00_AXI_awsize;
  sc_core::sc_in< sc_dt::sc_bv<2> > S00_AXI_awburst;
  sc_core::sc_in< sc_dt::sc_bv<2> > S00_AXI_awlock;
  sc_core::sc_in< sc_dt::sc_bv<4> > S00_AXI_awcache;
  sc_core::sc_in< sc_dt::sc_bv<3> > S00_AXI_awprot;
  sc_core::sc_in< sc_dt::sc_bv<4> > S00_AXI_awqos;
  sc_core::sc_in< bool > S00_AXI_awvalid;
  sc_core::sc_out< bool > S00_AXI_awready;
  sc_core::sc_in< sc_dt::sc_bv<12> > S00_AXI_wid;
  sc_core::sc_in< sc_dt::sc_bv<32> > S00_AXI_wdata;
  sc_core::sc_in< sc_dt::sc_bv<4> > S00_AXI_wstrb;
  sc_core::sc_in< bool > S00_AXI_wlast;
  sc_core::sc_in< bool > S00_AXI_wvalid;
  sc_core::sc_out< bool > S00_AXI_wready;
  sc_core::sc_out< sc_dt::sc_bv<12> > S00_AXI_bid;
  sc_core::sc_out< sc_dt::sc_bv<2> > S00_AXI_bresp;
  sc_core::sc_out< bool > S00_AXI_bvalid;
  sc_core::sc_in< bool > S00_AXI_bready;
  sc_core::sc_in< sc_dt::sc_bv<12> > S00_AXI_arid;
  sc_core::sc_in< sc_dt::sc_bv<32> > S00_AXI_araddr;
  sc_core::sc_in< sc_dt::sc_bv<4> > S00_AXI_arlen;
  sc_core::sc_in< sc_dt::sc_bv<3> > S00_AXI_arsize;
  sc_core::sc_in< sc_dt::sc_bv<2> > S00_AXI_arburst;
  sc_core::sc_in< sc_dt::sc_bv<2> > S00_AXI_arlock;
  sc_core::sc_in< sc_dt::sc_bv<4> > S00_AXI_arcache;
  sc_core::sc_in< sc_dt::sc_bv<3> > S00_AXI_arprot;
  sc_core::sc_in< sc_dt::sc_bv<4> > S00_AXI_arqos;
  sc_core::sc_in< bool > S00_AXI_arvalid;
  sc_core::sc_out< bool > S00_AXI_arready;
  sc_core::sc_out< sc_dt::sc_bv<12> > S00_AXI_rid;
  sc_core::sc_out< sc_dt::sc_bv<32> > S00_AXI_rdata;
  sc_core::sc_out< sc_dt::sc_bv<2> > S00_AXI_rresp;
  sc_core::sc_out< bool > S00_AXI_rlast;
  sc_core::sc_out< bool > S00_AXI_rvalid;
  sc_core::sc_in< bool > S00_AXI_rready;
  sc_core::sc_out< sc_dt::sc_bv<9> > M00_AXI_awaddr;
  sc_core::sc_out< sc_dt::sc_bv<3> > M00_AXI_awprot;
  sc_core::sc_out< bool > M00_AXI_awvalid;
  sc_core::sc_in< bool > M00_AXI_awready;
  sc_core::sc_out< sc_dt::sc_bv<32> > M00_AXI_wdata;
  sc_core::sc_out< sc_dt::sc_bv<4> > M00_AXI_wstrb;
  sc_core::sc_out< bool > M00_AXI_wvalid;
  sc_core::sc_in< bool > M00_AXI_wready;
  sc_core::sc_in< sc_dt::sc_bv<2> > M00_AXI_bresp;
  sc_core::sc_in< bool > M00_AXI_bvalid;
  sc_core::sc_out< bool > M00_AXI_bready;
  sc_core::sc_out< sc_dt::sc_bv<9> > M00_AXI_araddr;
  sc_core::sc_out< sc_dt::sc_bv<3> > M00_AXI_arprot;
  sc_core::sc_out< bool > M00_AXI_arvalid;
  sc_core::sc_in< bool > M00_AXI_arready;
  sc_core::sc_in< sc_dt::sc_bv<32> > M00_AXI_rdata;
  sc_core::sc_in< sc_dt::sc_bv<2> > M00_AXI_rresp;
  sc_core::sc_in< bool > M00_AXI_rvalid;
  sc_core::sc_out< bool > M00_AXI_rready;
  sc_core::sc_out< sc_dt::sc_bv<6> > M01_AXI_awaddr;
  sc_core::sc_out< sc_dt::sc_bv<3> > M01_AXI_awprot;
  sc_core::sc_out< bool > M01_AXI_awvalid;
  sc_core::sc_in< bool > M01_AXI_awready;
  sc_core::sc_out< sc_dt::sc_bv<32> > M01_AXI_wdata;
  sc_core::sc_out< sc_dt::sc_bv<4> > M01_AXI_wstrb;
  sc_core::sc_out< bool > M01_AXI_wvalid;
  sc_core::sc_in< bool > M01_AXI_wready;
  sc_core::sc_in< sc_dt::sc_bv<2> > M01_AXI_bresp;
  sc_core::sc_in< bool > M01_AXI_bvalid;
  sc_core::sc_out< bool > M01_AXI_bready;
  sc_core::sc_out< sc_dt::sc_bv<6> > M01_AXI_araddr;
  sc_core::sc_out< sc_dt::sc_bv<3> > M01_AXI_arprot;
  sc_core::sc_out< bool > M01_AXI_arvalid;
  sc_core::sc_in< bool > M01_AXI_arready;
  sc_core::sc_in< sc_dt::sc_bv<32> > M01_AXI_rdata;
  sc_core::sc_in< sc_dt::sc_bv<2> > M01_AXI_rresp;
  sc_core::sc_in< bool > M01_AXI_rvalid;
  sc_core::sc_out< bool > M01_AXI_rready;
  sc_core::sc_out< sc_dt::sc_bv<9> > M02_AXI_awaddr;
  sc_core::sc_out< sc_dt::sc_bv<3> > M02_AXI_awprot;
  sc_core::sc_out< bool > M02_AXI_awvalid;
  sc_core::sc_in< bool > M02_AXI_awready;
  sc_core::sc_out< sc_dt::sc_bv<32> > M02_AXI_wdata;
  sc_core::sc_out< sc_dt::sc_bv<4> > M02_AXI_wstrb;
  sc_core::sc_out< bool > M02_AXI_wvalid;
  sc_core::sc_in< bool > M02_AXI_wready;
  sc_core::sc_in< sc_dt::sc_bv<2> > M02_AXI_bresp;
  sc_core::sc_in< bool > M02_AXI_bvalid;
  sc_core::sc_out< bool > M02_AXI_bready;
  sc_core::sc_out< sc_dt::sc_bv<9> > M02_AXI_araddr;
  sc_core::sc_out< sc_dt::sc_bv<3> > M02_AXI_arprot;
  sc_core::sc_out< bool > M02_AXI_arvalid;
  sc_core::sc_in< bool > M02_AXI_arready;
  sc_core::sc_in< sc_dt::sc_bv<32> > M02_AXI_rdata;
  sc_core::sc_in< sc_dt::sc_bv<2> > M02_AXI_rresp;
  sc_core::sc_in< bool > M02_AXI_rvalid;
  sc_core::sc_out< bool > M02_AXI_rready;
  sc_core::sc_out< sc_dt::sc_bv<8> > M03_AXI_awaddr;
  sc_core::sc_out< sc_dt::sc_bv<3> > M03_AXI_awprot;
  sc_core::sc_out< bool > M03_AXI_awvalid;
  sc_core::sc_in< bool > M03_AXI_awready;
  sc_core::sc_out< sc_dt::sc_bv<32> > M03_AXI_wdata;
  sc_core::sc_out< sc_dt::sc_bv<4> > M03_AXI_wstrb;
  sc_core::sc_out< bool > M03_AXI_wvalid;
  sc_core::sc_in< bool > M03_AXI_wready;
  sc_core::sc_in< sc_dt::sc_bv<2> > M03_AXI_bresp;
  sc_core::sc_in< bool > M03_AXI_bvalid;
  sc_core::sc_out< bool > M03_AXI_bready;
  sc_core::sc_out< sc_dt::sc_bv<8> > M03_AXI_araddr;
  sc_core::sc_out< sc_dt::sc_bv<3> > M03_AXI_arprot;
  sc_core::sc_out< bool > M03_AXI_arvalid;
  sc_core::sc_in< bool > M03_AXI_arready;
  sc_core::sc_in< sc_dt::sc_bv<32> > M03_AXI_rdata;
  sc_core::sc_in< sc_dt::sc_bv<2> > M03_AXI_rresp;
  sc_core::sc_in< bool > M03_AXI_rvalid;
  sc_core::sc_out< bool > M03_AXI_rready;
  sc_core::sc_out< sc_dt::sc_bv<7> > M04_AXI_awaddr;
  sc_core::sc_out< sc_dt::sc_bv<3> > M04_AXI_awprot;
  sc_core::sc_out< bool > M04_AXI_awvalid;
  sc_core::sc_in< bool > M04_AXI_awready;
  sc_core::sc_out< sc_dt::sc_bv<32> > M04_AXI_wdata;
  sc_core::sc_out< sc_dt::sc_bv<4> > M04_AXI_wstrb;
  sc_core::sc_out< bool > M04_AXI_wvalid;
  sc_core::sc_in< bool > M04_AXI_wready;
  sc_core::sc_in< sc_dt::sc_bv<2> > M04_AXI_bresp;
  sc_core::sc_in< bool > M04_AXI_bvalid;
  sc_core::sc_out< bool > M04_AXI_bready;
  sc_core::sc_out< sc_dt::sc_bv<7> > M04_AXI_araddr;
  sc_core::sc_out< sc_dt::sc_bv<3> > M04_AXI_arprot;
  sc_core::sc_out< bool > M04_AXI_arvalid;
  sc_core::sc_in< bool > M04_AXI_arready;
  sc_core::sc_in< sc_dt::sc_bv<32> > M04_AXI_rdata;
  sc_core::sc_in< sc_dt::sc_bv<2> > M04_AXI_rresp;
  sc_core::sc_in< bool > M04_AXI_rvalid;
  sc_core::sc_out< bool > M04_AXI_rready;
  sc_core::sc_out< bool > M05_AXI_awid;
  sc_core::sc_out< bool > M05_AXI_awaddr;
  sc_core::sc_out< bool > M05_AXI_awlen;
  sc_core::sc_out< sc_dt::sc_bv<3> > M05_AXI_awsize;
  sc_core::sc_out< sc_dt::sc_bv<2> > M05_AXI_awburst;
  sc_core::sc_out< bool > M05_AXI_awlock;
  sc_core::sc_out< sc_dt::sc_bv<4> > M05_AXI_awcache;
  sc_core::sc_out< sc_dt::sc_bv<3> > M05_AXI_awprot;
  sc_core::sc_out< sc_dt::sc_bv<4> > M05_AXI_awregion;
  sc_core::sc_out< sc_dt::sc_bv<4> > M05_AXI_awqos;
  sc_core::sc_out< bool > M05_AXI_awuser;
  sc_core::sc_out< sc_dt::sc_bv<1> > M05_AXI_awvalid;
  sc_core::sc_in< sc_dt::sc_bv<1> > M05_AXI_awready;
  sc_core::sc_out< bool > M05_AXI_wid;
  sc_core::sc_out< bool > M05_AXI_wdata;
  sc_core::sc_out< bool > M05_AXI_wstrb;
  sc_core::sc_out< sc_dt::sc_bv<1> > M05_AXI_wlast;
  sc_core::sc_out< bool > M05_AXI_wuser;
  sc_core::sc_out< sc_dt::sc_bv<1> > M05_AXI_wvalid;
  sc_core::sc_in< sc_dt::sc_bv<1> > M05_AXI_wready;
  sc_core::sc_in< bool > M05_AXI_bid;
  sc_core::sc_in< sc_dt::sc_bv<2> > M05_AXI_bresp;
  sc_core::sc_in< bool > M05_AXI_buser;
  sc_core::sc_in< sc_dt::sc_bv<1> > M05_AXI_bvalid;
  sc_core::sc_out< sc_dt::sc_bv<1> > M05_AXI_bready;
  sc_core::sc_out< bool > M05_AXI_arid;
  sc_core::sc_out< bool > M05_AXI_araddr;
  sc_core::sc_out< bool > M05_AXI_arlen;
  sc_core::sc_out< sc_dt::sc_bv<3> > M05_AXI_arsize;
  sc_core::sc_out< sc_dt::sc_bv<2> > M05_AXI_arburst;
  sc_core::sc_out< bool > M05_AXI_arlock;
  sc_core::sc_out< sc_dt::sc_bv<4> > M05_AXI_arcache;
  sc_core::sc_out< sc_dt::sc_bv<3> > M05_AXI_arprot;
  sc_core::sc_out< sc_dt::sc_bv<4> > M05_AXI_arregion;
  sc_core::sc_out< sc_dt::sc_bv<4> > M05_AXI_arqos;
  sc_core::sc_out< bool > M05_AXI_aruser;
  sc_core::sc_out< sc_dt::sc_bv<1> > M05_AXI_arvalid;
  sc_core::sc_in< sc_dt::sc_bv<1> > M05_AXI_arready;
  sc_core::sc_in< bool > M05_AXI_rid;
  sc_core::sc_in< bool > M05_AXI_rdata;
  sc_core::sc_in< sc_dt::sc_bv<2> > M05_AXI_rresp;
  sc_core::sc_in< sc_dt::sc_bv<1> > M05_AXI_rlast;
  sc_core::sc_in< bool > M05_AXI_ruser;
  sc_core::sc_in< sc_dt::sc_bv<1> > M05_AXI_rvalid;
  sc_core::sc_out< sc_dt::sc_bv<1> > M05_AXI_rready;
  sc_core::sc_out< bool > M06_AXI_awid;
  sc_core::sc_out< bool > M06_AXI_awaddr;
  sc_core::sc_out< bool > M06_AXI_awlen;
  sc_core::sc_out< sc_dt::sc_bv<3> > M06_AXI_awsize;
  sc_core::sc_out< sc_dt::sc_bv<2> > M06_AXI_awburst;
  sc_core::sc_out< bool > M06_AXI_awlock;
  sc_core::sc_out< sc_dt::sc_bv<4> > M06_AXI_awcache;
  sc_core::sc_out< sc_dt::sc_bv<3> > M06_AXI_awprot;
  sc_core::sc_out< sc_dt::sc_bv<4> > M06_AXI_awregion;
  sc_core::sc_out< sc_dt::sc_bv<4> > M06_AXI_awqos;
  sc_core::sc_out< bool > M06_AXI_awuser;
  sc_core::sc_out< sc_dt::sc_bv<1> > M06_AXI_awvalid;
  sc_core::sc_in< sc_dt::sc_bv<1> > M06_AXI_awready;
  sc_core::sc_out< bool > M06_AXI_wid;
  sc_core::sc_out< bool > M06_AXI_wdata;
  sc_core::sc_out< bool > M06_AXI_wstrb;
  sc_core::sc_out< sc_dt::sc_bv<1> > M06_AXI_wlast;
  sc_core::sc_out< bool > M06_AXI_wuser;
  sc_core::sc_out< sc_dt::sc_bv<1> > M06_AXI_wvalid;
  sc_core::sc_in< sc_dt::sc_bv<1> > M06_AXI_wready;
  sc_core::sc_in< bool > M06_AXI_bid;
  sc_core::sc_in< sc_dt::sc_bv<2> > M06_AXI_bresp;
  sc_core::sc_in< bool > M06_AXI_buser;
  sc_core::sc_in< sc_dt::sc_bv<1> > M06_AXI_bvalid;
  sc_core::sc_out< sc_dt::sc_bv<1> > M06_AXI_bready;
  sc_core::sc_out< bool > M06_AXI_arid;
  sc_core::sc_out< bool > M06_AXI_araddr;
  sc_core::sc_out< bool > M06_AXI_arlen;
  sc_core::sc_out< sc_dt::sc_bv<3> > M06_AXI_arsize;
  sc_core::sc_out< sc_dt::sc_bv<2> > M06_AXI_arburst;
  sc_core::sc_out< bool > M06_AXI_arlock;
  sc_core::sc_out< sc_dt::sc_bv<4> > M06_AXI_arcache;
  sc_core::sc_out< sc_dt::sc_bv<3> > M06_AXI_arprot;
  sc_core::sc_out< sc_dt::sc_bv<4> > M06_AXI_arregion;
  sc_core::sc_out< sc_dt::sc_bv<4> > M06_AXI_arqos;
  sc_core::sc_out< bool > M06_AXI_aruser;
  sc_core::sc_out< sc_dt::sc_bv<1> > M06_AXI_arvalid;
  sc_core::sc_in< sc_dt::sc_bv<1> > M06_AXI_arready;
  sc_core::sc_in< bool > M06_AXI_rid;
  sc_core::sc_in< bool > M06_AXI_rdata;
  sc_core::sc_in< sc_dt::sc_bv<2> > M06_AXI_rresp;
  sc_core::sc_in< sc_dt::sc_bv<1> > M06_AXI_rlast;
  sc_core::sc_in< bool > M06_AXI_ruser;
  sc_core::sc_in< sc_dt::sc_bv<1> > M06_AXI_rvalid;
  sc_core::sc_out< sc_dt::sc_bv<1> > M06_AXI_rready;
  sc_core::sc_out< bool > M07_AXI_awid;
  sc_core::sc_out< bool > M07_AXI_awaddr;
  sc_core::sc_out< bool > M07_AXI_awlen;
  sc_core::sc_out< sc_dt::sc_bv<3> > M07_AXI_awsize;
  sc_core::sc_out< sc_dt::sc_bv<2> > M07_AXI_awburst;
  sc_core::sc_out< bool > M07_AXI_awlock;
  sc_core::sc_out< sc_dt::sc_bv<4> > M07_AXI_awcache;
  sc_core::sc_out< sc_dt::sc_bv<3> > M07_AXI_awprot;
  sc_core::sc_out< sc_dt::sc_bv<4> > M07_AXI_awregion;
  sc_core::sc_out< sc_dt::sc_bv<4> > M07_AXI_awqos;
  sc_core::sc_out< bool > M07_AXI_awuser;
  sc_core::sc_out< sc_dt::sc_bv<1> > M07_AXI_awvalid;
  sc_core::sc_in< sc_dt::sc_bv<1> > M07_AXI_awready;
  sc_core::sc_out< bool > M07_AXI_wid;
  sc_core::sc_out< bool > M07_AXI_wdata;
  sc_core::sc_out< bool > M07_AXI_wstrb;
  sc_core::sc_out< sc_dt::sc_bv<1> > M07_AXI_wlast;
  sc_core::sc_out< bool > M07_AXI_wuser;
  sc_core::sc_out< sc_dt::sc_bv<1> > M07_AXI_wvalid;
  sc_core::sc_in< sc_dt::sc_bv<1> > M07_AXI_wready;
  sc_core::sc_in< bool > M07_AXI_bid;
  sc_core::sc_in< sc_dt::sc_bv<2> > M07_AXI_bresp;
  sc_core::sc_in< bool > M07_AXI_buser;
  sc_core::sc_in< sc_dt::sc_bv<1> > M07_AXI_bvalid;
  sc_core::sc_out< sc_dt::sc_bv<1> > M07_AXI_bready;
  sc_core::sc_out< bool > M07_AXI_arid;
  sc_core::sc_out< bool > M07_AXI_araddr;
  sc_core::sc_out< bool > M07_AXI_arlen;
  sc_core::sc_out< sc_dt::sc_bv<3> > M07_AXI_arsize;
  sc_core::sc_out< sc_dt::sc_bv<2> > M07_AXI_arburst;
  sc_core::sc_out< bool > M07_AXI_arlock;
  sc_core::sc_out< sc_dt::sc_bv<4> > M07_AXI_arcache;
  sc_core::sc_out< sc_dt::sc_bv<3> > M07_AXI_arprot;
  sc_core::sc_out< sc_dt::sc_bv<4> > M07_AXI_arregion;
  sc_core::sc_out< sc_dt::sc_bv<4> > M07_AXI_arqos;
  sc_core::sc_out< bool > M07_AXI_aruser;
  sc_core::sc_out< sc_dt::sc_bv<1> > M07_AXI_arvalid;
  sc_core::sc_in< sc_dt::sc_bv<1> > M07_AXI_arready;
  sc_core::sc_in< bool > M07_AXI_rid;
  sc_core::sc_in< bool > M07_AXI_rdata;
  sc_core::sc_in< sc_dt::sc_bv<2> > M07_AXI_rresp;
  sc_core::sc_in< sc_dt::sc_bv<1> > M07_AXI_rlast;
  sc_core::sc_in< bool > M07_AXI_ruser;
  sc_core::sc_in< sc_dt::sc_bv<1> > M07_AXI_rvalid;
  sc_core::sc_out< sc_dt::sc_bv<1> > M07_AXI_rready;
  sc_core::sc_out< bool > M08_AXI_awid;
  sc_core::sc_out< bool > M08_AXI_awaddr;
  sc_core::sc_out< bool > M08_AXI_awlen;
  sc_core::sc_out< sc_dt::sc_bv<3> > M08_AXI_awsize;
  sc_core::sc_out< sc_dt::sc_bv<2> > M08_AXI_awburst;
  sc_core::sc_out< bool > M08_AXI_awlock;
  sc_core::sc_out< sc_dt::sc_bv<4> > M08_AXI_awcache;
  sc_core::sc_out< sc_dt::sc_bv<3> > M08_AXI_awprot;
  sc_core::sc_out< sc_dt::sc_bv<4> > M08_AXI_awregion;
  sc_core::sc_out< sc_dt::sc_bv<4> > M08_AXI_awqos;
  sc_core::sc_out< bool > M08_AXI_awuser;
  sc_core::sc_out< sc_dt::sc_bv<1> > M08_AXI_awvalid;
  sc_core::sc_in< sc_dt::sc_bv<1> > M08_AXI_awready;
  sc_core::sc_out< bool > M08_AXI_wid;
  sc_core::sc_out< bool > M08_AXI_wdata;
  sc_core::sc_out< bool > M08_AXI_wstrb;
  sc_core::sc_out< sc_dt::sc_bv<1> > M08_AXI_wlast;
  sc_core::sc_out< bool > M08_AXI_wuser;
  sc_core::sc_out< sc_dt::sc_bv<1> > M08_AXI_wvalid;
  sc_core::sc_in< sc_dt::sc_bv<1> > M08_AXI_wready;
  sc_core::sc_in< bool > M08_AXI_bid;
  sc_core::sc_in< sc_dt::sc_bv<2> > M08_AXI_bresp;
  sc_core::sc_in< bool > M08_AXI_buser;
  sc_core::sc_in< sc_dt::sc_bv<1> > M08_AXI_bvalid;
  sc_core::sc_out< sc_dt::sc_bv<1> > M08_AXI_bready;
  sc_core::sc_out< bool > M08_AXI_arid;
  sc_core::sc_out< bool > M08_AXI_araddr;
  sc_core::sc_out< bool > M08_AXI_arlen;
  sc_core::sc_out< sc_dt::sc_bv<3> > M08_AXI_arsize;
  sc_core::sc_out< sc_dt::sc_bv<2> > M08_AXI_arburst;
  sc_core::sc_out< bool > M08_AXI_arlock;
  sc_core::sc_out< sc_dt::sc_bv<4> > M08_AXI_arcache;
  sc_core::sc_out< sc_dt::sc_bv<3> > M08_AXI_arprot;
  sc_core::sc_out< sc_dt::sc_bv<4> > M08_AXI_arregion;
  sc_core::sc_out< sc_dt::sc_bv<4> > M08_AXI_arqos;
  sc_core::sc_out< bool > M08_AXI_aruser;
  sc_core::sc_out< sc_dt::sc_bv<1> > M08_AXI_arvalid;
  sc_core::sc_in< sc_dt::sc_bv<1> > M08_AXI_arready;
  sc_core::sc_in< bool > M08_AXI_rid;
  sc_core::sc_in< bool > M08_AXI_rdata;
  sc_core::sc_in< sc_dt::sc_bv<2> > M08_AXI_rresp;
  sc_core::sc_in< sc_dt::sc_bv<1> > M08_AXI_rlast;
  sc_core::sc_in< bool > M08_AXI_ruser;
  sc_core::sc_in< sc_dt::sc_bv<1> > M08_AXI_rvalid;
  sc_core::sc_out< sc_dt::sc_bv<1> > M08_AXI_rready;

  // Dummy Signals for IP Ports


protected:

  virtual void before_end_of_elaboration();

private:

  xtlm::xaximm_pin2xtlm_t<32,32,12,1,1,1,1,1>* mp_S00_AXI_transactor;
  xsc::common::vector2vector_converter<4,8>* mp_S00_AXI_awlen_converter;
  sc_signal< sc_bv<8> > m_S00_AXI_awlen_converter_signal;
  xsc::common::vectorN2scalar_converter<2>* mp_S00_AXI_awlock_converter;
  sc_signal< bool > m_S00_AXI_awlock_converter_signal;
  xsc::common::vector2vector_converter<4,8>* mp_S00_AXI_arlen_converter;
  sc_signal< sc_bv<8> > m_S00_AXI_arlen_converter_signal;
  xsc::common::vectorN2scalar_converter<2>* mp_S00_AXI_arlock_converter;
  sc_signal< bool > m_S00_AXI_arlock_converter_signal;
  xtlm::xaximm_xtlm2pin_t<32,9,1,1,1,1,1,1>* mp_M00_AXI_transactor;
  xtlm::xaximm_xtlm2pin_t<32,6,1,1,1,1,1,1>* mp_M01_AXI_transactor;
  xtlm::xaximm_xtlm2pin_t<32,9,1,1,1,1,1,1>* mp_M02_AXI_transactor;
  xtlm::xaximm_xtlm2pin_t<32,8,1,1,1,1,1,1>* mp_M03_AXI_transactor;
  xtlm::xaximm_xtlm2pin_t<32,7,1,1,1,1,1,1>* mp_M04_AXI_transactor;
  xtlm::xaximm_xtlm2pin_t<32,32,1,1,1,1,1,1>* mp_M05_AXI_transactor;
  xsc::common::vectorN2scalar_converter<1>* mp_M05_AXI_awid_converter;
  sc_signal< sc_bv<1> > m_M05_AXI_awid_converter_signal;
  xsc::common::vectorN2scalar_converter<32>* mp_M05_AXI_awaddr_converter;
  sc_signal< sc_bv<1> > m_M05_AXI_awaddr_converter_signal;
  xsc::common::vectorN2scalar_converter<8>* mp_M05_AXI_awlen_converter;
  sc_signal< sc_bv<1> > m_M05_AXI_awlen_converter_signal;
  xsc::common::vectorN2scalar_converter<1>* mp_M05_AXI_awuser_converter;
  sc_signal< sc_bv<1> > m_M05_AXI_awuser_converter_signal;
  xsc::common::scalar2vectorN_converter<1>* mp_M05_AXI_awvalid_converter;
  sc_signal< bool > m_M05_AXI_awvalid_converter_signal;
  xsc::common::vectorN2scalar_converter<1>* mp_M05_AXI_awready_converter;
  sc_signal< bool > m_M05_AXI_awready_converter_signal;
  xsc::common::vectorN2scalar_converter<32>* mp_M05_AXI_wdata_converter;
  sc_signal< sc_bv<1> > m_M05_AXI_wdata_converter_signal;
  xsc::common::vectorN2scalar_converter<4>* mp_M05_AXI_wstrb_converter;
  sc_signal< sc_bv<1> > m_M05_AXI_wstrb_converter_signal;
  xsc::common::scalar2vectorN_converter<1>* mp_M05_AXI_wlast_converter;
  sc_signal< bool > m_M05_AXI_wlast_converter_signal;
  xsc::common::vectorN2scalar_converter<1>* mp_M05_AXI_wuser_converter;
  sc_signal< sc_bv<1> > m_M05_AXI_wuser_converter_signal;
  xsc::common::scalar2vectorN_converter<1>* mp_M05_AXI_wvalid_converter;
  sc_signal< bool > m_M05_AXI_wvalid_converter_signal;
  xsc::common::vectorN2scalar_converter<1>* mp_M05_AXI_wready_converter;
  sc_signal< bool > m_M05_AXI_wready_converter_signal;
  xsc::common::scalar2vectorN_converter<1>* mp_M05_AXI_bid_converter;
  sc_signal< sc_bv<1> > m_M05_AXI_bid_converter_signal;
  xsc::common::scalar2vectorN_converter<1>* mp_M05_AXI_buser_converter;
  sc_signal< sc_bv<1> > m_M05_AXI_buser_converter_signal;
  xsc::common::vectorN2scalar_converter<1>* mp_M05_AXI_bvalid_converter;
  sc_signal< bool > m_M05_AXI_bvalid_converter_signal;
  xsc::common::scalar2vectorN_converter<1>* mp_M05_AXI_bready_converter;
  sc_signal< bool > m_M05_AXI_bready_converter_signal;
  xsc::common::vectorN2scalar_converter<1>* mp_M05_AXI_arid_converter;
  sc_signal< sc_bv<1> > m_M05_AXI_arid_converter_signal;
  xsc::common::vectorN2scalar_converter<32>* mp_M05_AXI_araddr_converter;
  sc_signal< sc_bv<1> > m_M05_AXI_araddr_converter_signal;
  xsc::common::vectorN2scalar_converter<8>* mp_M05_AXI_arlen_converter;
  sc_signal< sc_bv<1> > m_M05_AXI_arlen_converter_signal;
  xsc::common::vectorN2scalar_converter<1>* mp_M05_AXI_aruser_converter;
  sc_signal< sc_bv<1> > m_M05_AXI_aruser_converter_signal;
  xsc::common::scalar2vectorN_converter<1>* mp_M05_AXI_arvalid_converter;
  sc_signal< bool > m_M05_AXI_arvalid_converter_signal;
  xsc::common::vectorN2scalar_converter<1>* mp_M05_AXI_arready_converter;
  sc_signal< bool > m_M05_AXI_arready_converter_signal;
  xsc::common::scalar2vectorN_converter<1>* mp_M05_AXI_rid_converter;
  sc_signal< sc_bv<1> > m_M05_AXI_rid_converter_signal;
  xsc::common::scalar2vectorN_converter<32>* mp_M05_AXI_rdata_converter;
  sc_signal< sc_bv<1> > m_M05_AXI_rdata_converter_signal;
  xsc::common::vectorN2scalar_converter<1>* mp_M05_AXI_rlast_converter;
  sc_signal< bool > m_M05_AXI_rlast_converter_signal;
  xsc::common::scalar2vectorN_converter<1>* mp_M05_AXI_ruser_converter;
  sc_signal< sc_bv<1> > m_M05_AXI_ruser_converter_signal;
  xsc::common::vectorN2scalar_converter<1>* mp_M05_AXI_rvalid_converter;
  sc_signal< bool > m_M05_AXI_rvalid_converter_signal;
  xsc::common::scalar2vectorN_converter<1>* mp_M05_AXI_rready_converter;
  sc_signal< bool > m_M05_AXI_rready_converter_signal;
  xtlm::xaximm_xtlm2pin_t<32,32,1,1,1,1,1,1>* mp_M06_AXI_transactor;
  xsc::common::vectorN2scalar_converter<1>* mp_M06_AXI_awid_converter;
  sc_signal< sc_bv<1> > m_M06_AXI_awid_converter_signal;
  xsc::common::vectorN2scalar_converter<32>* mp_M06_AXI_awaddr_converter;
  sc_signal< sc_bv<1> > m_M06_AXI_awaddr_converter_signal;
  xsc::common::vectorN2scalar_converter<8>* mp_M06_AXI_awlen_converter;
  sc_signal< sc_bv<1> > m_M06_AXI_awlen_converter_signal;
  xsc::common::vectorN2scalar_converter<1>* mp_M06_AXI_awuser_converter;
  sc_signal< sc_bv<1> > m_M06_AXI_awuser_converter_signal;
  xsc::common::scalar2vectorN_converter<1>* mp_M06_AXI_awvalid_converter;
  sc_signal< bool > m_M06_AXI_awvalid_converter_signal;
  xsc::common::vectorN2scalar_converter<1>* mp_M06_AXI_awready_converter;
  sc_signal< bool > m_M06_AXI_awready_converter_signal;
  xsc::common::vectorN2scalar_converter<32>* mp_M06_AXI_wdata_converter;
  sc_signal< sc_bv<1> > m_M06_AXI_wdata_converter_signal;
  xsc::common::vectorN2scalar_converter<4>* mp_M06_AXI_wstrb_converter;
  sc_signal< sc_bv<1> > m_M06_AXI_wstrb_converter_signal;
  xsc::common::scalar2vectorN_converter<1>* mp_M06_AXI_wlast_converter;
  sc_signal< bool > m_M06_AXI_wlast_converter_signal;
  xsc::common::vectorN2scalar_converter<1>* mp_M06_AXI_wuser_converter;
  sc_signal< sc_bv<1> > m_M06_AXI_wuser_converter_signal;
  xsc::common::scalar2vectorN_converter<1>* mp_M06_AXI_wvalid_converter;
  sc_signal< bool > m_M06_AXI_wvalid_converter_signal;
  xsc::common::vectorN2scalar_converter<1>* mp_M06_AXI_wready_converter;
  sc_signal< bool > m_M06_AXI_wready_converter_signal;
  xsc::common::scalar2vectorN_converter<1>* mp_M06_AXI_bid_converter;
  sc_signal< sc_bv<1> > m_M06_AXI_bid_converter_signal;
  xsc::common::scalar2vectorN_converter<1>* mp_M06_AXI_buser_converter;
  sc_signal< sc_bv<1> > m_M06_AXI_buser_converter_signal;
  xsc::common::vectorN2scalar_converter<1>* mp_M06_AXI_bvalid_converter;
  sc_signal< bool > m_M06_AXI_bvalid_converter_signal;
  xsc::common::scalar2vectorN_converter<1>* mp_M06_AXI_bready_converter;
  sc_signal< bool > m_M06_AXI_bready_converter_signal;
  xsc::common::vectorN2scalar_converter<1>* mp_M06_AXI_arid_converter;
  sc_signal< sc_bv<1> > m_M06_AXI_arid_converter_signal;
  xsc::common::vectorN2scalar_converter<32>* mp_M06_AXI_araddr_converter;
  sc_signal< sc_bv<1> > m_M06_AXI_araddr_converter_signal;
  xsc::common::vectorN2scalar_converter<8>* mp_M06_AXI_arlen_converter;
  sc_signal< sc_bv<1> > m_M06_AXI_arlen_converter_signal;
  xsc::common::vectorN2scalar_converter<1>* mp_M06_AXI_aruser_converter;
  sc_signal< sc_bv<1> > m_M06_AXI_aruser_converter_signal;
  xsc::common::scalar2vectorN_converter<1>* mp_M06_AXI_arvalid_converter;
  sc_signal< bool > m_M06_AXI_arvalid_converter_signal;
  xsc::common::vectorN2scalar_converter<1>* mp_M06_AXI_arready_converter;
  sc_signal< bool > m_M06_AXI_arready_converter_signal;
  xsc::common::scalar2vectorN_converter<1>* mp_M06_AXI_rid_converter;
  sc_signal< sc_bv<1> > m_M06_AXI_rid_converter_signal;
  xsc::common::scalar2vectorN_converter<32>* mp_M06_AXI_rdata_converter;
  sc_signal< sc_bv<1> > m_M06_AXI_rdata_converter_signal;
  xsc::common::vectorN2scalar_converter<1>* mp_M06_AXI_rlast_converter;
  sc_signal< bool > m_M06_AXI_rlast_converter_signal;
  xsc::common::scalar2vectorN_converter<1>* mp_M06_AXI_ruser_converter;
  sc_signal< sc_bv<1> > m_M06_AXI_ruser_converter_signal;
  xsc::common::vectorN2scalar_converter<1>* mp_M06_AXI_rvalid_converter;
  sc_signal< bool > m_M06_AXI_rvalid_converter_signal;
  xsc::common::scalar2vectorN_converter<1>* mp_M06_AXI_rready_converter;
  sc_signal< bool > m_M06_AXI_rready_converter_signal;
  xtlm::xaximm_xtlm2pin_t<32,32,1,1,1,1,1,1>* mp_M07_AXI_transactor;
  xsc::common::vectorN2scalar_converter<1>* mp_M07_AXI_awid_converter;
  sc_signal< sc_bv<1> > m_M07_AXI_awid_converter_signal;
  xsc::common::vectorN2scalar_converter<32>* mp_M07_AXI_awaddr_converter;
  sc_signal< sc_bv<1> > m_M07_AXI_awaddr_converter_signal;
  xsc::common::vectorN2scalar_converter<8>* mp_M07_AXI_awlen_converter;
  sc_signal< sc_bv<1> > m_M07_AXI_awlen_converter_signal;
  xsc::common::vectorN2scalar_converter<1>* mp_M07_AXI_awuser_converter;
  sc_signal< sc_bv<1> > m_M07_AXI_awuser_converter_signal;
  xsc::common::scalar2vectorN_converter<1>* mp_M07_AXI_awvalid_converter;
  sc_signal< bool > m_M07_AXI_awvalid_converter_signal;
  xsc::common::vectorN2scalar_converter<1>* mp_M07_AXI_awready_converter;
  sc_signal< bool > m_M07_AXI_awready_converter_signal;
  xsc::common::vectorN2scalar_converter<32>* mp_M07_AXI_wdata_converter;
  sc_signal< sc_bv<1> > m_M07_AXI_wdata_converter_signal;
  xsc::common::vectorN2scalar_converter<4>* mp_M07_AXI_wstrb_converter;
  sc_signal< sc_bv<1> > m_M07_AXI_wstrb_converter_signal;
  xsc::common::scalar2vectorN_converter<1>* mp_M07_AXI_wlast_converter;
  sc_signal< bool > m_M07_AXI_wlast_converter_signal;
  xsc::common::vectorN2scalar_converter<1>* mp_M07_AXI_wuser_converter;
  sc_signal< sc_bv<1> > m_M07_AXI_wuser_converter_signal;
  xsc::common::scalar2vectorN_converter<1>* mp_M07_AXI_wvalid_converter;
  sc_signal< bool > m_M07_AXI_wvalid_converter_signal;
  xsc::common::vectorN2scalar_converter<1>* mp_M07_AXI_wready_converter;
  sc_signal< bool > m_M07_AXI_wready_converter_signal;
  xsc::common::scalar2vectorN_converter<1>* mp_M07_AXI_bid_converter;
  sc_signal< sc_bv<1> > m_M07_AXI_bid_converter_signal;
  xsc::common::scalar2vectorN_converter<1>* mp_M07_AXI_buser_converter;
  sc_signal< sc_bv<1> > m_M07_AXI_buser_converter_signal;
  xsc::common::vectorN2scalar_converter<1>* mp_M07_AXI_bvalid_converter;
  sc_signal< bool > m_M07_AXI_bvalid_converter_signal;
  xsc::common::scalar2vectorN_converter<1>* mp_M07_AXI_bready_converter;
  sc_signal< bool > m_M07_AXI_bready_converter_signal;
  xsc::common::vectorN2scalar_converter<1>* mp_M07_AXI_arid_converter;
  sc_signal< sc_bv<1> > m_M07_AXI_arid_converter_signal;
  xsc::common::vectorN2scalar_converter<32>* mp_M07_AXI_araddr_converter;
  sc_signal< sc_bv<1> > m_M07_AXI_araddr_converter_signal;
  xsc::common::vectorN2scalar_converter<8>* mp_M07_AXI_arlen_converter;
  sc_signal< sc_bv<1> > m_M07_AXI_arlen_converter_signal;
  xsc::common::vectorN2scalar_converter<1>* mp_M07_AXI_aruser_converter;
  sc_signal< sc_bv<1> > m_M07_AXI_aruser_converter_signal;
  xsc::common::scalar2vectorN_converter<1>* mp_M07_AXI_arvalid_converter;
  sc_signal< bool > m_M07_AXI_arvalid_converter_signal;
  xsc::common::vectorN2scalar_converter<1>* mp_M07_AXI_arready_converter;
  sc_signal< bool > m_M07_AXI_arready_converter_signal;
  xsc::common::scalar2vectorN_converter<1>* mp_M07_AXI_rid_converter;
  sc_signal< sc_bv<1> > m_M07_AXI_rid_converter_signal;
  xsc::common::scalar2vectorN_converter<32>* mp_M07_AXI_rdata_converter;
  sc_signal< sc_bv<1> > m_M07_AXI_rdata_converter_signal;
  xsc::common::vectorN2scalar_converter<1>* mp_M07_AXI_rlast_converter;
  sc_signal< bool > m_M07_AXI_rlast_converter_signal;
  xsc::common::scalar2vectorN_converter<1>* mp_M07_AXI_ruser_converter;
  sc_signal< sc_bv<1> > m_M07_AXI_ruser_converter_signal;
  xsc::common::vectorN2scalar_converter<1>* mp_M07_AXI_rvalid_converter;
  sc_signal< bool > m_M07_AXI_rvalid_converter_signal;
  xsc::common::scalar2vectorN_converter<1>* mp_M07_AXI_rready_converter;
  sc_signal< bool > m_M07_AXI_rready_converter_signal;
  xtlm::xaximm_xtlm2pin_t<32,32,1,1,1,1,1,1>* mp_M08_AXI_transactor;
  xsc::common::vectorN2scalar_converter<1>* mp_M08_AXI_awid_converter;
  sc_signal< sc_bv<1> > m_M08_AXI_awid_converter_signal;
  xsc::common::vectorN2scalar_converter<32>* mp_M08_AXI_awaddr_converter;
  sc_signal< sc_bv<1> > m_M08_AXI_awaddr_converter_signal;
  xsc::common::vectorN2scalar_converter<8>* mp_M08_AXI_awlen_converter;
  sc_signal< sc_bv<1> > m_M08_AXI_awlen_converter_signal;
  xsc::common::vectorN2scalar_converter<1>* mp_M08_AXI_awuser_converter;
  sc_signal< sc_bv<1> > m_M08_AXI_awuser_converter_signal;
  xsc::common::scalar2vectorN_converter<1>* mp_M08_AXI_awvalid_converter;
  sc_signal< bool > m_M08_AXI_awvalid_converter_signal;
  xsc::common::vectorN2scalar_converter<1>* mp_M08_AXI_awready_converter;
  sc_signal< bool > m_M08_AXI_awready_converter_signal;
  xsc::common::vectorN2scalar_converter<32>* mp_M08_AXI_wdata_converter;
  sc_signal< sc_bv<1> > m_M08_AXI_wdata_converter_signal;
  xsc::common::vectorN2scalar_converter<4>* mp_M08_AXI_wstrb_converter;
  sc_signal< sc_bv<1> > m_M08_AXI_wstrb_converter_signal;
  xsc::common::scalar2vectorN_converter<1>* mp_M08_AXI_wlast_converter;
  sc_signal< bool > m_M08_AXI_wlast_converter_signal;
  xsc::common::vectorN2scalar_converter<1>* mp_M08_AXI_wuser_converter;
  sc_signal< sc_bv<1> > m_M08_AXI_wuser_converter_signal;
  xsc::common::scalar2vectorN_converter<1>* mp_M08_AXI_wvalid_converter;
  sc_signal< bool > m_M08_AXI_wvalid_converter_signal;
  xsc::common::vectorN2scalar_converter<1>* mp_M08_AXI_wready_converter;
  sc_signal< bool > m_M08_AXI_wready_converter_signal;
  xsc::common::scalar2vectorN_converter<1>* mp_M08_AXI_bid_converter;
  sc_signal< sc_bv<1> > m_M08_AXI_bid_converter_signal;
  xsc::common::scalar2vectorN_converter<1>* mp_M08_AXI_buser_converter;
  sc_signal< sc_bv<1> > m_M08_AXI_buser_converter_signal;
  xsc::common::vectorN2scalar_converter<1>* mp_M08_AXI_bvalid_converter;
  sc_signal< bool > m_M08_AXI_bvalid_converter_signal;
  xsc::common::scalar2vectorN_converter<1>* mp_M08_AXI_bready_converter;
  sc_signal< bool > m_M08_AXI_bready_converter_signal;
  xsc::common::vectorN2scalar_converter<1>* mp_M08_AXI_arid_converter;
  sc_signal< sc_bv<1> > m_M08_AXI_arid_converter_signal;
  xsc::common::vectorN2scalar_converter<32>* mp_M08_AXI_araddr_converter;
  sc_signal< sc_bv<1> > m_M08_AXI_araddr_converter_signal;
  xsc::common::vectorN2scalar_converter<8>* mp_M08_AXI_arlen_converter;
  sc_signal< sc_bv<1> > m_M08_AXI_arlen_converter_signal;
  xsc::common::vectorN2scalar_converter<1>* mp_M08_AXI_aruser_converter;
  sc_signal< sc_bv<1> > m_M08_AXI_aruser_converter_signal;
  xsc::common::scalar2vectorN_converter<1>* mp_M08_AXI_arvalid_converter;
  sc_signal< bool > m_M08_AXI_arvalid_converter_signal;
  xsc::common::vectorN2scalar_converter<1>* mp_M08_AXI_arready_converter;
  sc_signal< bool > m_M08_AXI_arready_converter_signal;
  xsc::common::scalar2vectorN_converter<1>* mp_M08_AXI_rid_converter;
  sc_signal< sc_bv<1> > m_M08_AXI_rid_converter_signal;
  xsc::common::scalar2vectorN_converter<32>* mp_M08_AXI_rdata_converter;
  sc_signal< sc_bv<1> > m_M08_AXI_rdata_converter_signal;
  xsc::common::vectorN2scalar_converter<1>* mp_M08_AXI_rlast_converter;
  sc_signal< bool > m_M08_AXI_rlast_converter_signal;
  xsc::common::scalar2vectorN_converter<1>* mp_M08_AXI_ruser_converter;
  sc_signal< sc_bv<1> > m_M08_AXI_ruser_converter_signal;
  xsc::common::vectorN2scalar_converter<1>* mp_M08_AXI_rvalid_converter;
  sc_signal< bool > m_M08_AXI_rvalid_converter_signal;
  xsc::common::scalar2vectorN_converter<1>* mp_M08_AXI_rready_converter;
  sc_signal< bool > m_M08_AXI_rready_converter_signal;

};
#endif // XM_SYSTEMC
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
