cropinghigh/zynq_a9_mb/(commit log)

2026-01-08 upload software&build instructions
    [1066mhz_4x128mx16.cfg, 1066mhz_4x256mx16.cfg, 800mhz_2x128mx16.cfg, 800mhz_2x256mx16.cfg, 800mhz_4x128mx16.cfg, 800mhz_4x256mx16.cfg, K4B4G1646D-BCMA.cfg, MT41K256M16HA-125E.cfg]
2026-01-08 Update to v1.2 board&update readme
    [hdmi_adapter.kicad_pcb, hdmi_adapter.kicad_sch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]
2026-01-08 update pdf schematic
2026-01-08 forgot to update revision on pcb
    [zynq_test-B_Cu.gbr, zynq_test-B_Mask.gbr, zynq_test-B_Paste.gbr, zynq_test-B_Silkscreen.gbr, zynq_test-Edge_Cuts.gbr, zynq_test-F_Cu.gbr, zynq_test-F_Mask.gbr, zynq_test-F_Paste.gbr]
2026-01-26 upload building and flashing instructions
    [zynq_test_components_1.2.ods]
